PanGucheng/ISE_prj/doc/P9_ADS1115与MCP4725板级诊断工程计划.md

# finger_piano P9 ADS1115 与 MCP4725 板级诊断工程计划

> **Status**: READY_FOR_BOARD_TEST（软件准备 COMPLETE：verify/implement/bitstream 全过、SHA256 已记录；BOARD TEST = WAITING USER，烧录须用户明确授权）  
> **Scope**: 为下一次实物板测准备一个独立、可观测、低风险的 ADC/DAC 诊断 bitstream  
> **Depends on**: P1～P7；建议 P8 完成后再执行  
> **Main finger_piano project**: FROZEN  
> **Main Stage-2 top/UCF**: 不修改  
> **Hardware programming**: 本计划软件准备阶段 FORBIDDEN  
> **Board measurement**: USER + oscilloscope / logic analyzer / multimeter  
> **Purpose**: 把 ADS1115 / MCP4725 板级排故从完整电子琴中拆出来，提供确定输入、确定输出、明确状态脚

---

## 0. 当前背景

正式 Stage-2 已冻结：

```text
P31/P32        ADS1115 I2C
P102/P103      MCP4725 I2C
P110/P111/P113 note_debug
```

P7 已经独立验证 FPGA 编程链与 ISF 写入流程，并准备好 clock-test 与 Stage-2 recovery bitstream。

P9 不直接拿完整：

```text
sensor → DDS → MCP4725
ADS1115 → pressure
```

系统做第一轮外设排故。

而是建立一个最小板级诊断工程，用于回答：

```text
FPGA alive?
ADS1115 ACK?
ADS1115 是否持续产生完整三通道 frame?
MCP4725 ACK?
MCP4725 是否真正更新模拟输出?
是否发生过 I2C sticky error?
```

---

## 1. 独立工程

新增：

```text
projects/finger_piano_periph_test/
├── project.json
├── README.md
├── src/
│   └── periph_test_top.v
├── constraints/
│   └── periph_test.ucf
└── sim/
    └── tb_periph_test_top.v
```

允许直接复用正式工程的已有 RTL source 与行为模型，不复制出第二套 driver 实现。

---

## 2. 器件、时钟、复位

器件固定：

```text
xc3s50an-4-tqg144
```

时钟：

```text
P57 / 12 MHz
```

复位：

```text
P3 / rst_n
```

全工程仍只有：

```text
clk
```

一个时钟域。

---

## 3. 物理引脚冻结

P9 只使用已经确认过的引脚：

| Signal | LOC | 用途 |
|---|---:|---|
| `clk` | P57 | 12 MHz |
| `rst_n` | P3 | reset |
| `adc_i2c_scl` | P31 | ADS1115 SCL |
| `adc_i2c_sda` | P32 | ADS1115 SDA |
| `dac_i2c_scl` | P102 | MCP4725 SCL |
| `dac_i2c_sda` | P103 | MCP4725 SDA |
| `dbg_alive` | P110 | 系统 heartbeat |
| `dbg_adc` | P111 | ADC frame activity |
| `dbg_error` | P113 | sticky error |

全部：

```text
LVCMOS33
VCCO = 3.3 V
```

不新增任何 LOC。

---

## 4. 为什么复用 P110/P111/P113

P9 是独立诊断 bitstream。

因此：

```text
P110/P111/P113
```

在 P9 中可以临时重定义为：

```text
P110 = dbg_alive
P111 = dbg_adc
P113 = dbg_error
```

正式 Stage-2 的 `note_debug` 定义不修改。

---

## 5. 两条 I²C 继续独立

必须保持：

```text
ADS1115 bus:
P31/P32

MCP4725 bus:
P102/P103
```

禁止：

```text
shared SCL/SDA
arbiter
bus mux
```

---

## 6. I²C 电气规则

真实板上：

```text
SCL/SDA → pull-up → 3.3 V
```

P9 UCF 不添加：

```text
PULLUP
```

作为真实板级电阻替代。

所有 I²C 输出仍必须保持：

```text
0 / Z
```

开漏语义。

---

## 7. 顶层职责

`periph_test_top.v` 只负责：

```text
reset
+
ADS1115 controller
+
MCP4725 diagnostic source/controller
+
debug/status aggregation
```

第一版不实例化：

```text
sensor frontend
pressure processor
七音 DDS
display
UART
LM386 control
```

诊断工程越小越好。

---

## 8. dbg_alive

P110 输出 `dbg_alive`。

建议为：

```text
约 1 Hz 或 2 Hz heartbeat
```

由 12 MHz 主时钟同步计数产生 GPIO 翻转。

禁止把 heartbeat 当内部时钟。

其唯一意义是：

```text
FPGA configured
clock running
reset released
top-level alive
```

它不代表 ADC/DAC PASS。

---

## 9. dbg_adc

P111 输出 `dbg_adc`。

推荐语义：

> 每完成一个完整 ADS1115 三通道 frame，翻转一次。

不要直接输出 1 个 12 MHz 周期宽度的 `adc_sample_valid`，因为板上不容易观察。

推荐：

```text
complete ADC frame
      ↓
toggle dbg_adc
```

---

## 10. dbg_error

P113 输出 sticky error：

```text
dbg_error = adc_error OR dac_error OR dac_overrun
```

一旦发生任意错误：

```text
dbg_error = 1
```

保持到下一次 reset。

第一版不做复杂 blink code / Morse code / 多错误编码。

---

## 11. ADS1115 诊断配置冻结

继续使用当前已验证配置：

```text
address = 0x48
ADDR = GND
PGA = ±4.096 V
DR = 860 SPS
single-shot
CH0/CH1/CH2 轮询
OS polling
```

P9 不修改正式 ADS1115 driver 行为。

---

## 12. ADS1115 输入原则

第一轮板测不要求 FSR 完整标定。

可选择：

```text
AIN0 → GND
AIN1 → 已知分压
AIN2 → 另一已知分压
```

或使用真实 FSR 前端。

P9 RTL 不依赖具体输入电压。

P9 只验证：

```text
通信存在
转换存在
完整 frame 持续形成
```

不完成压力校准。

---

## 13. MCP4725 诊断模式

建议实现 compile-time / parameter：

```text
DAC_TEST_MODE
```

不新增 mode pin。

推荐四种模式：

```text
MODE 0 = 0x800 中点 DC
MODE 1 = 0x400 低值 DC
MODE 2 = 0xC00 高值 DC
MODE 3 = 1 kHz / 8 kS/s 周期波形
```

---

## 14. DAC DC 模式

### 0x800

理论：

```text
VOUT ≈ VDD/2
```

若 VDD=3.3V，约 1.65V，仅作为理论参考，实际值必须由用户测量。

### 0x400 / 0xC00

用于确认：

```text
0x400 < 0x800 < 0xC00
```

对应 VOUT 单调增加。

P9 软件不得提前声称实际电压合格。

---

## 15. 1 kHz 诊断波形

推荐：

```text
sample rate = 8 kS/s
period = 8 samples
frequency = 1 kHz
center = 2048
```

第一版优先使用独立 8-sample test waveform generator，不修改正式七音 DDS 表。

示例波形可以围绕 2048：

```text
2048
3315
3840
3315
2048
781
256
781
```

最终常量必须由 Agent 离线公式复核，并由 TB 独立验证。

---

## 16. Sample cadence

保持：

```text
12 MHz / 1500 = 8 kS/s
```

只生成 clock-enable。

禁止生成：

```text
clk_8k
```

作为第二时钟域。

---

## 17. MCP4725 协议冻结

继续：

```text
address = 0x60
Fast Write only
no EEPROM audio writes
```

P9 诊断工程不得为了“方便”写 EEPROM。

---

## 18. Reset 行为

当：

```text
rst_n = 0
```

要求：

```text
heartbeat counter reset
dbg_alive = 0
dbg_adc = 0
dbg_error = 0
ADC controller reset
DAC controller reset
两条 I2C bus release
```

释放后重新开始完整诊断流程。

---

## 19. 仿真模型

复用正式工程已有：

```text
projects/finger_piano/sim/models/ads1115_model.v
projects/finger_piano/sim/models/mcp4725_model.v
```

不要复制第二套行为模型。

---

## 20. 顶层 TB

新增：

```text
projects/finger_piano_periph_test/sim/tb_periph_test_top.v
```

必须验证：

```text
reset
heartbeat
ADS scan
ADC frame toggle
DAC write
sticky error
dual bus independence
```

并打印：

```text
TB_PERIPH_TEST_TOP: PASS
```

---

## 21. TB：heartbeat

检查 `dbg_alive` 按冻结周期翻转。

heartbeat 频率只要求确定、可测，不用于课程频率精度结论。

---

## 22. TB：ADS 正常活动

ADS model 正常响应时：

```text
dbg_adc
```

必须持续翻转。

至少验证多个完整三通道 frame。

---

## 23. TB：ADS NACK 隔离

注入 ADS NACK：

要求：

```text
dbg_error → 1
DAC bus 继续运行
```

说明 ADC 错误不能拖死 DAC。

---

## 24. TB：DAC NACK 隔离

注入 MCP4725 NACK：

要求：

```text
dbg_error → 1
ADS frame activity 继续
```

---

## 25. TB：sticky error

错误发生一次后：

```text
dbg_error = 1
```

即使总线恢复也继续保持 1。

只有：

```text
reset
```

可以清除。

---

## 26. TB：DAC DC 模式

分别测试：

```text
0x400
0x800
0xC00
```

MCP4725 model 捕获 code 必须与预期完全一致。

---

## 27. TB：1 kHz 模式

至少捕获数百个 sample，验证：

```text
8-sample sequence 重复
8 kS/s cadence
no overrun
no mismatch
no EEPROM write
```

---

## 28. 独立项目 warning policy

P9 不使用正式 `finger_piano` 的 166-warning allowlist。

> **P9-E 修正（实际结果口径）**：诊断顶层刻意不消费 ADS1115 转换值
> （§12）且 `DAC_TEST_MODE` 是编译期常量（DC 模式使 DAC 载荷恒定），
> XST 对这些结构的 trim 是**结构性的**，无法在不改动 driver 例化语义
> 的前提下消除。实际结果：**144 条 synthesis warnings，全部逐行人工
> 审核并折入本工程自己的精确 allowlist（逐条 id+pattern+expected）；
> unexpected warnings = 0；latches = 0；XST errors = 0**。任何新
> warning、路径变化或计数漂移仍判 FAIL。正式 `finger_piano` 的
> 166-warning allowlist **未修改**，两个工程的 allowlist 互不相干。

---

## 29. UCF

只允许以下 9 个用户 I/O：

```text
P57
P3
P31
P32
P102
P103
P110
P111
P113
```

以及：

```text
TS_clk = PERIOD 83.33 ns
```

禁止：

```text
PULLUP
OFFSET
自动 LOC
额外 debug pin
```

---

## 30. Verify / Implement / Bitstream

执行：

```powershell
pwsh -File .\ise.ps1 verify -Project finger_piano_periph_test
pwsh -File .\ise.ps1 build -Project finger_piano_periph_test -Stage implement
pwsh -File .\ise.ps1 build -Project finger_piano_periph_test -Stage bitstream
```

要求：

```text
verify PASS
synthesis warnings: 144 audited（工程独立 allowlist）/ 0 unexpected
latches = 0
MAP/PAR PASS
Timing Score = 0
all 9 pins LOCATED
bitstream generated
```

---

## 31. Bitstream 记录

记录：

```text
run id
SHA256
size
device
commit
DAC_TEST_MODE
```

避免板测时混淆镜像。

---

## 32. 软件阶段到此停止

软件准备完成后状态：

```text
P9 SOFTWARE PREPARATION = COMPLETE
PERIPH DIAGNOSTIC BITSTREAM = READY
BOARD TEST = WAITING USER
```

Agent 必须停止。

即使 bitstream 已生成，也禁止自动：

```text
program -Mode Jtag
program -Mode Isf
```

---

## 33. 推荐板测顺序（用户执行）

### Step 1 — 最小接线

只连接：

```text
FPGA
ADS1115
MCP4725
```

暂时不接 LM386 / speaker。

### Step 2 — JTAG volatile program

用户明确授权后写入 P9 bitstream。

先观察：

```text
P110 dbg_alive
```

如果 heartbeat 不存在，优先查 FPGA / clock / reset，不查 I2C。

### Step 3 — 检查 sticky error

若：

```text
P113 = 1
```

说明至少一个外设事务曾失败。

用逻辑分析仪分别检查：

```text
P31/P32
P102/P103
```

### Step 4 — ADS activity

观察：

```text
P111 dbg_adc
```

如果 heartbeat 正常但 P111 不动，优先检查 ADS1115 地址、供电、上拉和 ACK。

### Step 5 — 测 DAC DC

依次测：

```text
0x400
0x800
0xC00
```

确认 VOUT 单调。

### Step 6 — 测 1 kHz

测 MCP4725 VOUT：

```text
中心
幅值
频率
8 kS/s staircase
```

### Step 7 — 再接重构滤波

比较：

```text
滤波前 staircase
滤波后 smoother waveform
```

LM386 不属于本阶段。

---

## 34. 板测记录表

在 `projects/finger_piano_periph_test/README.md` 预留：

| 项目 | 理论/预期 | 实测 | 结果 |
|---|---|---|---|
| P110 heartbeat | 固定慢速翻转 | TODO | TODO |
| P111 ADC toggle | 持续活动 | TODO | TODO |
| P113 error | 正常时 0 | TODO | TODO |
| ADC SCL | 约 333 kHz | TODO | TODO |
| DAC SCL | 约 333 kHz | TODO | TODO |
| DAC 0x400 VOUT | 低于 0x800 | TODO | TODO |
| DAC 0x800 VOUT | 约 VDD/2 | TODO | TODO |
| DAC 0xC00 VOUT | 高于 0x800 | TODO | TODO |
| DAC 1kHz | 1 kHz | TODO | TODO |

所有实测值必须由用户填写。

---

## 35. 板级结论边界

即使逻辑分析仪能正确解码 I²C，也不能自动声称：

```text
I2C rise time PASS
```

上升沿必须用示波器测。

看到 ADS1115 raw code 在变化也只能证明：

```text
通信存在
转换存在
```

不能自动声称：

```text
ADC absolute accuracy PASS
```

除非已知输入电压和参考仪器都被实际测量。

---

## 36. 不填写 pressure calibration

P9 完成后：

```text
projects/finger_piano/pressure_calibration.md
```

仍保持：

```text
NOT_CALIBRATED
```

除非用户实际完成 FSR + 模拟前端采样。

---

## 37. Stage-2 Recovery

P9 板测完成后是否恢复：

```text
finger_piano_stage2_top
```

由用户决定。

Agent 不得自动写回 Stage-2 ISF。

---

## 38. 推荐提交序列

### P9-A — Plan + Project Skeleton

新增：

```text
doc/P9_ADS1115与MCP4725板级诊断工程计划.md
projects/finger_piano_periph_test/
```

### P9-B — Debug/Status Top

实现：

```text
dbg_alive
dbg_adc
dbg_error
```

以及双 I²C controller 接线。

### P9-C — DAC Diagnostic Modes

加入：

```text
0x400
0x800
0xC00
1 kHz waveform
```

### P9-D — Simulation

覆盖：

```text
normal
ADC NACK
DAC NACK
sticky error
reset
DC modes
1 kHz mode
```

### P9-E — Verify / Implement / Bitstream

要求：

```text
verify PASS（warnings: 144 audited / 0 unexpected，见 §28 修正）
fully routed
timing pass
SHA256 recorded
```

### P9-F — Docs Closeout

状态更新为：

```text
READY_FOR_BOARD_TEST
```

并停止。

---

## 39. Agent 停止条件

发生任一项必须停止：

```text
新增未确认 LOC
synthesis warning
second clock domain
I2C bus 被共享
ADC/DAC driver 被重写
EEPROM write path 被启用
仿真回归 FAIL
正式 finger_piano 被功能修改
需要硬件 program
```

---

## 40. 严禁行为

Agent 不得：

```text
修改正式 Stage-2 UCF
修改正式 pin map
修改 finger_piano warning allowlist
猜 FSR 校准数据
猜 ADS1115 实测电压
声称 DAC 模拟输出已通过
声称 LM386 已通过
自动 JTAG program
自动 ISF program
自动写 recovery bitstream
```

---

## 41. 最终软件验收清单

```text
[ ] finger_piano_periph_test 独立工程存在
[ ] 正式 finger_piano 未改
[ ] clk = P57
[ ] rst_n = P3
[ ] ADC = P31/P32
[ ] DAC = P102/P103
[ ] debug = P110/P111/P113

[ ] 双 I2C 独立
[ ] open-drain 0/Z
[ ] 无内部 PULLUP
[ ] 无第二时钟域

[ ] heartbeat 存在
[ ] ADC frame toggle 存在
[ ] sticky error 存在

[ ] DAC 0x400 模式 PASS
[ ] DAC 0x800 模式 PASS
[ ] DAC 0xC00 模式 PASS
[ ] DAC 1kHz 数字波形模式 PASS

[ ] ADC NACK isolation PASS
[ ] DAC NACK isolation PASS
[ ] reset recovery PASS

[ ] synthesis 0 errors
[ ] synthesis warnings 144 audited / 0 unexpected（本工程独立 allowlist；
    正式 finger_piano 166 条未修改）
[ ] synthesis 0 latches
[ ] MAP/PAR PASS
[ ] timing PASS
[ ] 9 pins LOCATED
[ ] bitstream SHA256 recorded

[ ] 未执行 program
[ ] BOARD TEST = WAITING USER
[ ] FSR = NOT_CALIBRATED
[ ] LM386 = NOT_TESTED
[ ] SPEAKER = NOT_TESTED
```

---

## 42. Agent 执行提示

> 按本计划建立独立 `projects/finger_piano_periph_test`，复用现有 ADS1115/MCP4725/I2C RTL 和已有行为模型，不修改正式 `finger_piano`。诊断顶层固定使用 P57/P3、ADS P31/P32、DAC P102/P103、debug P110/P111/P113；debug 定义为 alive / ADC frame toggle / sticky error。加入 DAC 0x400、0x800、0xC00 与固定 1 kHz/8 kS/s 诊断波形模式。要求独立工程 synthesis 0 warning、仿真全 PASS、implement/timing PASS、bitstream SHA256 记录。软件准备完成后立即停止；禁止任何 JTAG/ISF program，等待用户明确授权。
