PanGucheng/ISE_prj/doc/P6最终顶层迁移与系统级数字集成计划.md

---

# finger_piano P6 最终顶层迁移与系统级数字集成计划

> **Status**: P6A COMPLETE + **P6B COMPLETE**（STAGE2 TOP = IMPLEMENTED / SIMULATED / IMPLEMENTED；BOARD = NOT_TESTED）
> **Scope**: stage-2 system integration + system-level ISim + gated top/UCF migration
> **Depends on**: P1 + P2 + P3 + P4 + P5 全部 `SIMULATED / STANDALONE`
> **Top integration**: P6A NO → P6B YES（用户 2026-09-16 逐脚确认后完成）
> **UCF changes**: 已完成（12 脚冻结分配）
> **Hardware programming**: FORBIDDEN，除非用户之后单独明确要求
> **Acceptance**: system-level simulations + full `verify` + final top/UCF review

---

## 0.1 P6B 完成记录（2026-09-16）

```text
P6A SYSTEM CORE      INTEGRATED / SIMULATED
STAGE2 TOP           IMPLEMENTED（src/finger_piano_stage2_top.v,wrapper only）
STAGE2 TOP SIM       PASS（sim/tb_finger_piano_stage2_top.v,29 checks）
UCF                  CONFIRMED / FROZEN
IMPLEMENTATION       PASS（MAP/PAR 0/0,全布线,Timing Score 0）
TIMING               PASS（TS_clk = PERIOD 83.33 ns,0 timing errors,最差 slack 70.968 ns）

BOARD                  NOT_TESTED
FSR CALIBRATION        NOT_CALIBRATED
MCP4725 ANALOG OUTPUT  NOT_TESTED
LM386 / SPEAKER        NOT_TESTED
```

最终引脚（用户 2026-09-16 确认,全部 LVCMOS33,VCCO 全 3.3 V）：

| Signal | LOC | Bank |
|---|---|---|
| clk | P57 | 2 |
| rst_n | P3 | 3 |
| sensor_async[0..2] | P28/P29/P30 | 3 |
| adc_i2c_scl/sda | P31/P32 | 3 |
| dac_i2c_scl/sda | P102/P103 | 1 |
| note_debug[0..2] | P110/P111/P113 | 0 |

证据：全量 `verify-20260916-153554-00e49086` Overall PASS（综合 0 errors /
166 已审阅 trim 告警 / 0 unexpected / 0 latches / 12 IOs；33 仿真全 PASS）；
实现 `20260916-154225-79f5b654`；详细记录见
`projects/finger_piano/README.md` §13 第十四轮。当前 12 脚顶层无压力数据
消费方，ADS1115 压力链被 XST 合法 trim（已审阅白名单），
`pressure_calibration.md` 仍为 `NOT_CALIBRATED`。**未执行任何 `program`。**

---

## 0. 当前前提

P1～P5 已完成独立 RTL 和仿真：

```text
P1:
i2c_master
ads1115_ctrl
mcp4725_ctrl

P2:
sensor_code_frontend
sensor_code_filter
sensor_code_decoder

P3:
dds_sine_generator
sine_lut_12bit

P4:
dds_mcp4725_pipeline

P5:
pressure_frame_capture
pressure_channel_corrector
pressure_processor
```

当前正式顶层仍为 legacy：

```text
key_in[6:0]
  ↓
key_sync
  ↓
key_filter
  ↓
note_encoder
  ↓
tone_generator
  ↓
audio_out
```

这条路径在本计划第一阶段仍然保持不动。

---

# 1. 本阶段最终目标

最终数字结构：

```text
                     ┌──────────────────────────────┐
LM393 ×3             │                              │
   ↓                 │                              │
sensor_async[2:0]    │                              │
   ↓                 │                              │
sensor_code_frontend │                              │
   ↓                 │                              │
note_code[2:0] ──────┼────→ DDS → MCP4725 ctrl ───┼→ DAC I2C
                     │                              │
                     │                              │
ADS1115 I2C ─────────┼→ ads1115_ctrl                │
                     │       ↓                      │
                     │   raw CH0/1/2                │
                     │       ↓                      │
                     │ pressure_processor           │
                     │       ↓                      │
                     │ pressure CH0/1/2             │
                     └──────────────────────────────┘
```

注意：

> P6 只负责把现有模块连接成完整系统。

本阶段仍然**不决定压力如何映射到音量或音高**。

所以压力链：

```text
ADS1115 → pressure_processor
```

先正常工作、输出数据即可。

它不能偷偷影响 DDS amplitude、phase 或 note selection。

---

# 2. 为什么不直接修改 `finger_piano_top.v`

现在仍有两个现实条件没有完成：

```text
1. 3 × LM393 的最终 FPGA LOC 未逐脚确认
2. ADC/DAC 两套 I²C 的 4 个最终 LOC 未逐脚确认
```

因此如果现在直接把正式 top 改成 stage-2：

```text
project top
→ 多出 7 个真实 I/O
→ UCF 尚无确认 LOC
```

就会破坏目前已经验证的 implementation baseline。

所以 P6 分成：

```text
P6A：纯数字系统集成
     不改正式 top / 不改 UCF

P6B：板级顶层迁移
     只有用户确认 7 个接口信号后才能执行
```

P6A 可以立即由 Agent 完成。

P6B 必须等待人工确认。

---

# 3. 第一件事：先做文档 closeout

在写新 RTL 前先做一个很小的文档提交。

修复：

```text
P1 plan Status: PLANNED
→ IMPLEMENTED / SIMULATED / STANDALONE

P5 plan Status: PLANNED
→ IMPLEMENTED / SIMULATED / STANDALONE / NOT_CALIBRATED
```

同时修复：

```text
README 中：
P2/P4/P5 “X 个提交”数量措辞
旧 stage-1 当前时态
旧 P1..P40 可用范围措辞
```

推荐不要修改历史验证结果，只给旧章节增加：

```markdown
> 本节记录 legacy stage-1 baseline。
> 当前 P1~P5 扩展状态见 §12。
```

---

# 4. `CFG_DDS_PHASE_BITS` 收尾

当前：

```verilog
`define CFG_DDS_PHASE_BITS 24
```

但 DDS RTL 本身固定：

```verilog
reg [23:0] phase_acc;
```

P6 前建议消除这个伪参数。

推荐：

> 保持 DDS 24-bit 固定实现，删除或明确废弃 `CFG_DDS_PHASE_BITS`。

不要为了泛化而重构 DDS。

24-bit 已经满足本项目要求。

---

# 5. 新增 system core

建议新增：

```text
projects/finger_piano/src/system/
    finger_piano_system.v
```

这个模块不是 FPGA package top。

它是：

> **stage-2 逻辑系统边界。**

---

# 6. 推荐 `finger_piano_system` 接口

建议：

```verilog
module finger_piano_system #(
    parameter integer SYS_CLK_HZ = `SYS_CLK_HZ,
    parameter integer SENSOR_ACTIVE_HIGH = 1,
    parameter integer SENSOR_FILTER_ENABLE = 1,
    parameter integer ENABLE_ADC = 1,
    parameter integer ENABLE_DAC = 1
) (
    input  wire        clk,
    input  wire        rst_n_sync,

    input  wire [2:0]  sensor_async,

    inout  wire        adc_i2c_scl,
    inout  wire        adc_i2c_sda,

    inout  wire        dac_i2c_scl,
    inout  wire        dac_i2c_sda,

    output wire [2:0]  sensor_code_stable,
    output wire [2:0]  note_code,

    output wire [14:0] pressure_ch0,
    output wire [14:0] pressure_ch1,
    output wire [14:0] pressure_ch2,
    output wire        pressure_valid,

    output wire        adc_error,
    output wire        dac_error,
    output wire        dac_overrun
);
```

不要在这里加入：

```text
physical pin
key_in[6:0]
legacy audio_out
LM386 analog control
display driver
volume control
```

这些不是 system core 的职责。

---

# 7. Reset仍然只在外层产生一次

当前 legacy top 已有：

```text
rst_n
 ↓
reset_sync
 ↓
rst_n_sync
```

stage-2 system core 输入直接使用：

```text
rst_n_sync
```

因此：

> `finger_piano_system.v` 不得再次实例化 `reset_sync`。

未来正式 top：

```text
rst_n
 ↓
reset_sync
 ↓
rst_n_sync
 ├→ sensor frontend
 ├→ ADC
 ├→ DAC
 └→ pressure processor
```

所有模块共用一个同步释放复位。

---

# 8. 音符输入链连接

直接实例化：

```text
sensor_code_frontend
```

结构：

```text
sensor_async[2:0]
     ↓
polarity normalization
     ↓
2FF synchronization
     ↓
whole-vector atomic filter
     ↓
sensor_code_stable
     ↓
decoder
     ↓
note_code
```

禁止重新实现：

```text
key_sync
filter
decoder
```

P6 只能复用 P2。

---

# 9. P6 中不再存在 `key_in[6:0]`

stage-2 system core：

```text
没有 key_in[6:0]
```

真实输入只有：

```text
sensor_async[2:0]
```

也不要在 system core 内做：

```text
7-key ↔ 3-bit compatibility mux
```

legacy compatibility 保留在原：

```text
finger_piano_top
```

而不是污染新架构。

---

# 10. DDS/DAC连接

直接实例化已有：

```text
dds_mcp4725_pipeline
```

输入：

```text
note_code
```

输出：

```text
dac_i2c_scl
dac_i2c_sda
dac_error
dac_overrun
```

即：

```text
sensor frontend
      ↓
note_code
      ↓
dds_mcp4725_pipeline
      ↓
MCP4725 I2C
```

P6 不重新实例化：

```text
dds_sine_generator + mcp4725_ctrl
```

因为 P4 wrapper 已经定义了这个边界。

---

# 11. ADC/压力连接

实例化：

```text
ads1115_ctrl
        ↓
pressure_processor
```

具体：

```text
ads1115_ctrl.adc_ch0_raw
        ↓
pressure_processor.adc_ch0_raw

ads1115_ctrl.adc_ch1_raw
        ↓
pressure_processor.adc_ch1_raw

ads1115_ctrl.adc_ch2_raw
        ↓
pressure_processor.adc_ch2_raw

ads1115_ctrl.adc_sample_valid
        ↓
pressure_processor.adc_sample_valid
```

最后输出：

```text
pressure_ch0
pressure_ch1
pressure_ch2
pressure_valid
```

---

# 12. 压力链与音符链保持解耦

系统级结构必须保持：

```text
LM393
 ↓
note selection
```

和：

```text
ADS1115
 ↓
pressure magnitude
```

互相独立。

不要写：

```verilog
if (pressure_ch0 > ...)
    note_code = ...
```

也不要：

```verilog
dac_code = dac_code * pressure;
```

这些属于后续 P7：

> 压力到音量控制映射计划

不是 P6。

---

# 13. ADS 与 DAC 仍是两条独立 I²C

system core 端口必须是：

```text
adc_i2c_scl
adc_i2c_sda

dac_i2c_scl
dac_i2c_sda
```

不能合成：

```text
i2c_scl
i2c_sda
```

也不能添加：

```text
arbiter
shared bus scheduler
```

P1 的双总线架构继续冻结。

---

# 14. system core 不产生物理 `audio_out`

stage-2 数字音频真正的物理输出已经变成：

```text
MCP4725 VOUT
```

不是 FPGA 方波。

所以：

```text
finger_piano_system
```

不需要：

```text
audio_out
```

输出。

legacy `finger_piano_top.audio_out` 仍然继续存在，直到最终顶层迁移。

---

# 15. 新增系统级行为模型 TB

建议新增：

```text
sim/tb_finger_piano_system.v
```

同时复用：

```text
sim/models/ads1115_model.v
sim/models/mcp4725_model.v
```

完整仿真：

```text
sensor input
     ↓
P2 frontend
     ↓
note_code
     ↓
P4 DDS/DAC pipeline
     ↓
MCP model

同时：

ADS model
     ↓
ADS controller
     ↓
pressure processor
```

这是目前还没有的真正**全系统数字仿真**。

---

# 16. System TB的核心目标

P1～P5 各自 PASS 不代表组合系统必然 PASS。

必须证明：

```text
两个 I2C controller 同时工作
+
sensor frontend 同时工作
+
DDS 8k cadence 同时工作
+
ADC continuous scan 同时工作
+
pressure processing 同时工作
```

在：

```text
12 MHz
```

唯一系统时钟下不会互相干扰。

---

# 17. 必测初始化

Reset 时：

```text
note_code = 0
sensor_code_stable = 000

pressure = 0

DAC pipeline idle/reset
ADC controller reset

两条 I2C bus release
```

释放 reset 后：

```text
ADC 开始独立扫描
DAC 等 DDS sample
```

不得出现 X propagation。

---

# 18. 系统级 Sensor → Note → DAC 测试

至少完整走：

```text
000
001
010
011
100
101
110
111
000
```

要求每次只有在：

```text
whole-vector filter
```

达到稳定门限后：

```text
note_code
```

才改变。

MCP4725 捕获的数字音频随后必须对应：

```text
mute
C4
D4
E4
F4
G4
A4
B4
mute
```

---

# 19. 中间码污染测试

重点刺激：

```text
001
 ↓
011 short
 ↓
101 short
 ↓
111 stable
```

只允许：

```text
C4
↓
B4
```

DAC端不能出现：

```text
E4
G4
```

的持续音频流。

这一测试第一次真正跨越：

```text
sensor filter
→ decoder
→ DDS
→ I2C DAC
```

非常重要。

---

# 20. ADC与DAC同时运行测试

P1 之前的 ADC 和 DAC 是分开测的。

现在必须让：

```text
ADS1115 controller
```

和：

```text
DDS → MCP4725
```

在同一个 TB 中同时连续工作。

验证至少：

```text
ADC bus transaction count > 0
DAC bus transaction count > 0

ADC error = 0
DAC error = 0
DAC overrun = 0
```

证明两条独立总线没有 RTL 级共享状态。

---

# 21. Pressure全链路同时验证

ADS模型设置：

```text
CH0 = 1000
CH1 = 2000
CH2 = 3000
```

zero先使用默认：

```text
0 / 0 / 0
```

应得到：

```text
1000
2000
3000
```

再通过 TB 参数覆盖：

```text
100 / 200 / 300
```

应得到：

```text
900
1800
2700
```

这只是数字校正测试。

不能写：

```text
实物压力值
```

---

# 22. ADC数据变化不能影响当前音符

例如：

```text
sensor_code = 001
```

持续保持。

同时让 ADS：

```text
CH0:
500 → 5000 → 20000
```

要求：

```text
note_code始终 = C4
```

当前 P6 中 DAC 频率也不能改变。

这样可以锁死：

> 压力链和音符选择链没有意外耦合。

---

# 23. 音符变化不能破坏ADC扫描

反过来不断切：

```text
001
111
010
101
...
```

同时检查：

```text
adc_sample_valid
```

继续正常产生。

不允许因为 DDS / DAC 事务影响 ADS FSM。

---

# 24. 双I²C独立性故障测试

在 ADC 总线上注入：

```text
address NACK
```

同时 DAC 保持播放。

要求：

```text
ADC error = 1
```

但：

```text
DAC继续发送
DAC error = 0
DAC overrun = 0
```

反过来 DAC NACK：

```text
DAC error
```

不能影响：

```text
ADC frame
pressure_valid
```

这是真正验证“双物理总线”的关键系统级测试。

---

# 25. Reset系统级恢复

在以下状态下拉 reset：

```text
ADC 正在 I2C transaction
+
DAC 正在 Fast Write
```

要求：

```text
两个 bus 均释放

ADC busy清理
DAC busy清理

sensor stable恢复000
note_code恢复mute
pressure outputs恢复0
```

释放后：

```text
ADC重新开始完整scan
DAC重新开始完整Fast Write
```

不能延续半截事务。

---

# 26. 系统级长时间压力测试

推荐真实参数：

```text
SYS_CLK = 12 MHz
DAC fs = 8 kS/s
DAC I2C ≈333 kHz
ADC DR = 860 SPS
```

连续运行至少：

```text
8192 DAC samples
```

约：

```text
1.024 s audio time
```

期间：

```text
DAC mismatch = 0
DAC overrun = 0
DAC error = 0

ADC valid frames > 0
ADC error = 0

sensor code errors = 0
```

---

# 27. 不要求ADC达到严格固定frame rate

ADS1115：

```text
single-shot
+
三通道轮询
+
OS polling
```

所以 frame cadence不是固定精确周期。

System TB只要求：

```text
持续取得frame
不死锁
顺序正确
数值正确
```

不要像 DDS 那样强制每：

```text
N clocks
```

一个frame。

---

# 28. ENABLE组合测试

建议 system core 参数化：

```text
ENABLE_ADC
ENABLE_DAC
```

至少验证：

| ADC | DAC | 预期 |
| --- | --- | --- |
| 0 | 0 | 两总线静默 |
| 1 | 0 | ADC运行，DAC静默 |
| 0 | 1 | DAC运行，ADC静默 |
| 1 | 1 | 两条总线同时运行 |

这比单纯分别测 P1 更接近最终 integration。

---

# 29. 不增加系统级大FSM

`finger_piano_system.v` 应尽量只是：

```text
wiring + status aggregation
```

不要写：

```text
SYSTEM_IDLE
SYSTEM_ADC
SYSTEM_DAC
SYSTEM_RUN
```

这种总控 FSM。

ADC、DAC、sensor frontend 自己已经有状态机。

顶层不应该再调度它们。

---

# 30. 系统级 error输出

建议只汇总：

```text
adc_error
dac_error
dac_overrun
```

不要现在设计复杂：

```text
global_error_code[7:0]
```

因为：

```text
ADC error domain
DAC error domain
```

语义不同。

以后显示/调试层可独立处理。

---

# 31. `project.json` 第一阶段变更

P6A 时加入：

```text
src/system/finger_piano_system.v
```

和：

```text
sim/tb_finger_piano_system.v
```

以及模型依赖。

但：

```json
"top": "finger_piano_top"
```

仍保持不变。

所以现有正式 implementation 继续是 legacy。

---

# 32. 推荐新增 simulation

建议至少：

```text
system_stage2_basic
system_stage2_dual_i2c
system_stage2_error_isolation
system_stage2_longrun
system_stage2_disabled
```

统一：

```text
TB_FINGER_PIANO_SYSTEM: PASS
```

---

# 33. 第一阶段的综合资源预期

由于：

```text
finger_piano_system
```

仍未被正式 top 引用，

legacy synthesis 应继续：

```text
232 FF
20 I/O
```

左右保持不变。

如果资源突然大幅增加：

> 说明不小心已经把 stage-2 接进 legacy top。

P6A 应立即停止检查。

---

# 34. P6A验收线

P6A 完成时必须同时满足：

```text
legacy top unchanged

stage2 system TB PASS

P1 TB PASS
P2 TB PASS
P3 TB PASS
P4 TB PASS
P5 TB PASS

full verify PASS

legacy synthesis:
0 errors
0 warnings
0 latches
I/O count unchanged
```

完成后状态：

```text
SYSTEM DIGITAL INTEGRATION
= SIMULATED / STANDALONE

FINAL TOP
= NOT MIGRATED
```

---

# 35. P6B启动的唯一人工阻塞

P6B开始前必须由用户确认：

```text
sensor_async[0] → ?
sensor_async[1] → ?
sensor_async[2] → ?

adc_i2c_scl → ?
adc_i2c_sda → ?

dac_i2c_scl → ?
dac_i2c_sda → ?
```

这是：

> **7个逻辑接口信号的最终引脚确认**

不一定代表需要“新增7个物理引脚”。

可以复用 legacy 迁移释放的 GPIO。

---

# 36. 推荐引脚决策记录格式

最终确认后在文档写：

| Signal | LOC | Bank/VCCO | IOSTANDARD | External circuit |
| --- | --- | --- | --- | --- |
| sensor_async[0] | Pxx | verified  | LVCMOS33 | LM393 CH0 |
| sensor_async[1] | Pxx | verified  | LVCMOS33 | LM393 CH1 |
| sensor_async[2] | Pxx | verified  | LVCMOS33 | LM393 CH2 |
| adc_i2c_scl | Pxx | verified  | LVCMOS33 | ADS1115 SCL |
| adc_i2c_sda | Pxx | verified  | LVCMOS33 | ADS1115 SDA |
| dac_i2c_scl | Pxx | verified  | LVCMOS33 | MCP4725 SCL |
| dac_i2c_sda | Pxx | verified  | LVCMOS33 | MCP4725 SDA |

没有：

```text
Bank VCCO
```

确认时不能只凭 package pin 可用就写 LOC。

---

# 37. P6B正式顶层选择

建议不要直接在 legacy `finger_piano_top.v` 上大面积编辑。

更安全的方案是新增：

```text
src/finger_piano_stage2_top.v
```

端口：

```verilog
module finger_piano_stage2_top (
    input  wire       clk,
    input  wire       rst_n,

    input  wire [2:0] sensor_async,

    inout  wire       adc_i2c_scl,
    inout  wire       adc_i2c_sda,

    inout  wire       dac_i2c_scl,
    inout  wire       dac_i2c_sda,

    output wire [2:0] note_debug
);
```

内部：

```text
reset_sync
+
finger_piano_system
```

这样 legacy top 完全保留。

---

# 38. 为什么建议新增 stage2 top

这样仓库同时保留：

```text
finger_piano_top
    = legacy baseline

finger_piano_stage2_top
    = final 3-sensor architecture
```

出问题时可以快速比较。

而不是：

```text
永久覆盖旧 top
```

后再靠 Git history 找。

这对课程答辩也有价值：

> 可以清楚展示基础版本和提高版本。

---

# 39. project top最终切换

只有 P6B 才修改：

```json
"top": "finger_piano_stage2_top"
```

并同步修改 UCF。

切换应该单独一个 commit。

这样任何 regression 都可以清楚定位到：

> final top cutover

而不是混在其它 RTL 提交里。

---

# 40. Legacy端口如何处理

stage2 top 不再需要：

```text
key_in[6:0]
key_debug[6:0]
audio_out
```

其中：

```text
audio_out
```

在 DDS/DAC 模式下也不再承担音频输出。

真实音频由：

```text
MCP4725 VOUT
```

进入 LM386。

所以 final stage2 UCF 应移除这些 legacy NET，除非用户明确想保留调试兼容。

---

# 41. 推荐保留 `note_debug`

建议 stage2 至少保留：

```text
note_debug[2:0]
```

原因是上板初期非常有价值：

```text
LM393
→ FPGA
→ stable code
→ decoder
```

是否正确可以直接观察。

如果 IO紧张，也可以后续删除。

---

# 42. 不建议保留 `key_debug[6:0]`

真实硬件已经不是7键。

如果需要 sensor debug，更合理的是：

```text
sensor_debug[2:0]
```

但是否保留由最终 IO预算决定。

本计划不强制。

---

# 43. Stage2 UCF重写原则

P6B时不要在原 legacy UCF 上零碎追加到最后。

推荐分区重整：

```text
CLOCK
RESET

SENSOR CODE INPUT

ADC I2C

DAC I2C

DEBUG

TIMING
```

删除已经不再是 top port 的：

```text
key_in
key_debug
audio_out
```

约束。

---

# 44. I²C上拉仍然是板级器件

UCF只写：

```text
LOC
IOSTANDARD=LVCMOS33
```

不能用 UCF 假装：

```text
4.7k pullup
```

真实 ADS/DAC 总线需要：

```text
SDA → 4.7k → 3.3V
SCL → 4.7k → 3.3V
```

两条总线分别检查模块自带上拉。

---

# 45. `constraintsReviewed`

P6B改 UCF 后：

> 不得沿用 legacy 的“已确认”结论直接声称新约束已审核。

应先将新 7 个接口逐个确认，然后重新检查：

```text
LOC
IOSTANDARD
VCCO
clock
reset
timing
```

只有完成后：

```text
constraintsReviewed=true
```

才有意义。

---

# 46. P6B新增正式top仿真

新增：

```text
tb_finger_piano_stage2_top.v
```

重点不是重复 system TB，而是验证：

```text
external rst_n
→ reset_sync
→ system

external sensor_async
→ system

top ports
→ I2C model
```

防止 wrapper 接错。

---

# 47. 顶层仿真至少覆盖

```text
reset
mute
C4
B4
mute

ADC frame
DAC output

both I2C active

sensor transition
```

以及：

```text
no X / Z misuse
```

注意：

I²C 线正常高电平来自 TB `pullup`。

---

# 48. 切换后必须重新综合

切换真正 stage2 top 后：

```text
232 FF / 20 IO
```

不再是期望值。

资源增长是正常的。

必须记录新的：

```text
FF
LUT
IO
```

基线。

此时才可以说：

> 新基础设施进入综合网表。

---

# 49. 新I/O数量预期

stage2最小顶层：

```text
clk           1
rst_n         1
sensor        3
ADC I2C       2
DAC I2C       2
note_debug    3 optional
```

若保留 note_debug：

```text
12 I/O
```

若不保留：

```text
9 I/O
```

实际数量以最终 top 为准。

不要把：

```text
20 I/O
```

继续当作 stage2验收标准。

---

# 50. Implement / timing

P6B UCF确认后运行：

```powershell
pwsh -File .\ise.ps1 verify -Project finger_piano
```

随后：

```powershell
pwsh -File .\ise.ps1 build -Project finger_piano -Stage implement
```

人工检查：

```text
MAP
PAR
timing.twr
```

仍然必须：

```text
0 errors
0 warnings
```

---

# 51. I²C时序不能仅靠静态时序报告判断

ISE timing 可以验证 FPGA 内部路径。

它不能证明：

```text
4.7k pullup
+
board capacitance
+
real SDA/SCL rise time
```

符合要求。

因此 stage2 implement PASS 之后状态仍只能是：

```text
DIGITAL IMPLEMENTATION PASS
```

不能：

```text
I2C BOARD PASS
```

---

# 52. 本计划不烧录

即使：

```text
stage2 bitstream
```

已经成功生成，

Agent仍然不能自动执行：

```text
program -Mode Jtag
program -Mode Isf
```

因为真实板级输入/输出已经发生变化。

第一次 stage2 烧录必须由用户明确要求。

---

# 53. P6完成后的状态

完成 P6A：

```text
P1~P5                  SIMULATED
SYSTEM DIGITAL CORE    SIMULATED
FINAL TOP              LEGACY
BOARD                   NOT TESTED
```

完成 P6B：

```text
P1~P5                  INTEGRATED
STAGE2 TOP             IMPLEMENTED
STAGE2 SYSTEM          SIMULATED
UCF                    CONFIRMED
BITSTREAM              BUILDABLE
BOARD                   NOT TESTED
```

只有后续真实上板后才能进一步变成：

```text
BOARD TESTED
```

---

# 54. 推荐提交顺序

### Commit A — documentation closeout

只修：

```text
P1/P5 status
README stale wording
commit/stage wording
38-pin pool wording
CFG_DDS_PHASE_BITS语义
```

不改功能 RTL。

---

### Commit B — system core

新增：

```text
src/system/finger_piano_system.v
```

只做连接。

单独 syntax / simulation。

---

### Commit C — basic system TB

新增：

```text
tb_finger_piano_system.v
```

验证：

```text
sensor → note → DAC
ADS → pressure
```

---

### Commit D — dual-bus/error isolation

加入：

```text
ADC + DAC simultaneous activity
ADC NACK isolation
DAC NACK isolation
mid-transaction reset
```

---

### Commit E — longrun/full verify

真实：

```text
12 MHz
8 kS/s
dual I2C
```

运行长时间系统 TB。

随后：

```text
full verify
```

P6A到此冻结。

---

### Commit F — stage2 top

**仅用户确认7个接口引脚后执行。**

新增：

```text
finger_piano_stage2_top.v
tb_finger_piano_stage2_top.v
```

但尚可暂不切 project top。

---

### Commit G — UCF / top cutover

修改：

```text
project.json top
UCF
```

运行：

```text
verify
implement
```

记录新的资源基线。

---

### Commit H — documentation

更新：

```text
doc/README.md
projects/finger_piano/README.md
P6 plan
```

明确：

```text
INTEGRATED
NOT_BOARD_TESTED
```

---

# 55. P6A最终验收清单

```text
[ ] P1~P5文档状态已收尾
[ ] legacy top仍未修改
[ ] legacy UCF功能约束未修改

[ ] finger_piano_system.v存在
[ ] 仅复用现有P1~P5模块
[ ] 不复制ADC/DAC/DDS/filter逻辑
[ ] 不增加系统总控FSM

[ ] sensor_async → frontend → note_code正确
[ ] note_code → DDS→MCP4725正确
[ ] ADS1115 → pressure_processor正确

[ ] ADC和DAC两条I2C完全独立
[ ] 两条总线同时工作PASS
[ ] ADC错误不影响DAC
[ ] DAC错误不影响ADC

[ ] whole-vector filter中间码不会进入DAC音频
[ ] 压力变化不改变note_code
[ ] note变化不影响ADC扫描

[ ] reset期间两总线释放
[ ] mid-transaction reset可恢复

[ ] system longrun PASS
[ ] dac_overrun=0
[ ] dac_error=0
[ ] adc_error=0
[ ] scoreboard mismatch=0

[ ] full verify PASS
[ ] XST 0 errors
[ ] XST 0 warnings
[ ] XST 0 latches

[ ] legacy synthesized FF/I/O未意外变化
[ ] 未执行program
```

---

# 56. P6B最终验收清单

只有收到用户逐脚确认后才能执行：

```text
[ ] sensor_async[0] LOC confirmed
[ ] sensor_async[1] LOC confirmed
[ ] sensor_async[2] LOC confirmed

[ ] ADC_SCL LOC confirmed
[ ] ADC_SDA LOC confirmed

[ ] DAC_SCL LOC confirmed
[ ] DAC_SDA LOC confirmed

[ ] 所有相关Bank VCCO确认3.3V
[ ] IOSTANDARD确认LVCMOS33

[ ] stage2 top新增
[ ] legacy top仍保留
[ ] project.json top切换
[ ] legacy无效NET从UCF移除
[ ] 新7接口写入UCF

[ ] stage2 top TB PASS
[ ] full verify PASS
[ ] implement PASS
[ ] 0 errors
[ ] 0 warnings
[ ] timing.twr人工复核

[ ] 新资源/I/O基线已记录

[ ] 未自动烧录
[ ] 状态仍为NOT_BOARD_TESTED
```

---
