PanGucheng/ISE_prj/doc/ADS1115与MCP4725可选外设开发计划.md

# finger_piano 可选 ADC/DAC 驱动基础设施

> **Status**: IMPLEMENTED / SIMULATED / STANDALONE（已仿真通过，默认关闭，未接顶层，未上板）
> **Scope**: standalone I²C / ADS1115 / MCP4725 驱动 RTL + ISim（不改顶层，两个外设默认关闭）
> **Depends on**: ISE 工具链（无前置计划）
> **Top integration**: NO
> **UCF changes**: NO
> **Hardware programming**: FORBIDDEN
> **Acceptance**: full `verify`（`.\ise.ps1 verify -Project finger_piano`）

## 本阶段目标

为 `projects/finger_piano` 增加经过 ISim 仿真的 **ADS1115 / MCP4725 可选驱动基础设施**。默认配置两个外设都关闭，**不启用**模拟采集、不改方波音频路径、不猜 I²C 管脚、不实现 DDS。

**当前软件基线（legacy baseline）** 保持不变：

`LM393 → key_in[6:0] → 同步/滤波 → 7 路优先级编码器 → 整数分频方波 → audio_out`

这是为了不破坏已验证课设路径而保留的 **7 键 RTL**。它 **不是** 最终硬件形态。真实板卡是 **3 个 LM393 数字输出组成 3-bit 编码**（见下文「后续架构迁移」）。本阶段不得把 7 键路径改成 3-bit 译码。

验收主入口仍是：

```powershell
pwsh -File .\ise.ps1 verify -Project finger_piano
```

必须：现有 6 个仿真继续 PASS；默认综合 0 error / 0 warning；implement 不被新端口拖垮。

## 明确不做

- 不把 `CFG_ENABLE_ADS1115` / `CFG_ENABLE_MCP4725` 设为 1
- **不把这组宏写成“只改一处即可启用系统”**（见「ENABLE 宏语义」）
- 不改 `tone_generator` / `audio_out`，不引入 `AUDIO_MODE` / DDS / 正弦 LUT
- 不写 MCP4725 EEPROM（禁止 `C2,C1,C0 = 0,1,1`）
- 不用 ADS1115 `ALERT/RDY`，不用 Hs-mode（3.4 MHz）
- 不把压力判断、音符编码塞进 ADC driver
- **不给 `adc_i2c_*` / `dac_i2c_*` 填 UCF LOC**（BOARD TODO）
- 不改工具链、不烧录、不改现有 7 路数字键引脚
- **不把 7 路优先级编码器改成 3-bit 二进制译码**（上板前另一次迁移，本阶段禁止）
- 不把任务书示例的 2 MHz 时钟套到本工程（板上是 **12 MHz / P57**）
- 不把板上默认 I²C 做成刚好 400 kHz；不对默认宏套 `ceil(12e6/333333)=37` 当拍数
- 不在 `i2c_master` 里区分地址 NACK / 数据 NACK；controller 不得省略 `I2C_HZ` 参数、不得只读全局速度宏
- 不用 latest-value-wins 作为 MCP4725 的默认缓冲策略

## 现状（必须保住）

| 项 | 值 |
|---|---|
| 工程 | `projects/finger_piano` |
| 器件 | `xc3s50an-4-tqg144` |
| 顶层 | `finger_piano_top`，端口仅 `clk/rst_n/key_in/audio_out/key_debug/note_debug` |
| 按键 RTL | **legacy baseline**：`key_in[6:0]` + 7 路优先级编码器（1>2>…>7）。**不是最终硬件。** |
| 时钟 | `` `SYS_CLK_HZ = 12000000 ``（`src/finger_piano_cfg.vh` 唯一真值源） |
| 配置 | `constraintsReviewed=true`，UCF 已有真实 LOC，`expectImplementationBlocked=false` |
| 综合策略 | `failOnSynthesisWarnings=true` |
| 仿真 | 6 个 enabled 用例，全部 ASCII `PASS/FAIL` |
| 数据手册实际位置 | `doc/ads1115.pdf`（TI ZHCS311E）、`doc/MCP4725.pdf`（Microchip DS22039C_CN）。任务书写“工程根目录”，仓库里已在 `doc/`；**以这两份为准，不另下网拷、不照抄网上示例。** |

RTL 目前全部在 `src/`，没有 I²C。任务书建议的 `rtl/` 目录与现有 ISE 工程不一致，本阶段沿用 `src/` + `sim/`。

## 后续架构迁移（本阶段不做，上板前必须另做）

当前仓库 RTL 是课设软件基线，**不得让后续实现误以为最终硬件也是 7 个传感器**。

| | 当前软件基线（本阶段必须保持） | 真实硬件（上板前迁移） |
|---|---|---|
| 传感器 | 文档/RTL 按 7 路独立数字键 | **3 个** LM393 比较器数字输出 |
| FPGA 输入 | `key_in[6:0]` | 3-bit 总线 |
| 音符映射 | 7 路优先级编码器，`key_in[0]` 最高优先 | `001b`~`111b` → 唱名 1~7（`000b` = 无键） |
| 模块 | `note_encoder.v` 保持不动 | 另做 **7-key priority encoder → 3-bit binary decoder** 迁移 |

本阶段：不改 `note_encoder.v`、不改 `key_in[6:0]` 端口、不改 UCF 七键 LOC。  
上板前：必须单独一次提交/验证，把输入译码换成 3-bit 二进制，并重跑 `verify` 与顶层 TB。该迁移 **不属于** ADC/DAC 驱动基础设施，也 **不能** 混进 commit A–E。

**IO 重分配（4 个 I²C LOC）**：迁移阶段两个 controller 需要 4 个真实 FPGA 引脚（`ADC_SCL` / `ADC_SDA`、`DAC_SCL` / `DAC_SDA`）。用户 2026-09-15 确认的 **38 脚可用引脚池**、池与现状的差集、候选分配与硬规则见 [`doc/README.md`](./README.md) 的「可用引脚池与 IO 重分配」。**逐脚确认前不得写 UCF LOC**，也不得拿 MAP 自动分配的结果当确认。

## 手册核验结果（实现必须用这些，不得照抄任务书十六进制）

### ADS1115（`doc/ads1115.pdf`）

- 开漏 I²C；SDA/SCL 必须外接上拉；器件不 clock-stretch。
- Fast-mode：`f_SCL ≤ 0.4 MHz`，`t_LOW ≥ 1300 ns`，`t_HIGH ≥ 600 ns`，`t_BUF/t_HD;STA/t_SU;STO ≥ 600 ns`。
- ADDR=GND → `1001000b = 7'h48`（VDD=`7'h49`，SDA=`7'h4A`，SCL=`7'h4B`）。地址必须参数化。
- Pointer：`00` Conversion，`01` Config。字节 MSB first。读转换：写 pointer `00` → Repeated START → 读 2 字节，最后一字节 Master NACK。
- Config（ADS1115 图 8-5）：`OS | MUX[2:0] | PGA[2:0] | MODE | DR[2:0] | COMP_MODE | COMP_POL | COMP_LAT | COMP_QUE[1:0]`。
- 本阶段默认：OS=1，PGA=`001`（±4.096 V），MODE=1（single-shot），DR=`111`（860 SPS），比较器关闭（`COMP_QUE=11`，其余 COMP=0）。
- 单端：AIN0/1/2→GND 的 MUX 为 `100/101/110`。
- **由位域自行拼出（与任务书一致，但是核验结论不是抄写）：**
  - CH0 = `16'hC3E3`
  - CH1 = `16'hD3E3`
  - CH2 = `16'hE3E3`
- 结果为 16-bit two's complement；driver **原样输出**，不把负数钳 0。
- 转换完成用 **读回 Config.OS**（0=进行中，1=就绪）+ timeout；860 SPS 标称约 1.2 ms，DR 容差 ±10%，timeout 必须大于该值，禁止只硬等固定周期。
- 模拟输入绝对值仍不得超过 VDD（3.3 V 供电时不能因为 FSR=±4.096 V 就输入 4.096 V）。

### MCP4725（`doc/MCP4725.pdf`）

- 开漏 I²C；Fast-mode `f_SCL ≤ 400 kHz`，`t_LOW ≥ 1300 ns`，`t_HIGH ≥ 600 ns`，**`t_BUF ≥ 1300 ns`（比 ADS 更严）**。
- 器件码 `1100`；A2/A1 出厂硬连线（未指定则为 00）；A0 由引脚决定。默认假设 A2A1=00、A0=0 → `7'h60`，**必须可配置，禁止写死不可改。**
- **只允许 Fast Write（表 6-2：C2=0, C1=0）**：只改 DAC Register，EEPROM 不变。
- 帧：`START | addr+W | ACK | {2'b00, PD1, PD0, D[11:8]} | ACK | D[7:0] | ACK | STOP`。正常模式 PD1=PD0=0。
- `dac_code=12'hABC` → byte1=`8'h0A`（`00_00_1010`），byte2=`8'hBC`（`1011_1100`）。
- VOUT 在**第三个字节 ACK 下降沿**更新（图 6-1 注 2）。
- `VOUT = VDD * D / 4096`。禁止写 EEPROM（典型 25 ms / 最大 50 ms，且有擦写寿命）。
- Fast Write 每次 = 地址字节 + 两个数据字节。在 400 kHz 或约 333 kHz 下都足以支撑 8 kS/s。
- 本阶段不做 Hs-mode、不做读命令、不做广播。

### I²C 拍数算法（写死，禁止只写“向上取整并钳制”）

任务书 2 MHz 的 LOW=3 / HIGH=2 **不适用**。`T_clk = 83.33 ns`。

若分别对 `t_LOW`、`t_HIGH` 向上取整再相加，12 MHz 会得到 16+8=24 拍 = **500 kHz**，超过 Fast-mode `f_SCL ≤ 400 kHz`。因此必须按下面三步，不得简化。

**强制公式**（`tLOW_MIN` / `tHIGH_MIN` 为秒，`SYS_CLK` / `I2C_HZ` 为 Hz）：

```
LOW    = ceil(tLOW_MIN  * SYS_CLK)
PERIOD = ceil(SYS_CLK   / I2C_HZ)
HIGH   = max( ceil(tHIGH_MIN * SYS_CLK), PERIOD - LOW )
```

ADS Fast-mode：`tLOW_MIN=1300 ns`，`tHIGH_MIN=600 ns`。MCP Fast-mode 相同的 LOW/HIGH 下限，但 `t_BUF ≥ 1300 ns`（比 ADS 的 600 ns 更严），START/STOP/BUF 等待按实例独立参数计算。

**Verilog-2001 32 位 integer 溢出（硬约束）**：

禁止 `SYS_CLK_HZ * 1_300_000_000`，也禁止 `SYS_CLK_HZ * 1300`（`12_000_000 * 1300 = 15.6e9`，已超出 32 位有符号上限 2_147_483_647）。必须先除后取整：

```
// ceil(SYS_CLK_HZ * T_NS / 1_000_000_000) 的安全写法：
//   Q = 1_000_000_000 / T_NS;              // T_NS 为 600 或 1300，Q 拟合
//   CYCLES = (SYS_CLK_HZ + Q - 1) / Q;     // ceil(SYS_CLK_HZ / Q)
localparam integer Q_LOW  = 1000000000 / 1300;   // 769230
localparam integer Q_HIGH = 1000000000 / 600;    // 1666666
localparam integer LOW    = (SYS_CLK_HZ + Q_LOW  - 1) / Q_LOW;
localparam integer PERIOD = (SYS_CLK_HZ + I2C_HZ - 1) / I2C_HZ;
localparam integer HIGH_MIN = (SYS_CLK_HZ + Q_HIGH - 1) / Q_HIGH;
localparam integer HIGH   = (HIGH_MIN > (PERIOD - LOW)) ? HIGH_MIN : (PERIOD - LOW);
```

`ceil(SYS_CLK_HZ / floor(1e9/T_NS))` 相对真实 `ceil(SYS_CLK_HZ*T_NS/1e9)` 略保守，对最短脉宽是安全方向。

强制公式在 12 MHz 下的数字结果（套 `PERIOD = ceil(SYS_CLK_HZ / I2C_HZ)`）：

| `I2C_HZ` | LOW | PERIOD | HIGH | actual `f_SCL` |
|---|---|---|---|---|
| 400000 | 16（1333 ns） | 30 | 14（1167 ns） | 400.000 kHz |
| 333333 | 16 | **37** | 21 | 324.324 kHz |

注意：`12_000_000 / 333333 = 36.000036...`，因此公式给出的是 **PERIOD=37**，不是 36。旧表写成 36 是算术错误，已作废。

### 板上默认：名义 333333 Hz，设计目标 36 拍（方案 A）

16+14 在数字上满足手册 Fast-mode 下限，但 **没有** 给模块上拉、总线电容和 SCL/SDA 上升沿留裕量。ISim 的 `pullup` 只模拟逻辑上拉，**不能** 模拟真实 4.7 kΩ + 电容的上升时间。

`CFG_ADC_I2C_SPEED` / `CFG_DAC_I2C_SPEED` 默认 **333333**，这是 **nominal target**（大约三分之一 MHz），**不是** `actual_f_SCL ≤ I2C_HZ` 的硬上限。

**板上默认以周期拍数 36 为设计目标。** 12 MHz 下 margin policy 的最终结果是 **18+18**：

```
18 + 18 = 36 拍
12_000_000 / 36 = 333333.333 Hz
```

比名义宏 333333 高约 0.333 Hz，仍远低于器件 400 kHz 上限，硬件无危险。

**禁止** 对默认宏套强制公式再拿去当默认拍数：那样会得到 16+21=37，TB 若同时要求 18+18 会失败。

分层规则（写死）：

1. **默认路径**（`SYS_CLK_HZ == 12_000_000` 且 `I2C_HZ == 333333`，即两个 `CFG_*_I2C_SPEED` 默认值）：固定 `PERIOD=36`、`LOW=18`、`HIGH=18`。**不要求** actual ≤ CFG 宏。TB 检查的就是 18+18。
2. **任何其它 `I2C_HZ`**（含可配置的 400000，以及协议 TB 降频覆盖）：套上面的强制公式。此时 `PERIOD = ceil(SYS/I2C)`，故 actual ≤ 所请求的 `I2C_HZ`。
3. **400 kHz（公式 16+14）保留为可配置项**，不是实物默认。

对未来 8 kS/s DAC：Fast Write 约 3 字节。36 拍 / 12 MHz（333.333 kHz）下一次事务约 90 µs 量级，样点周期 125 µs，裕量足够。

## 架构

```
                    ┌─ i2c_master (ADC 实例) ─ adc_i2c_scl/sda ─ ADS1115
ads1115_ctrl ───────┘     独立 FSM / busy / error / timeout / 时序参数

                    ┌─ i2c_master (DAC 实例) ─ dac_i2c_scl/sda ─ MCP4725
mcp4725_ctrl ───────┘     独立 FSM / busy / error / timeout / 时序参数
```

- 同一份 `i2c_master.v`，**两个完全独立实例**。禁止总线仲裁器、禁止共享 transaction scheduler。
- 开漏：`assign sda = sda_drive_low ? 1'b0 : 1'bz;`（SCL 同理）。**不得输出逻辑 1。**
- 全工程仍只有时钟域 `clk`；SCL 是开漏 IO，不是第二时钟。

### ENABLE 宏语义（driver default enable / integration-ready）

**本阶段不改 `finger_piano_top` 端口，不改 UCF，不在顶层实例化外设。** 这是安全策略：四个 I²C GPIO 尚未确认，不能让 ISE 自动分配管脚。

因此 `CFG_ENABLE_ADS1115` / `CFG_ENABLE_MCP4725` 只是 **driver 默认使能 / integration-ready 配置**，供 controller 模块自身的 `ENABLE` 参数和独立 TB 使用。

**把其中任一宏改为 1，并不能真正启用硬件。** 禁止写成“只改这一处宏即可启用系统”。真正启用必须 **同时** 完成下面三项（本阶段全部不做）：

1. `finger_piano_top` 增加 `adc_i2c_scl/sda`、`dac_i2c_scl/sda` 四个 `inout` 端口  
2. 顶层实例化 `ads1115_ctrl` 与 `mcp4725_ctrl`（两个独立 `i2c_master`）  
3. 用户确认后的 **4 个真实 UCF LOC**（禁止猜测、禁止 MAP 自动分配）

本阶段：

- `src/finger_piano_cfg.vh` 增加开关与参数，**默认全 0**。
- driver / master 作为可综合 RTL 列入 `project.json` 的 `sources`（让 XST 编译、尽早暴露 Verilog-2001 问题），但顶层 **不实例化** → 默认网表 I/O 仍为 20，方波路径二进制等价。
- 功能与“feature off 无总线活动”由 **独立 testbench** 证明。

## 文件布局

```
projects/finger_piano/
  src/
    finger_piano_cfg.vh          # 扩展：外设宏，默认全关（integration-ready，不能单独启用硬件）
    finger_piano_top.v           # 本阶段不改端口、不实例化外设
    ...现有模块不变（含 7 键 legacy note_encoder）...
    periph/
      i2c_master.v
      ads1115_ctrl.v
      mcp4725_ctrl.v
  sim/
    tb_i2c_master.v
    tb_ads1115_ctrl.v
    tb_mcp4725_ctrl.v
    models/
      ads1115_model.v
      mcp4725_model.v
  constraints/finger_piano.ucf   # 不增 I²C LOC；可加 BOARD TODO 注释
  project.json                   # sources + 新仿真；旧 6 个不动

doc/ADC_DAC扩展设计.md           # 任务书 §31 的 14 项 + 本文修正点
doc/ads1115.pdf
doc/MCP4725.pdf
```

不用 `rtl/project_config.vh`：本工程已有唯一配置头 `finger_piano_cfg.vh`。再开第二份会破坏“只改一处”。该“一处”只覆盖 **driver 配置**，不覆盖顶层端口 / 实例化 / UCF。

## 配置宏（写入 `finger_piano_cfg.vh`，默认如下）

```verilog
`define CFG_ENABLE_ADS1115    0          // driver default enable；单独改它不能启用硬件
`define CFG_ENABLE_MCP4725    0          // 同上
`define CFG_ADS1115_ADDR      7'h48
`define CFG_MCP4725_ADDR      7'h60
`define CFG_ADC_I2C_SPEED     333333     // nominal target；12 MHz 默认走 18+18=36 拍
`define CFG_DAC_I2C_SPEED     333333     // 不是 actual_f_SCL 的硬上限；400000 为可配置项
`define CFG_DAC_SAMPLE_RATE   8000       // 仅预留，本阶段不实现 DDS
`define CFG_ADS1115_PGA       3'b001     // ±4.096 V
`define CFG_ADS1115_DR        3'b111     // 860 SPS
```

两个 controller 必须各有 `I2C_HZ` 参数（见下），默认分别取这两个宏。**禁止** controller 或 master 偷偷只读全局宏、让 TB 无法独立覆盖速率。

12 MHz + 默认 `I2C_HZ=333333`：拍数 **必须是 18+18**，不得写成公式结果 16+21。其它 `I2C_HZ` 才套强制公式。禁止在多个文件手写魔数而不写上述分层规则。

## 模块规格

### `i2c_master.v`（Verilog-2001）

- 参数：`SYS_CLK_HZ`，`SCL_LOW_CYCLES`，`SCL_HIGH_CYCLES`，以及 START/STOP/BUF 周期、timeout 周期。LOW/HIGH/BUF **由实例化它的 controller 算好再传入**，master 不再自己读 `CFG_*_I2C_SPEED`。
- 命令级接口（valid/ready）：`START / RESTART / WRITE_BYTE / READ_BYTE / STOP`。读字节带 `nack_after`（最后一字节 Master NACK）。
- **Master 不知道当前字节是地址还是数据**（接口只有 `WRITE_BYTE`）。因此底层 **只报告 NACK，不区分 ADDR_NACK / DATA_NACK**。禁止为了错误码把通用 I²C Master 做成协议相关。
- Master `error_code`：`0 none / 1 NACK / 2 timeout / 3 protocol/internal`。NACK 时 abort → STOP（或释放总线）→ `error_code=1`。
- timeout：位周期或 ACK 等待超时 → 释放 SDA/SCL → `error_code=2`。
- `busy`；复位后 `sda_drive_low=0`、`scl_drive_low=0`（总线释放）。
- 单时钟 `posedge clk`，异步复位只用传入的 `rst_n_sync`。
- 不用 `$clog2` / `logic` / `always_ff` / `automatic`；计数器位宽用常量 localparam。

### `ads1115_ctrl.v`

- 实例化 **一个** `i2c_master`。参数：

```verilog
parameter integer ENABLE     = `CFG_ENABLE_ADS1115,
parameter integer I2C_ADDR   = `CFG_ADS1115_ADDR,
parameter integer PGA        = `CFG_ADS1115_PGA,
parameter integer DR         = `CFG_ADS1115_DR,
parameter integer SYS_CLK_HZ = `SYS_CLK_HZ,
parameter integer I2C_HZ     = `CFG_ADC_I2C_SPEED
```

- 由本模块按「默认 18+18 / 其它值走强制公式」算出 LOW/HIGH/BUF，再传给自己的 `i2c_master`。协议 TB 用 `#(.I2C_HZ(...))` 降速；不得让模块内部直接绑死全局宏而盖不住参数。
- 配置字在模块内按手册位域拼接，TB 断言结果为 C3E3/D3E3/E3E3（默认 PGA/DR 时）。
- FSM：`IDLE → CONFIG_CHn → WAIT_OS_CHn → READ_CHn`（n=0,1,2）→ `SAMPLE_DONE` → 循环。
- WAIT：写 Config（pointer `01` + 16-bit）后反复读 Config，直到 OS=1 或 timeout。
- 输出：`adc_ch0/1/2_raw[15:0]`，`adc_sample_valid`（三路一轮完成脉冲），`adc_busy`，`adc_error`，`error_code[2:0]`。
- **Controller 根据自身 FSM 映射错误码**：地址字节 NACK → `1 ADDR_NACK`；数据/pointer 字节 NACK → `2 DATA_NACK`；master timeout → `3`；其它 → `4`。不要让 master 做这个映射。
- `ENABLE=0`：FSM 停在复位/IDLE，不发任何 I²C，`adc_sample_valid=0`，SDA/SCL 保持 Z。
- 不含按键/音符逻辑。不用 ALERT/RDY。

### `mcp4725_ctrl.v`

- 实例化 **另一个** `i2c_master`。参数：

```verilog
parameter integer ENABLE     = `CFG_ENABLE_MCP4725,
parameter integer I2C_ADDR   = `CFG_MCP4725_ADDR,
parameter integer SYS_CLK_HZ = `SYS_CLK_HZ,
parameter integer I2C_HZ     = `CFG_DAC_I2C_SPEED
```

- 同样在本模块内按分层规则计算 LOW/HIGH/BUF 后传入 `i2c_master`。吞吐 TB 必须 `#(.SYS_CLK_HZ(12000000), .I2C_HZ(333333))`，此时拍数应为 18+18，actual ≈ 333333.333 Hz。协议 TB 可覆盖 `I2C_HZ` 降速。
- 接口：`dac_code[11:0]`，`dac_code_valid`，`dac_code_ready`，`dac_busy`，`dac_error`，**`dac_overrun`**。
- 只发 Fast Write。硬约束：命令字节高 2 位恒 `2'b00`；TB 扫描总线禁止出现 EEPROM 命令（`C2C1C0=011` 或 3 字节数据载荷的写 EEPROM 帧）。
- **缓冲策略 = 一项 pending buffer + overrun flag，禁止 latest-value-wins。**  
  latest-value-wins 适合设定电压；DDS 每个 8 kS/s 样点都有意义，静默丢点会造成波形失真。  
  - `dac_code_ready` 在 pending 空闲时为 1。  
  - 接受的样点进入唯一 pending 槽，发完才清。  
  - `valid && !ready` → 置 `dac_overrun`，**不覆盖**已挂起的样点（新样点被拒绝）。  
  - 正常 8 kS/s 必须 **零丢样 / 零 overrun**；只有生产者超过总线吞吐时才报 overrun。
- Controller 同样根据 FSM 把 master 的 NACK 映射为 ADDR_NACK 或 DATA_NACK。
- `ENABLE=0`：不传输、不影响 `audio_out`（本阶段本就不接音频）。

Controller 对外错误码：`0 none / 1 ADDR_NACK / 2 DATA_NACK / 3 timeout / 4 protocol`。外设未接时必须退出，禁止卡死。

## 仿真

新用例加入 `project.json` 的 `simulations`（testbench **不进** 综合 `sources`）。判据为日志子串，退出码 0 不算 PASS。诊断文本全 ASCII。

| name | top | 主要 sources | passPattern |
|---|---|---|---|
| `i2c_master` | `tb_i2c_master` | `sim/tb_i2c_master.v` | `TB_I2C_MASTER: PASS` |
| `ads1115_ctrl` | `tb_ads1115_ctrl` | TB + `sim/models/ads1115_model.v` | `TB_ADS1115_CTRL: PASS` |
| `mcp4725_ctrl` | `tb_mcp4725_ctrl` | TB + `sim/models/mcp4725_model.v` | `TB_MCP4725_CTRL: PASS` |

sim 的 `sources` 只列 TB/模型；RTL 仍由工具从工程 `sources` 拉取（与现有 `tb_finger_piano_top` 相同）。`includeDirs` 保持 `["src"]`。

协议类用例可用 TB 参数降频（如 1 MHz）并按比例改 SCL 周期。**吞吐用例必须按 12 MHz + 目标 I²C 速率跑**，不能降频后宣称 8 kS/s 裕量。ISim 里用 `pullup` 模拟逻辑上拉，并在文档写明它 **不是** 4.7 kΩ 上升沿模型。

### `tb_i2c_master`

START/STOP/Repeated START、写/读字节、ACK/NACK（底层只报 NACK，不报 ADDR/DATA 细分）、开漏（驱动侧只出现 0/Z）、timeout 退出、复位后总线释放。

### `tb_ads1115_ctrl`（任务书 §28）

协议模型返回 AIN0=`16'h1234`、AIN1=`16'h3456`、AIN2=`16'h5678`。自动检查：地址 `7'h48`、三路配置字、pointer `01`/`00`、Repeated START、MSB/LSB、三路寄存器、地址 NACK 与数据 NACK 分别映射、timeout 退出、`ENABLE=0` 时 SCL/SDA 无边沿。

### `tb_mcp4725_ctrl`（任务书 §29 + 吞吐）

1. 依次发送 `000/800/FFF/123/ABC`，检查 Fast Write 拆分、地址、ACK、STOP、busy/ready、NACK 恢复（ADDR vs DATA 由 controller 映射）、**无 EEPROM 命令**、`ENABLE=0` 无总线活动。  
2. **吞吐**：`#(.SYS_CLK_HZ(12000000), .I2C_HZ(333333))`，断言 SCL 为 **18+18（36 拍）**，不要用公式的 37 拍。以 8 kHz 连续送入 **至少 100 个** 样点。必须 `overrun==0`、发出帧数 == 输入样点数（0 drop）。可另做一拍过载刺激，确认 `dac_overrun` 置位且 pending **不被覆盖**。

模型只需协议，不需要模拟电路。

现有 6 个仿真 **零改动**（顶层端口不变，7 键 legacy 路径不变）。

## `project.json` 变更

`sources` 在顶层之前追加（顺序：被引用模块在前）：

1. `src/periph/i2c_master.v`
2. `src/periph/ads1115_ctrl.v`
3. `src/periph/mcp4725_ctrl.v`
4. 现有 6 个文件不变，`finger_piano_top.v` 仍最后

`includeFiles` 仍只同步 `src/finger_piano_cfg.vh`。`ucf` / `constraintsReviewed` / `verification` / `programming` **不改**。

## 提交顺序（不要一次塞进一个 commit）

按任务书 A–E，每步先本地写完再 `sim`/`verify`。**不要**把 3-bit 按键迁移塞进这些 commit。

**A — I²C Core**  
`i2c_master.v` + `tb_i2c_master.v` + project.json 该用例。验收：START/STOP/R/W/ACK/NACK/Restart/open-drain；错误码只有 NACK/timeout/protocol。Master 接收外部传入的 LOW/HIGH，自己不算 `I2C_HZ`。

**B — ADS1115**  
`ads1115_ctrl.v` + model + TB。三路采集 + 错误路径。配置字必须由位域生成并在注释中写明手册页/位。ADDR_NACK / DATA_NACK 在 controller 内映射。参数含 `I2C_HZ`，默认 `` `CFG_ADC_I2C_SPEED ``；LOW/HIGH/BUF 在本模块算出后传给 master。

**C — MCP4725**  
`mcp4725_ctrl.v` + model + TB。仅 Fast Write。pending + overrun，**禁止 latest-value-wins**。参数含 `I2C_HZ`，默认 `` `CFG_DAC_I2C_SPEED ``。吞吐用例：12 MHz + `I2C_HZ=333333` → **18+18**、8 kHz、≥100 样点、0 overrun / 0 drop。

**D — 配置接入（默认关闭 / integration-ready）**  
只扩展 `finger_piano_cfg.vh` + 把 3 个 RTL 列入综合 `sources`。**不改 top 端口、不改 UCF LOC、不实例化。** 跑完整 `verify`：旧 6 个 + 新仿真、综合 0 warning、implement 门禁仍 PASS。对比综合寄存器/I/O：默认应仍约 232 FF / 20 I/O（未实例化则不应膨胀）。文档必须写明 ENABLE=1 仍不能启用硬件。

**E — 文档**  
`doc/ADC_DAC扩展设计.md`（任务书 14 项 + 本文全部修正点）+ `projects/finger_piano/README.md` 增加“可选外设（默认关闭）”短节，指向该文档，并标明 7 键 RTL 为 legacy baseline。UCF 仅注释 BOARD TODO，不写假引脚。

## 文档必须写清的内容

1. 为何两条独立 I²C  
2. ADS1115 接线（AIN0/1/2、ADDR=GND、ALERT NC、4.7k 上拉到 **3.3 V**；模块自带上拉须检查不得接到 5 V）  
3. MCP4725 接线（A0、独立上拉到 3.3 V）  
4. 默认地址与如何改宏  
5. Config 位域与 C3E3/D3E3/E3E3 的推导  
6. ADC 采样 FSM + OS 轮询  
7. DAC Fast Write 帧与 VOUT 更新沿  
8. 为什么禁止 DDS 写 EEPROM（25/50 ms + 寿命）  
9. I²C 拍数强制公式、32 位溢出写法；333333 是 nominal target；12 MHz 默认设计目标 36 拍（18+18，actual 333333.333 Hz，允许略高于宏）；400 kHz 仅可配置。两个 controller 都有 `I2C_HZ` 参数，自己算 LOW/HIGH 再传给 master  
10. ENABLE 宏是 driver default enable / integration-ready；真正启用还要顶层端口 + 实例化 + 4 个真实 UCF LOC  
11. 仿真方法（`ise.ps1 sim/verify`），含 DAC 吞吐用例；`pullup` 不能代表真实上升沿  
12. 实物调试方法（逻辑分析仪分总线观察）  
13. **当前未启用**：ENABLE=0、无顶层端口、无 UCF、无实例化、无 DDS、无 ALERT、无 Hs-mode  
14. 协议依据是 `doc/ads1115.pdf` 与 `doc/MCP4725.pdf`  
15. **7 键 RTL = legacy baseline**；真实硬件是 3 个 LM393 → 3-bit；上板前必须另做 7-key priority encoder → 3-bit binary decoder 迁移  
16. Master 只报 NACK；ADDR/DATA 细分在 controller；DAC 用 pending+overrun 而不是 latest-value-wins

## 验收清单（交付时逐项勾）

- [ ] 默认仍可 `verify` PASS（综合 + 全部 enabled 仿真 + implement 门禁）
- [ ] `CFG_ENABLE_ADS1115=0` 且 `CFG_ENABLE_MCP4725=0`
- [ ] 文档称它们为 driver default enable / integration-ready，并写明真正启用还需顶层端口、实例化、4 个真实 UCF LOC
- [ ] 顶层端口/UCF LOC/`audio_out` 路径与现在一致（7 键 legacy 未改）
- [ ] 文档写明 3 传感器 / 3-bit 编码为后续迁移，本阶段未做
- [ ] 两套 I²C 独立实例，无仲裁器
- [ ] ADS：AIN0/1/2、地址/PGA/DR 可配、single-shot、原始 16-bit
- [ ] MCP：地址可配、12-bit、仅 Fast Write、不写 EEPROM
- [ ] Master 错误码不含 ADDR vs DATA 细分；controller 负责映射
- [ ] DAC pending + overrun；吞吐用例 ≥100 个 8 kHz 样点，0 overrun / 0 drop
- [ ] `CFG_*_I2C_SPEED=333333` 为 nominal target；12 MHz 默认 **18+18=36 拍**（actual 333333.333 Hz，允许略高于宏），TB 不得按公式 37 拍卡死
- [ ] 非默认 `I2C_HZ` 才套强制公式；无 32 位溢出乘法
- [ ] `ads1115_ctrl` / `mcp4725_ctrl` 均有 `I2C_HZ` 参数，算出 LOW/HIGH/BUF 再传给各自的 `i2c_master`；禁止只读全局宏
- [ ] NACK + timeout + 复位释放总线
- [ ] 新 TB 全部 PASS；feature off 无 I²C 边沿
- [ ] 文档完整；UCF 无猜测的 I²C 管脚

## 风险与对策

| 风险 | 对策 |
|---|---|
| 未实例化模块仍被 XST 编译出 warning，触发 `failOnSynthesisWarnings` | 写纯 Verilog-2001；D 阶段看 `synthesis.srp`，有 warning 立刻改 |
| ISim 对 `inout`/`pullup` 行为与 FPGA IOBUF 不完全相同 | TB 同时检查 drive-low 内部信号与总线线网；文档写明 pullup ≠ 4.7 kΩ 上升沿 |
| 分别 ceil(tLOW)+ceil(tHIGH) 得到 500 kHz | 非默认速率用强制 PERIOD 公式 |
| `ceil(12e6/333333)=37` 与默认 18+18 冲突 | 方案 A：333333 只是 nominal；默认锁 PERIOD=36 |
| `SYS_CLK_HZ * 1300` 溢出 32 位 | 先算 `Q = 1e9 / T_NS`，再 `(SYS_CLK_HZ + Q - 1) / Q` |
| latest-value-wins 让未来 DDS 丢样 | pending + overrun；12 MHz 吞吐 TB 卡零丢样 |
| 有人把 ENABLE=1 当成系统已启用 | 顶层本阶段无端口、无实例化；文档把三项硬条件写死 |
| 后续 Agent 把 7 键 RTL 当成最终硬件 | 本文与 ADC_DAC 文档把 legacy baseline / 3-bit 迁移写成独立后续项 |

## 实施时工作顺序

1. 再读一遍 Config / Fast Write 相关页，把位域写成 RTL localparam（不要粘贴任务书十六进制当唯一来源）。  
2. 按 commit A→E 实现；不要夹带 3-bit 按键迁移。  
3. 每完成一个新 TB：`.\ise.ps1 sim -Project finger_piano -Test <name>`。MCP4725 吞吐用例必须用 12 MHz。  
4. D 之后跑一次完整 `.\ise.ps1 verify -Project finger_piano`。  
5. 不跑 `program`，不改 `constraintsReviewed`。
