PanGucheng/ISE_prj/doc/ADS1115压力数据处理与标定基础设施开发计划.md

# finger_piano ADS1115压力数据处理与标定基础设施开发计划

> **Status**: IMPLEMENTED / SIMULATED / STANDALONE / NOT_CALIBRATED（已仿真通过，零点未实测，未接顶层，未上板）
> **Scope**: standalone 压力数据处理 RTL + ISim（无标定、无电压换算、无牛顿压力）
> **Depends on**: P1（ADS1115 driver 与 `adc_chN_raw` / `adc_sample_valid` 接口）
> **Top integration**: NO
> **UCF changes**: NO
> **Hardware programming**: FORBIDDEN
> **Acceptance**: full `verify`（`.\ise.ps1 verify -Project finger_piano`）

## 0. 最高优先级约束

本阶段只处理 ADS1115 已采集完成的三路数字数据，不修改 ADS1115 I²C driver，不参与音符选择，不改变 3-bit LM393 编码，不修改 DDS，不控制 MCP4725，不修改现有 audio_out。真实压力传感器的零点、满量程、轻压/重压阈值目前没有实测依据，因此禁止 Agent 猜测或从网络复制参数。所有校准常量保持默认无校正状态，实际参数必须等用户上板测量后另行填写。

本阶段目标是：

ADS1115 raw data
      ↓
coherent scan frame
      ↓
signed sanitization
      ↓
zero-offset correction
      ↓
three clean pressure channels

而不是：

压力
 ↓
直接改变音高/音量

后者属于后续计划。

## 1. 前置依赖

实施前必须已有：

i2c_master.v
ads1115_ctrl.v
ads1115_model.v
tb_ads1115_ctrl.v

并且 ADS1115 controller 对外接口至少具有：

adc_ch0_raw[15:0]
adc_ch1_raw[15:0]
adc_ch2_raw[15:0]
adc_sample_valid
adc_error

其中：

adc_sample_valid

定义为：

AIN0、AIN1、AIN2 一轮采集全部结束后产生的单周期有效脉冲。

如果当前第一份计划实现的接口名称略有不同，本计划应适配实际实现，但不能复制第二套 ADS1115 驱动。

## 2. 本阶段数据流

建立：

ADS1115
  │
  ├── ch0 raw signed 16 bit
  ├── ch1 raw signed 16 bit
  └── ch2 raw signed 16 bit
          ↓
   pressure_frame_capture
          ↓
   synchronized scan frame
          ↓
   pressure_conditioner
          ↓
┌─────────┼─────────┐
↓         ↓         ↓
P0        P1        P2
15 bit    15 bit    15 bit
corrected corrected corrected

最后输出：

pressure_ch0
pressure_ch1
pressure_ch2
pressure_valid

供以后模块使用。

## 3. 一个重要概念：frame不是“同时采样”

ADS1115只有一个ADC核心，通过内部MUX依次测：

AIN0
AIN1
AIN2

所以：

adc_ch0_raw
adc_ch1_raw
adc_ch2_raw

并不是同一个物理瞬间获得的。

本计划中的：

coherent pressure frame

定义为：

同一轮 CH0→CH1→CH2 扫描结束后形成的一组数据。

不能在文档中写成：

三路同步采样

或：

三个通道同时采样

正确措辞：

三通道轮询扫描帧

人的手指压力变化很慢，因此这种毫秒量级的通道时间差在本项目中可以接受。

## 4. 为什么需要独立数据处理层

不要让以后 DDS 或音量模块直接读取：

adc_ch0_raw

原因是 ADS1115 输出具有硬件层语义：

16-bit two's complement ADC code

而音乐控制层真正应该看到：

non-negative corrected pressure magnitude

中间建立明确边界：

ADC protocol/data format
        ↓
pressure processing
        ↓
musical control

以后即使：

ADC PGA改变；
零点有偏移；
某个传感器静态输出不为0；
ADS1115出现几个负码；

DDS/音量代码都不需要知道。

## 5. 新增文件建议
projects/finger_piano/
├── src/
│   └── pressure/
│       ├── pressure_frame_capture.v
│       ├── pressure_channel_corrector.v
│       └── pressure_processor.v
│
├── sim/
│   ├── tb_pressure_frame_capture.v
│   ├── tb_pressure_channel_corrector.v
│   └── tb_pressure_processor.v
│
├── pressure_calibration.md
└── project.json

本阶段不要修改：

finger_piano_top.v
tone_generator.v
dds_sine_generator.v
ads1115_ctrl.v
mcp4725_ctrl.v
sensor_code_frontend.v
UCF

除非发现第一计划 ADS1115 driver 有真实 bug。

## 6. pressure_frame_capture.v

推荐接口：

module pressure_frame_capture (
    input  wire        clk,
    input  wire        rst_n_sync,

    input  wire [15:0] adc_ch0_raw,
    input  wire [15:0] adc_ch1_raw,
    input  wire [15:0] adc_ch2_raw,
    input  wire        adc_sample_valid,

    output reg  [15:0] frame_ch0_raw,
    output reg  [15:0] frame_ch1_raw,
    output reg  [15:0] frame_ch2_raw,
    output reg         frame_valid
);

行为：

adc_sample_valid = 0
→ frame保持

adc_sample_valid = 1
→ 同一clk沿锁存三个raw
→ frame_valid拉高1个clk
## 7. Frame必须原子更新

禁止：

先更新CH0
下一拍更新CH1
再下一拍更新CH2

必须：

frame_ch0_raw <= adc_ch0_raw;
frame_ch1_raw <= adc_ch1_raw;
frame_ch2_raw <= adc_ch2_raw;

在同一个：

adc_sample_valid

事件中一起更新。

这样后续逻辑不会看到：

new CH0
old CH1
old CH2

这种半更新状态。

## 8. Reset行为

复位：

frame_ch0_raw = 0
frame_ch1_raw = 0
frame_ch2_raw = 0
frame_valid   = 0

释放复位后，在第一轮 ADS1115 frame 到来之前保持0。

不得生成假的：

frame_valid
## 9. ADS1115的负数如何处理

ADS1115转换寄存器是：

16-bit two's complement

当前应用测：

0V以上单端压力信号

因此正常情况下应主要为正值。

但零输入附近可能出现：

0
+1
-1
-2
...

这是ADC offset/noise可能产生的正常现象。

压力没有“负压力”意义。

因此数据处理层冻结：

$$ raw<0 \Rightarrow pressure=0 $$
## 10. pressure_channel_corrector.v

推荐：

module pressure_channel_corrector #(
    parameter [14:0] ZERO_OFFSET = 15'd0
) (
    input  wire [15:0] raw_code,
    output wire [14:0] corrected_code
);

处理顺序：

ADS1115 signed raw
       ↓
负数？
 ┌─────┴─────┐
 yes         no
 ↓           ↓
 0        raw[14:0]
             ↓
        subtract ZERO_OFFSET
             ↓
          saturate at 0

公式：

$$ P= \max(0,\ max(0,raw)-offset) $$
## 11. 为什么输出15 bit

ADS1115单端正输入正常有效正码范围主要是：

0x0000 ～ 0x7FFF

所以压力幅值只需要：

15 bit unsigned

即：

$$ 0\sim32767 $$

这样后续业务层不需要继续携带：

sign bit

含义。

## 12. Zero Offset

真实 FSR + TL084 + RC + ADS1115 系统即使完全释放，也可能不是严格：

0

例如未来实测可能看到：

CH0 idle = ...
CH1 idle = ...
CH2 idle = ...

但现在没有实测。

因此第一版默认：

ZERO_OFFSET = 15'd0

Agent禁止自己填：

50
100
200

之类猜测值。

## 13. 建议配置宏

在：

finger_piano_cfg.vh

未来可以加入：

`define CFG_PRESSURE_CH0_ZERO   15'd0
`define CFG_PRESSURE_CH1_ZERO   15'd0
`define CFG_PRESSURE_CH2_ZERO   15'd0

当前全部：

$$ \boxed{0} $$

并注明：

UNMEASURED DEFAULT

不是：

CALIBRATED
## 14. 不增加“满量程”参数

本阶段暂时不要添加：

CH0_FULL_SCALE
CH1_FULL_SCALE
CH2_FULL_SCALE

因为目前没有实际压力范围测量。

也不要为了“完整”默认写：

32767

然后声称已经归一化。

当前阶段只做：

zero correction

不做：

gain calibration。

## 15. 不做0～4095归一化

不要现在实现：

$$ P_{norm} = \frac{P-P_{min}}{P_{max}-P_{min}} 4095 $$

原因有两个。

第一：

Pmax尚未实测

第二，这会在 FPGA 里引入：

乘法
除法

资源和时序复杂度。

当前 XC3S50AN并不宽裕，没有必要为了尚未确定的需求增加运算。

保留：

15-bit corrected raw magnitude

反而最灵活。

## 16. pressure_processor.v

作为三路包装层：

module pressure_processor #(
    parameter [14:0] CH0_ZERO = 15'd0,
    parameter [14:0] CH1_ZERO = 15'd0,
    parameter [14:0] CH2_ZERO = 15'd0
) (
    input  wire        clk,
    input  wire        rst_n_sync,

    input  wire [15:0] adc_ch0_raw,
    input  wire [15:0] adc_ch1_raw,
    input  wire [15:0] adc_ch2_raw,
    input  wire        adc_sample_valid,

    output wire [14:0] pressure_ch0,
    output wire [14:0] pressure_ch1,
    output wire [14:0] pressure_ch2,
    output wire        pressure_valid
);

内部：

frame_capture
      ↓
3 × channel_corrector
      ↓
pressure outputs
## 17. pressure_valid

必须与：

pressure_ch0
pressure_ch1
pressure_ch2

新值一致。

即：

pressure_valid = 1

时，三个输出必须已经代表刚刚完成的这一轮扫描。

注意 nonblocking assignment 的时序。

Agent不能产生：

valid先高
下一拍数据才更新

这种接口。

TB必须验证。

## 18. 是否需要再注册 corrected data

有两种合法实现：

方案A

frame寄存器更新后，corrector是组合逻辑：

frame regs
   ↓
combinational correction

此时：

pressure_valid = frame_valid

即可。

推荐第一版采用这个。

简单，而且没有额外一拍延迟。

## 19. 不在Processor里读取 sensor_code

本阶段 pressure_processor 不应该有：

sensor_code
note_code

输入。

三路模拟压力和3-bit音符编码是两个独立的信息源：

LM393 path
→ note selection

ADS1115 path
→ pressure magnitude

先保持解耦。

## 20. 为什么暂时不决定“哪个ADC对应当前音符”

例如编码：

011

代表：

Sensor0 + Sensor1

共同组成一个音符码。

此时这个音符的“压力”究竟定义成：

max(P0,P1)

还是：

(P0+P1)/2

还是：

min(P0,P1)

属于音乐控制策略。

不是 ADC 数据层的职责。

本计划禁止提前决定。

## 21. 不做 pressure_level

暂时不要输出：

LIGHT
MEDIUM
HEAVY

或：

0/1/2/3

因为阈值尚未测量。

第一版只输出：

corrected raw magnitude

最合适。

## 22. tb_pressure_channel_corrector.v

必须覆盖：

raw	ZERO_OFFSET	expected
16'h0000	0	0
16'h0001	0	1
16'h7FFF	0	32767
16'hFFFF (-1)	0	0
16'hFF00 (负数)	0	0
100	100	0
99	100	0
101	100	1
1000	100	900

必须明确验证：

underflow saturates to zero

不能发生15位无符号减法绕回：

32767...
## 23. Sign处理不能写错

正确逻辑：

if (raw_code[15])
    positive = 15'd0;
else
    positive = raw_code[14:0];

不要：

取绝对值

例如：

-100

不能变成：

+100 pressure

负ADC码只代表：

零附近负偏移/噪声

所以必须钳0。

## 24. tb_pressure_frame_capture.v

至少验证：

A. reset
all outputs = 0
valid = 0
B. no valid

不断改变ADC输入：

adc_ch0_raw
adc_ch1_raw
adc_ch2_raw

但：

adc_sample_valid = 0

frame必须：

保持旧数据
C. valid pulse

例如输入：

1234
3456
5678

产生1拍valid。

必须一次性看到：

frame0=1234
frame1=3456
frame2=5678
D. 第二帧

全部替换为新值，确认无通道串位。

## 25. tb_pressure_processor.v

端到端输入例如：

第一帧：

CH0 = 16'hFFFF   // -1
CH1 = 16'd1000
CH2 = 16'd2000

参数：

CH0_ZERO = 10
CH1_ZERO = 100
CH2_ZERO = 200

期望：

P0 = 0
P1 = 900
P2 = 1800

并检查：

pressure_valid

只持续一个clk。

## 26. 再做一次channel independence测试

例如：

CH0变
CH1不变
CH2不变

新frame后：

只P0变化

避免 wiring 错误：

CH1 → pressure_ch2

这种问题。

## 27. ADS1115错误时怎么处理

pressure_processor 本身不需要输入：

adc_error

它只消费：

adc_sample_valid

如果 ADS1115 driver 出错：

不产生新的sample_valid

则：

pressure processor保持上一帧

这样职责最简单。

以后系统层可以单独监控：

adc_error
## 28. 是否需要timeout/stale判断

本阶段不需要。

不要加入：

pressure_stale_timeout

这种系统策略。

原因：

ADS1115 driver已经负责协议timeout

压力数据多久算“失效”属于更高层系统策略。

不要重复。

## 29. Calibration文档

新增：

projects/finger_piano/pressure_calibration.md

当前必须明确：

STATUS = NOT_CALIBRATED
## 30. Calibration文档预留表格

建议：

Channel	Released	Light	Normal	Strong	Selected ZERO
CH0	TODO	TODO	TODO	TODO	0 default
CH1	TODO	TODO	TODO	TODO	0 default
CH2	TODO	TODO	TODO	TODO	0 default

所有：

TODO

都是真实TODO。

禁止 Agent 填模拟数字冒充实测。

## 31. 明天的实物标定方法也提前写好

当用户硬件接好以后，每个传感器至少记录：

Released
Light press
Normal press
Strong press

建议每种状态不要只读一次。

记录：

minimum
maximum
average

例如：

Released × 20 frames

得到噪声范围。

## 32. ZERO_OFFSET未来如何选

不要简单取：

released average

更合理的工程方法可以是：

$$ ZERO = released_{max}+margin $$

但具体 margin：

必须根据实际噪声实测再确定。

因此当前文档只记录方法，不填数值。

## 33. 标定数据必须保留原始ADC code

不要明天只写：

轻压 = 20%

应优先保存：

ADS1115 raw code

例如：

CH0 released: ...
CH0 normal: ...

因为以后即使修改压力映射算法，也能重新计算，不必重新测硬件。

## 34. PGA与校准关系

当前 ADS1115 计划使用：

PGA = ±4.096V

如果以后 PGA 改变：

ADC raw code / Volt

比例也会改变。

所以：

校准参数只对对应 PGA 配置有效。

pressure_calibration.md 必须记录：

ADS1115 PGA setting
VDD
analog gain

避免以后改模拟前端后继续沿用旧校准值。

## 35. 当前模拟链也要记录

未来校准表头记录：

Sensor divider:
RSET = 实际值

TL084 gain:
实际电阻值 / gain

RC:
实际R/C

ADS1115 PGA:
001 / ±4.096V

因为任何一个改变：

raw code

都会改变。

## 36. 本阶段不做电压换算

不要在FPGA里实现：

$$ V=\frac{Code}{32768}\times4.096 $$

原因是：

后续控制逻辑根本不需要把ADC code先变成“伏特”。

FPGA完全可以直接使用：

ADC code

做比较/映射。

电压换算只适合：

报告
调试
标定文档
## 37. 本阶段也不做“牛顿压力”

FSR本身是非线性器件。

没有：

压力-电阻校准曲线
机械结构
接触面积

就不能把ADC数字量严谨换算成：

N

所以项目中应称：

pressure magnitude
pressure code
相对按压力度

不要声称：

实际压力 = X N
## 38. 是否添加 pressure_max

第一版建议：

$$ \boxed{\text{不添加}} $$

虽然：

max(P0,P1,P2)

实现很容易，但它已经开始表达：

三个传感器如何合成为一个压力量

属于后续控制策略。

保持数据层纯净更好。

## 39. 项目配置

建议加入：

`define CFG_PRESSURE_PROCESS_ENABLE  0
`define CFG_PRESSURE_CH0_ZERO       15'd0
`define CFG_PRESSURE_CH1_ZERO       15'd0
`define CFG_PRESSURE_CH2_ZERO       15'd0

其中：

ENABLE=0

仍表示：

future integration/default configuration

因为本阶段 processor 尚未实例化到系统顶层。

## 40. ENABLE=0怎么定义

如果给 pressure_processor 本身增加：

ENABLE

建议：

pressure_ch0 = 0
pressure_ch1 = 0
pressure_ch2 = 0
pressure_valid = 0

但其实本模块完全未进入顶层，所以也可以不设 ENABLE。

我更推荐：

不要给纯数据处理模块增加没有必要的 ENABLE。

由上层决定是否实例化。

配置宏可以暂时不增加：

CFG_PRESSURE_PROCESS_ENABLE

避免又产生一个“看起来能启用、实际没有接顶层”的宏。

## 41. 所以当前只需要三个零点宏

推荐最终只加入：

`define CFG_PRESSURE_CH0_ZERO   15'd0
`define CFG_PRESSURE_CH1_ZERO   15'd0
`define CFG_PRESSURE_CH2_ZERO   15'd0

简单明确。

## 42. project.json

把：

pressure_frame_capture.v
pressure_channel_corrector.v
pressure_processor.v

加入可综合 sources。

将三个 TB 加入 simulations：

pressure_frame_capture
pressure_channel_corrector
pressure_processor
## 43. Pass Pattern

统一：

TB_PRESSURE_FRAME_CAPTURE: PASS
TB_PRESSURE_CHANNEL_CORRECTOR: PASS
TB_PRESSURE_PROCESSOR: PASS

失败：

...: FAIL

不能只看 ISim exit code。

## 44. 原有测试全部不修改

必须继续保持所有：

legacy keyboard
3-bit input infrastructure
ADS1115
MCP4725
DDS
DDS→MCP4725 pipeline

已有用例。

不能为了新 pressure processor 修改旧TB。

## 45. 本阶段不接ADS1115 controller顶层

虽然：

pressure_processor

最终就是接：

ads1115_ctrl

本阶段仍不要修改：

finger_piano_top.v

如果需要端到端验证：

在 testbench 中实例化两者。

而不是先加未约束硬件端口。

## 46. 可以增加一个可选集成TB

如果 Agent 今晚进度足够，可以新增：

tb_ads1115_pressure_pipeline.v

连接：

ads1115_model
       ↓
ads1115_ctrl
       ↓
pressure_processor

完整验证：

I2C conversion data
→ raw frame
→ corrected pressure

这是纯仿真，非常有价值。

## 47. ADS→Pressure集成TB示例

ADC模型：

CH0 = 16'hFFFF  // negative
CH1 = 1000
CH2 = 2500

zero：

0
100
200

最终检查：

pressure0 = 0
pressure1 = 900
pressure2 = 2300

这样可以证明：

ADS字节顺序
+
signed code
+
frame capture
+
offset correction

全链路正确。

## 48. 不要在集成TB中模拟FSR电阻

这一层已经是：

数字RTL验证

不要把：

TL084
RC
FSR

模拟行为硬塞进 Verilog testbench。

模拟前端属于：

Multisim / 实物

ADS模型只需要提供预设ADC code。

## 49. 提交顺序

建议严格拆开。

Commit A — Frame Capture

新增：

pressure_frame_capture.v
tb_pressure_frame_capture.v

验证原子frame。

Commit B — Channel Corrector

新增：

pressure_channel_corrector.v
tb_pressure_channel_corrector.v

验证：

signed clamp
zero subtraction
underflow saturation
Commit C — Processor

新增：

pressure_processor.v
tb_pressure_processor.v

三路组合。

Commit D — Optional ADS Pipeline TB

如果前面全部通过：

tb_ads1115_pressure_pipeline.v

验证：

ADS1115 model
→ ADS driver
→ pressure processor
Commit E — Project Integration

修改：

project.json
finger_piano_cfg.vh

只加入：

CH0_ZERO=0
CH1_ZERO=0
CH2_ZERO=0

并加入新RTL/TB。

运行完整：

pwsh -File .\ise.ps1 verify -Project finger_piano
Commit F — Calibration Documentation

新增：

pressure_calibration.md

状态必须：

NOT_CALIBRATED

README更新：

Pressure data processing:
IMPLEMENTED
SIMULATED
ZERO CALIBRATION NOT MEASURED
NOT TOP INTEGRATED
## 50. 最终验收清单

Agent结束时必须满足：

[ ] ADS1115 driver未被重复实现
[ ] ADS1115协议层未与压力逻辑耦合

[ ] pressure frame三个通道原子更新
[ ] frame_valid严格1 clk
[ ] 无valid时frame保持

[ ] ADS负码钳为0
[ ] 不对负码取绝对值
[ ] zero offset减法正确
[ ] raw <= zero时饱和为0
[ ] 无unsigned underflow wrap

[ ] pressure_ch0/1/2均为15-bit unsigned
[ ] 三通道不会串位
[ ] pressure_valid与新数据对齐

[ ] CH0_ZERO默认0
[ ] CH1_ZERO默认0
[ ] CH2_ZERO默认0
[ ] 默认值明确标记UNMEASURED

[ ] 未实现假满量程
[ ] 未实现假压力阈值
[ ] 未实现0~4095归一化
[ ] 未实现牛顿换算
[ ] 未决定max/mean/min压力融合算法
[ ] 未把压力映射进音量/音高

[ ] finger_piano_top未修改
[ ] audio_out未修改
[ ] DDS未修改
[ ] 3-bit音符编码未修改
[ ] UCF未修改
[ ] 未执行program

[ ] 新RTL全部Verilog-2001
[ ] XST 0 errors
[ ] XST 0 warnings

[ ] pressure standalone TB全部PASS
[ ] ADS→pressure pipeline TB如实现则PASS
[ ] 所有旧simulation继续PASS
[ ] 完整verify PASS

[ ] pressure_calibration.md存在
[ ] calibration状态=NOT_CALIBRATED
[ ] 没有伪造实测数据
