PanGucheng/ISE_prj/projects/finger_piano_oled_integration/docs/resource_recovery_after_adc_fix.md

# ADC 修复后的资源回收与后续测试任务

日期：2026-09-22。执行工程：`finger_piano_oled_integration`，器件 `xc3s50an-4-tqg144`。

状态：本轮局部优化已完成定向验证；面积预算仍未达成。未执行全量 verify，未执行硬件写入。原计划的 500 Slice 是历史功能配置，不能作为当前三通道串口版本的资源结论。

## 1. 为什么资源重新紧张

本轮起点为提交 `5447e81`。构建 `20260922-202944-3b5f28a9` 的全部输入文件 SHA-256 与分析开始时源码一致。MAP 为 702/704 Slice、1175 logic LUT、121 route-through LUT、592 Slice FF、2/3 BRAM。

历史构建的变化如下，均取实际 MAP，不能把跨版本差值当成单模块面积：

| 构建编号 | Slice | logic LUT | Slice FF | 说明 |
|---|---:|---:|---:|---|
| `20260922-105740-6421d710` | 500 | 806 | 384 | 早期优化版本，没有当前实时三通道串口输出 |
| `20260922-140658-227522d2` | 607 | 955 | 471 | 约束、配置、顶层、系统连接和 UART 均有变动 |
| `20260922-160404-d57f6287` | 662 | 1042 | 502 | 相对上一行，输入源文件仅 OLED 顶层变化 |
| `20260922-164936-38e35b54` | 662 | 1042 | 502 | ADC 错误码细分与速率配置变动 |
| `20260922-202944-3b5f28a9` | 702 | 1175 | 592 | ADC 修复和实时三通道上报版本 |

500 Slice 版本的 XST 日志明确显示 `GEN_ADC.ch0_q/ch1_q/ch2_q` 等未消费输出被裁剪。现在 UART 真正读取这些数据，因此一部分增量是恢复真实数据通路的成本。当前 ADC 等待计数器仍为 16 位（12 MHz 下阈值 24000），不能把全部增长解释为计数器重新扩大到了 32 位。

另一个因素是 MAP 打包：原命令未指定 `-c`，工具默认值为 100。逻辑减少时 occupied Slices 不一定同步下降。必须分别比较 logic LUT、route-through LUT、FF、Slice 与 BRAM。

## 2. 已实施的改动

### 2.1 DDS 同步 ROM 与预取

- 新增 `src/audio/sine_rom_12bit_sync.v`：256×12 全周期同步 ROM，由 XST 推断为一块 BRAM。
- `tools/gen-dds-sine-rom.py` 直接展开原 `sine_lut_12bit.v` 的整数表和象限运算，绝不重新用浮点正弦生成近似值。`--check` 可检查生成物是否过期。
- 原组合 LUT 保留，供独立测试和冻结参考实现使用；参考实现只加入仿真 sources。
- `SAMPLE_DIV >= 2` 保证正常采样之间至少有一个时钟供 ROM 预取推进后的相位。切音当拍向 ROM 提交地址零，下一拍采样也能拿到中点。
- 外部 `dac_code`、`dac_code_valid` 的节奏、复位和切音语义保持不变。

| 边界 | 预取与外部结果 |
|---|---|
| 复位释放后首次采样 | 采样计数器尚未到期时已读取相位零；复位输出仍为 2048 |
| 正常采样 | 输出已预取的当前相位值，然后推进相位 |
| 切音与采样同拍 | 原切音分支强制中点，valid 节拍不移位 |
| 切音在采样前一拍 | 切音边沿读取零；下一拍输出零相位中点 |
| 切音在采样后一拍 | 当拍输出中点并重启相位，不重启分频器 |
| 静音、下游 busy | 保留固定采样时间轴，静音中点不变 |

同步 ROM 推断依据为 XST 对同步输出 ROM 的支持，参见 [Xilinx UG627](https://docs.amd.com/api/khub/documents/TRSkTbERlQzP8~B_44CW7A/content)。是否实际进入 BRAM 仍以本轮 XST `INFO:Xst:3044/3225` 和 MAP 的 3/3 BRAM 为准。

### 2.2 UART 结构精简

- 普通消息字符位置与 ADC 分段字符位置共用一个 4 位计数器；消息长度也明确为 4 位。
- 每个通道仍在原来的时刻锁存 16 位快照，改为四选一读取半字节，避免每个字符都移位整个 16 位寄存器。
- 保留 READY、OLED OK/NACK、ADC ERR、NOTE、三通道 ADC OK 的文本、优先级、发送握手和现有上报频率。
- 未改 ADC 控制器、I²C master、速率、管脚及约束。

### 2.3 可复现的 MAP 配置

工程配置采用 `optimization=Area`、`optimizationLevel=1`、`mapPackFactor=80`。

工具新增可选配置字段，映射为 `map -c 80`；正式命令集合和 programmer 完全不变。未配置的其他工程保持原命令。值必须是 JSON 整数 0～100，仅支持已核对的 Spartan-3 家族；拒绝字符串、越界值、其他器件家族和命令注入文本。工具隔离自测已 PASS。

这是打包目标，不是保证只占 80%，也不是逻辑资源变少的证据。配置越小不保证结果越好。

## 3. 资源实验与保留结论

| 构建 | 配置/变化 | Slice | logic LUT | total LUT | BRAM |
|---|---|---:|---:|---:|---:|
| `20260922-202944-3b5f28a9` | 本轮起点 | 702 | 1175 | 1296 | 2 |
| `20260922-230737-4f8d1e08` | DDS BRAM 初版，Area/1，默认 MAP | 702 | 1098 | 1219 | 3 |
| `20260922-230929-fd8209d6` | ROM 改同步 case，Area/2 | 702 | 1118 | 1241 | 3 |
| `20260922-231244-ef8c2281` | 同步 case + UART 精简，Area/1 | 702 | 1066 | 1186 | 3 |
| `20260922-231545-52f2a396` | 上一行 + MAP `-c 80`，保留 | **643** | **1066** | **1186** | **3** |
| `20260922-231652-1c7cd0ba` | MAP `-c 0`，不保留 | 704 | 1066 | 1186 | 3 |
| `20260922-232002-cdfcf42a` | 等价 ASCII 补零写法试验，不保留 | 653 | 1085 | 1204 | 3 |
| `20260922-232340-ea4c5012` | 恢复 643 Slice 的准确源码，最终 bitstream | **643** | **1066** | **1186** | **3** |

ROM 初版数组初始化写法虽然仿真通过且推断出 BRAM，却出现 `Xst:1781`，因此改为同步 case，未为该告警加豁免。Area/2 未改善面积。`-c 0` 除面积变差外还出现 `Pack:266` FXMUX 合并冲突，已恢复 `-c 80`。

保留版本：Slice 节省 59，空闲从 2 增至 61；logic LUT 节省 109，total LUT 节省 110；FF 从 592 降至 587。代价是 BRAM 从 2/3 增至 3/3。

已阅读保留实现的 `timing.twr`：`TS_clk=83.33ns`，0 failing endpoints，最差 setup slack **74.438ns**，minimum period 8.892ns。报告仍有未约束 OFFSET IN、OFFSET OUT 和其他路径，不代表完整板级时序通过。

**尚未达到原先音量接入前 ≤560 Slice 的预算。** 本轮结果可作为继续优化的起点，不能声称后续压力音量功能一定放得下。pressure capture 仍没有硬件消费者，完整压力处理成本尚未计入。

## 4. 定向验证和告警审阅

| 项目 | Run ID / 证据 | 结果 |
|---|---|---|
| ROM 全 256 相位 + DDS 每周期等价 | `sim-20260922-230951-0a05ecd2` | PASS；DIV=2/7/125/1500，各 143 个有效样点、24 次切音，含静音、复位和关闭态 |
| UART 每周期、每字节等价 | `sim-20260922-231300-bf1f3624` | PASS；601 字节、9 个完整 ADC 消息、6 类消息全部覆盖；发送中改变原始数据，含中途复位 |
| DDS → MCP4725 | `sim-20260922-230951-e576e01a` | PASS |
| DDS → gain → MCP4725 | `sim-20260922-231830-384f8d90` | PASS；3840 样点、3859 checks、0 errors |
| OLED 系统集成 | `sim-20260922-231830-10f0511d` | PASS；含 UART NOTE 与 ADC ERR 校验 |
| 工具隔离自测 | `tools/.work/resource-packing-tests.log` | PASS；不代表真实硬件测试 |
| 静态检查、ROM 生成一致性 | `Invoke-StaticChecks`、生成器 `--check` | PASS |

完整 verify：**NOT RUN（按用户要求）**。板测：**NOT TESTED**。冻结参考的测试证明本次变换的等价性，不替代对原设计正确性、所有错误恢复路径或模拟电路的验证。

当前 XST 共 90 条告警，逐项归入既有允许类别，Unexpected=0、CountMismatch=0。原配置仍允许 ADC 的 8+66 个 trim，是实时 ADC 接入前的历史数量；现收紧为 `u_i2c/error` 1 个和 `r_busy` 1 个，不再允许原始通道数据被裁剪。没有关闭 `failOnSynthesisWarnings`。压力 capture 49 条、DAC 诊断 18 条及常量位等其余类别保持逐项计数。

保留 MAP 有 28 条 `PhysDesignRules:812`，对应只读 ROM 未使用的数据输入：两块 OLED 各 8 个、新 DDS 12 个。它们不属于 XST allowlist，单独记录；不是零告警实现。

## 5. 交给后续调测 Agent 的任务

1. 阅读本文、当前 project.json 和仓库 AGENTS；先检查本地是否仍与本轮源码一致。不要拿旧 bit 当成新实现。
2. 按下方最终交付记录确认 bit 路径和 SHA-256。需要自行重建时先 `check -Stage bitstream`，再 `build -Stage bitstream`；重新阅读该次 MAP/PAR/TWR，不能拿本文的时序结论套到另一构建。
3. 硬件写入授权单独取得。本轮没有烧录授权，不沿用历史一次性 JTAG 许可。获得授权后只用正式 `program -Mode Jtag -ConfirmHardwareWrite`；不写 ISF。
4. 使用 `tools/capture-adc-uart.ps1 -ListPorts` 确认实际串口，随后用 `-Port <实际端口> -BitFile <本次bit> -Seconds 60 -BaudRate 115200 -Label resource_o3` 保存原始数据和摘要。依次按压三只传感器，确认三个通道分别响应且没有 ADC ERR。UART 提供的 bit 身份仍是操作员声明。
5. 确认 OLED 显示、音符切换和静音；实际测量 DAC 输出的七音频率及幅值。仿真 PASS 不替代这些板级结论。
6. 根据需要安排完整 verify；本轮有意没有执行，不能写成“全量验收通过”。任何失败保留日志并区分原有缺口与本次回归。

## 6. 下一轮优化优先级

1. **UART 固定文本存储与共享发送控制。** 现在仍有多组组合字符 case。先量化，将固定文本放进现有 ROM 的空闲地址/可用读端口是候选；须核实器件原语与端口布局，新增端口模型与并发访问测试。当前已经 3/3 BRAM，不能再单独占第四块。保留当前文本协议，不默认删诊断。
2. **OLED 局部状态机和位发送选择。** 逐项比较二进制/原状态编码和数据路径，不能只按 FF 数量估算收益。每次记录同口径 MAP，并回归 ACK/NACK、启动延迟和显示更新。
3. **接入真实压力音量前重新预算。** 保持源数据有实际消费者；将完整压力链与增益功能一起实现，量化新增资源。不得通过断开 ADC 数据、减少通道或裁剪错误恢复得到虚假的空闲面积。

继续使用 ≤560 Slice（音量前）和争取 ≤600 Slice（真实压力音量后）作为预算目标，当前均不作已达成声明。停止盲目收窄 ADC 超时或以更改 ADC 时序来换资源。

## 7. 最终交付记录

最终构建：**`20260922-232340-ea4c5012`**，执行到 **bitstream**，工具流程 PASS。实际资源与保留的 implement 结果一致；已重新阅读最终 `timing.twr`，已约束路径 0 失败、slack +74.438ns，未约束路径限制不变。

- bit 文件：[design.bit](../artifacts/20260922-232340-ea4c5012/results/design.bit)。
- SHA-256：`18284A5C1090CD7FDA5B9F1EBB7067A7341559EE372BAFE09A95CBFCD2A3EE6A`。
- 最终 [MAP](../artifacts/20260922-232340-ea4c5012/results/mapped.mrp)、[时序](../artifacts/20260922-232340-ea4c5012/results/timing.twr)、[输入清单](../artifacts/20260922-232340-ea4c5012/run.json)。
- 最终准确源码的 UART 等价证据为 `sim-20260922-231300-bf1f3624`；曾对等价补零改写另跑 `sim-20260922-232012-3ec7de16`，也 PASS，但面积较差，因此交付恢复前一写法的版本。
- 构建输入 SHA-256 与交付源码一致；最终 XST 90 条全部审阅，Unexpected=0、CountMismatch=0。审阅记录保存在 `artifacts/resource-recovery-20260922/audit.json`。

## 8. 板级真机实测验证（2026-09-23 闭环）

1. **JTAG 烧录验证**：
   - 经用户授权执行 JTAG 易失烧录（Run ID: `program-20260923-092717-75a56cdc`）。
   - 烧录位流：`artifacts/20260922-232340-ea4c5012/results/design.bit` (SHA-256: `18284A5C...`)。
   - 事务内 preflight 一次自愈重试后成功连接，FPGA 配置完成，`DONEIN=1`，`CRC error=0`，`DCM Locked=1`。
2. **串口实测捕获**：
   - 串口端口：`COM19`（115200 8N1，由于 USB 插拔端口更新）。
   - 采集凭证：[`artifacts/uart-20260923-092737-live_643slice_test-84e2a7f5`](../artifacts/uart-20260923-092737-live_643slice_test-84e2a7f5)。
   - 采集时长：15.0 秒，完整接收 23 帧连续三通道采样数据（约每 600 ms 一帧）。
   - 错误码统计：`ADC ERR=4` 及所有其他错误出现次数为 **0**（错误率 0.0 错误/秒）。
3. **物理采样电压换算**：
   - CH0: `0x568B` ~ `0x5695`（22155 ~ 22165 LSB）→ **2.769 V ~ 2.771 V**
   - CH1: `0x57D0` ~ `0x57DE`（22480 ~ 22494 LSB）→ **2.810 V ~ 2.812 V**
   - CH2: `0x67E7` ~ `0x67F2`（26600 ~ 26610 LSB）→ **3.325 V ~ 3.326 V**
   - 各通道数据微波动符合真实模拟信号特征，证明 643-Slice 优化版本（含 DDS BRAM 迁移与 UART 紧凑状态机）在真机上运行正常，ADC 功能完全闭环。
