PanGucheng/ISE_prj/reference/stm32_hal_ssd1306/stm32_hal_ssd1306.ioc

Mcu.UserName=STM32F103C8Tx
PA13.Signal=SYS_JTMS-SWDIO
PA14.Signal=SYS_JTCK-SWCLK
PB10.Signal=I2C2_SCL
PB11.Signal=I2C2_SDA
PD0-OSC_IN.Signal=RCC_OSC_IN
PD1-OSC_OUT.Signal=RCC_OSC_OUT
