PanGucheng/ISE_prj/reference/stm32_hal_ssd1306/Core/Src/main.c

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
/* Includes ------------------------------------------------------------------*/
#include "main.h"
#include "i2c.h"
#include "gpio.h"

/* USER CODE BEGIN Includes */
#include "oled.h"
/* USER CODE END Includes */


void SystemClock_Config(void);
/**
 * @brief  The application entry point.
 * @retval int
 */
int main(void)
{
  /* MCU Configuration--------------------------------------------------------*/

  /* Reset of all peripherals, Initializes the Flash interface and the Systick. */
  HAL_Init();

  /* Configure the system clock */
  SystemClock_Config();

  /* Initialize all configured peripherals */
  MX_GPIO_Init();
  MX_I2C2_Init();
  /* USER CODE BEGIN 2 */
  HAL_Delay(20); // 单片机启动比OLED上电快,需要延迟等待一下
  OLED_Init();
  /* USER CODE END 2 */

  /* Infinite loop */
  /* USER CODE BEGIN WHILE */
  while (1)
  {
    for (uint8_t i = 0; i < 256; i++)
    {
      OLED_NewFrame();
      OLED_DrawImage((128 - (bilibiliImg.w)) / 2, 0, &bilibiliImg, OLED_COLOR_NORMAL);
      OLED_PrintString(128 - i, 64 - 16, "波特律动hello", &font16x16, OLED_COLOR_NORMAL);
      OLED_ShowFrame();
      // HAL_Delay(100);
    }
    /* USER CODE END WHILE */

    /* USER CODE BEGIN 3 */
  }
  /* USER CODE END 3 */
}

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
