PanGucheng/ISE_prj/projects/xc3s50an_smoke/src/counter_top.v

// Toolchain smoke test only. No board-specific pin mapping.
module counter_top (
    input wire clk,
    output reg [7:0] count = 8'h00
);
    always @(posedge clk) begin
        count <= count + 8'd1;
    end
endmodule
