PanGucheng/ISE_prj/projects/finger_piano_oled_integration/src/oled_fixed_rom.v

//=============================================================================
// oled_fixed_rom.v
// SSD1306 静态配置与标题点阵 Block RAM 存储器 (2048 字节 x 8-bit = 1 x RAMB16_S9)
//
// 寻址划分：
//   0x000 .. 0x01A: 27 字节 STM32 参考初始化序列
//   0x020 .. 0x02E: 音符页寻址命令 (P0: 0x020, P1: 0x024, P2: 0x028, P3: 0x02C)
//   0x030 .. 0x036: 标题页寻址命令 (P0: 0x030, P1: 0x034)
//   0x038         : 开启显示命令 (0xAF)
//   0x100 .. 0x17F: 标题栏 Page 0 点阵 (128 字节)
//   0x180 .. 0x1FF: 标题栏 Page 1 点阵 (128 字节)
//
// 硬件映射：显式例化 Xilinx Spartan-3AN 内部第 2 个 RAMB16_S9 原语，
//           使用 INIT_00 .. INIT_3F 初始化，彻底消除所有命令与标题生成的分布式 LUT。
//=============================================================================

module oled_fixed_rom (
    input  wire        clk,
    input  wire [10:0] addr,
    output wire [7:0]  dout
);

    RAMB16_S9 #(
        .INIT_00(256'h0000000000148D40DB12DAF1D980D500D3A43FA8A6A1DF81401000C8B00220AE),
        .INIT_01(256'h00000000000000AF001000B1001000B0001200B5001200B4001200B3001200B2),
        .INIT_02(256'h001000B7001000B6001000B5001000B4001000B3001000B2001000B1001000B0),
        .INIT_03(256'h0000000000000000000000000000000000000000000000000000000000000000),
        .INIT_04(256'h0000000000000000000000000000000000000000000000000000000000000000),
        .INIT_05(256'h0000000000000000000000000000000000000000000000000000000000000000),
        .INIT_06(256'h0000000000000000000000000000000000000000000000000000000000000000),
        .INIT_07(256'h0000000000000000000000000000000000000000000000000000000000000000),
        .INIT_08(256'h00000808F8080800001008E88888F80800000000000000000000000000000000),
        .INIT_09(256'h007088888888F808001008E88888F80800003808080830C008F80800C030F808),
        .INIT_0A(256'h000000E038C0000000000808F808080000F008080808F8080000000000000000),
        .INIT_0B(256'h0000000000000000000000000000000000E01008080810E008F80800C030F808),
        .INIT_0C(256'h000020203F2020000000000300203F2000000000000000000000000000000000),
        .INIT_0D(256'h20300C0300203F200018202320203F2000021E2220201807003F180700203F20),
        .INIT_0E(256'h2038270202233C20000020203F2020000000010101213F200000000000000000),
        .INIT_0F(256'h00000000000000000000000000000000000F10202020100F003F180700203F20),
        .INIT_10(256'h0000000000000000000000000000000000000000000000000000000000000000),
        .INIT_11(256'h0000000000000000000000000000000000000000000000000000000000000000),
        .INIT_12(256'h0000000000000000000000000000000000000000000000000000000000000000),
        .INIT_13(256'h0000000000000000000000000000000000000000000000000000000000000000),
        .INIT_14(256'h0000000000000000000000000000000000000000000000000000000000000000),
        .INIT_15(256'h0000000000000000000000000000000000000000000000000000000000000000),
        .INIT_16(256'h0000000000000000000000000000000000000000000000000000000000000000),
        .INIT_17(256'h0000000000000000000000000000000000000000000000000000000000000000),
        .INIT_18(256'h0000000000000000000000000000000000000000000000000000000000000000),
        .INIT_19(256'h0000000000000000000000000000000000000000000000000000000000000000),
        .INIT_1A(256'h0000000000000000000000000000000000000000000000000000000000000000),
        .INIT_1B(256'h0000000000000000000000000000000000000000000000000000000000000000),
        .INIT_1C(256'h0000000000000000000000000000000000000000000000000000000000000000),
        .INIT_1D(256'h0000000000000000000000000000000000000000000000000000000000000000),
        .INIT_1E(256'h0000000000000000000000000000000000000000000000000000000000000000),
        .INIT_1F(256'h0000000000000000000000000000000000000000000000000000000000000000),
        .INIT_20(256'h0000000000000000000000000000000000000000000000000000000000000000),
        .INIT_21(256'h0000000000000000000000000000000000000000000000000000000000000000),
        .INIT_22(256'h0000000000000000000000000000000000000000000000000000000000000000),
        .INIT_23(256'h0000000000000000000000000000000000000000000000000000000000000000),
        .INIT_24(256'h0000000000000000000000000000000000000000000000000000000000000000),
        .INIT_25(256'h0000000000000000000000000000000000000000000000000000000000000000),
        .INIT_26(256'h0000000000000000000000000000000000000000000000000000000000000000),
        .INIT_27(256'h0000000000000000000000000000000000000000000000000000000000000000),
        .INIT_28(256'h0000000000000000000000000000000000000000000000000000000000000000),
        .INIT_29(256'h0000000000000000000000000000000000000000000000000000000000000000),
        .INIT_2A(256'h0000000000000000000000000000000000000000000000000000000000000000),
        .INIT_2B(256'h0000000000000000000000000000000000000000000000000000000000000000),
        .INIT_2C(256'h0000000000000000000000000000000000000000000000000000000000000000),
        .INIT_2D(256'h0000000000000000000000000000000000000000000000000000000000000000),
        .INIT_2E(256'h0000000000000000000000000000000000000000000000000000000000000000),
        .INIT_2F(256'h0000000000000000000000000000000000000000000000000000000000000000),
        .INIT_30(256'h0000000000000000000000000000000000000000000000000000000000000000),
        .INIT_31(256'h0000000000000000000000000000000000000000000000000000000000000000),
        .INIT_32(256'h0000000000000000000000000000000000000000000000000000000000000000),
        .INIT_33(256'h0000000000000000000000000000000000000000000000000000000000000000),
        .INIT_34(256'h0000000000000000000000000000000000000000000000000000000000000000),
        .INIT_35(256'h0000000000000000000000000000000000000000000000000000000000000000),
        .INIT_36(256'h0000000000000000000000000000000000000000000000000000000000000000),
        .INIT_37(256'h0000000000000000000000000000000000000000000000000000000000000000),
        .INIT_38(256'h0000000000000000000000000000000000000000000000000000000000000000),
        .INIT_39(256'h0000000000000000000000000000000000000000000000000000000000000000),
        .INIT_3A(256'h0000000000000000000000000000000000000000000000000000000000000000),
        .INIT_3B(256'h0000000000000000000000000000000000000000000000000000000000000000),
        .INIT_3C(256'h0000000000000000000000000000000000000000000000000000000000000000),
        .INIT_3D(256'h0000000000000000000000000000000000000000000000000000000000000000),
        .INIT_3E(256'h0000000000000000000000000000000000000000000000000000000000000000),
        .INIT_3F(256'h0000000000000000000000000000000000000000000000000000000000000000)
    ) u_ramb16_s9 (
        .DO   (dout),
        .DOP  (),
        .ADDR (addr),
        .CLK  (clk),
        .DI   (8'h00),
        .DIP  (1'b0),
        .EN   (1'b1),
        .SSR  (1'b0),
        .WE   (1'b0)
    );

endmodule
