PanGucheng/ISE_prj/projects/finger_piano_oled_integration/src/oled_bitmap_rom.v

//=============================================================================
// oled_bitmap_rom.v
// 8 音符预渲染点阵 Block RAM 存储器 (2048 字节 x 8-bit = 1 x RAMB16_S9)
//
// 寻址规则：
//   addr[10:0] = {note_code[2:0], page_idx[1:0], col_idx[5:0]}
//     - note_code[2:0]: 3 位，对应 8 种音符状态 (000=MUTE, 001=C4 ... 111=B4)
//     - page_idx[1:0]:  2 位，对应动态区 4 个 Page (Page 2, 3, 4, 5)
//     - col_idx[5:0]:   6 位，对应每页 64 列点阵数据
//
// 硬件映射：显式例化 Xilinx Spartan-3AN 内部 1 个 RAMB16_S9 原语，
//           使用 INIT_00 .. INIT_3F 初始化 2048 字节点阵数据，零 Slice 占用。
//=============================================================================

module oled_bitmap_rom (
    input  wire        clk,
    input  wire [10:0] addr,
    output wire [7:0]  dout
);

    RAMB16_S9 #(
        .INIT_00(256'h08F808000008F8080008F8F800F8F80800000000000000000000000000000000),
        .INIT_01(256'h00000000000000000000000000000000001008E88888F80800180808F8080818),
        .INIT_02(256'h001F202020201F0000203F003F003F2000000000000000000000000000000000),
        .INIT_03(256'h000000000000000000000000000000000018202320203F20000000203F200000),
        .INIT_04(256'h0000000000000000000000000000000000000000000000000000000000000000),
        .INIT_05(256'h008080808080800008F808000008F80800000000000000000000000000000000),
        .INIT_06(256'h0101010101010100000000000030300001010101010101000101010101010100),
        .INIT_07(256'h003021222C302100203F210101213F2000000000000000000101010101010100),
        .INIT_08(256'h000080808080000000E010080808F808000000000000000000000000F8101000),
        .INIT_09(256'h0000F81020C0000000380808080830C000000000000000000000000000000000),
        .INIT_0A(256'h001F202020201F00000F102020203F200000000000000000000020203F202000),
        .INIT_0B(256'h00243F2424040700000810202020180700000000000000000000000000000000),
        .INIT_0C(256'h000000000000000000000000F8101000000018888810E0000070880808087000),
        .INIT_0D(256'h008080808080800008F808000008F8080070880808087000000018888810E000),
        .INIT_0E(256'h0000000000303000000020203F202000000E112020110F000030212224283000),
        .INIT_0F(256'h003021222C302100203F210101213F200030212224283000000E112020110F00),
        .INIT_10(256'h0000808080800000007088888888F80800000000000000000070880808087000),
        .INIT_11(256'h0000F81020C0000000E010080808F80800000000000000000000000000000000),
        .INIT_12(256'h0013222222221F0020300C0300203F2000000000000000000030212224283000),
        .INIT_13(256'h00243F2424040700000F102020203F2000000000000000000000000000000000),
        .INIT_14(256'h0000000000000000003048888808300000E010080810E0000070880808087000),
        .INIT_15(256'h008080808080800008F808000008F808000838C808083800000018888810E000),
        .INIT_16(256'h0000000000303000000E112020201800000F1122223100000030212224283000),
        .INIT_17(256'h003021222C302100203F210101213F20000000003F000000000E112020110F00),
        .INIT_18(256'h00000000989880000008F8F800F8F80800000000000000000030488888083000),
        .INIT_19(256'h0000F81020C00000001008E88888F80800000000000000000000000000000000),
        .INIT_1A(256'h000020203F20200000203F003F003F200000000000000000000E112020201800),
        .INIT_1B(256'h00243F24240407000018202320203F2000000000000000000000000000000000),
        .INIT_1C(256'h000000000000000000E010080810E00000708808080870000030488888083000),
        .INIT_1D(256'h008080808080800008F808000008F8080030488888083000000018888810E000),
        .INIT_1E(256'h0000000000303000000F1122223100000030212224283000000E112020201800),
        .INIT_1F(256'h003021222C302100203F210101213F20000E112020201800000E112020110F00),
        .INIT_20(256'h0000808080800000001008E88888F80800000000000000000000F81020C00000),
        .INIT_21(256'h0000F81020C00000001008E88888F80800000000000000000000000000000000),
        .INIT_22(256'h203F2222222419000000000300203F20000000000000000000243F2424040700),
        .INIT_23(256'h00243F24240407000000000300203F2000000000000000000000000000000000),
        .INIT_24(256'h000000000000000000E010080810E0000000F81020C000000030488888083000),
        .INIT_25(256'h008080808080800008F808000008F80800304888880830000070880808087000),
        .INIT_26(256'h0000000000303000000F11222231000000243F2424040700000E112020201800),
        .INIT_27(256'h003021222C302100203F210101213F20000E1120202018000030212224283000),
        .INIT_28(256'h000080808080000000380808088870000000000000000000000808888808F800),
        .INIT_29(256'h0000F81020C0000000003808080830C0000000000000000000000000F8080800),
        .INIT_2A(256'h001F202020201F00001C2221212038000000000000000000000E112020211900),
        .INIT_2B(256'h00243F242404070000021E22202018070000000000000000000020203F202000),
        .INIT_2C(256'h000000000000000000000000F810100000E010080810E0000030488888083000),
        .INIT_2D(256'h008080808080800008F808000008F80800E010080810E00000E010080810E000),
        .INIT_2E(256'h0000000000303000000020203F202000000F112222310000000E112020201800),
        .INIT_2F(256'h003021222C302100203F210101213F20000F112222310000000F112222310000),
        .INIT_30(256'h0000808080800000000000000008F8080000000000000000000018888810E000),
        .INIT_31(256'h0000F81020C00000000000E038C0000000000000000000000000000000000000),
        .INIT_32(256'h203F2222222419000030202020203F200000000000000000000E112020110F00),
        .INIT_33(256'h00243F24240407002038270202233C2000000000000000000000000000000000),
        .INIT_34(256'h000000000000000000E010080810E0000000F81020C000000000F81020C00000),
        .INIT_35(256'h008080808080800008F808000008F80800E010080810E00000E010080810E000),
        .INIT_36(256'h0000000000303000000F102020100F0000243F242404070000243F2424040700),
        .INIT_37(256'h003021222C302100203F210101213F20000F102020100F00000F102020100F00),
        .INIT_38(256'h000000009898800000380808088870000000000000000000000838C808083800),
        .INIT_39(256'h0000F81020C00000000070888888F80800000000000000000000000000000000),
        .INIT_3A(256'h000020203F202000001C2221212038000000000000000000000000003F000000),
        .INIT_3B(256'h00243F2424040700000E112020203F2000000000000000000000000000000000),
        .INIT_3C(256'h0000000000000000003048888808300000E010080810E0000000F81020C00000),
        .INIT_3D(256'h008080808080800008F808000008F80800708808088870000070880808887000),
        .INIT_3E(256'h0000000000303000000E112020201800000F11222231000000243F2424040700),
        .INIT_3F(256'h003021222C302100203F210101213F20001C222121221C00001C222121221C00)
    ) u_ramb16_s9 (
        .DO   (dout),
        .DOP  (),
        .ADDR (addr),
        .CLK  (clk),
        .DI   (8'h00),
        .DIP  (1'b0),
        .EN   (1'b1),
        .SSR  (1'b0),
        .WE   (1'b0)
    );

endmodule
