PanGucheng/ISE_prj/projects/finger_piano_oled_integration/src/oled_title_rom.v

//=============================================================================
// oled_title_rom.v
// "FINGER PIANO" 标题栏静态点阵 ROM (Page 0 & Page 1, 128 列居中)
// 仅在上电初始化时读取一次，占用极小分布式 ROM
//=============================================================================

module oled_title_rom (
    input  wire [7:0] addr,  // addr[7] = page (0: Page 0, 1: Page 1), addr[6:0] = col (0..127)
    output reg  [7:0] dout
);

    always @(*) begin
        case (addr)
            8'h00: dout = 8'h00;
            8'h01: dout = 8'h00;
            8'h02: dout = 8'h00;
            8'h03: dout = 8'h00;
            8'h04: dout = 8'h00;
            8'h05: dout = 8'h00;
            8'h06: dout = 8'h00;
            8'h07: dout = 8'h00;
            8'h08: dout = 8'h00;
            8'h09: dout = 8'h00;
            8'h0A: dout = 8'h00;
            8'h0B: dout = 8'h00;
            8'h0C: dout = 8'h00;
            8'h0D: dout = 8'h00;
            8'h0E: dout = 8'h00;
            8'h0F: dout = 8'h00;
            8'h10: dout = 8'h08;
            8'h11: dout = 8'hF8;
            8'h12: dout = 8'h88;
            8'h13: dout = 8'h88;
            8'h14: dout = 8'hE8;
            8'h15: dout = 8'h08;
            8'h16: dout = 8'h10;
            8'h17: dout = 8'h00;
            8'h18: dout = 8'h00;
            8'h19: dout = 8'h08;
            8'h1A: dout = 8'h08;
            8'h1B: dout = 8'hF8;
            8'h1C: dout = 8'h08;
            8'h1D: dout = 8'h08;
            8'h1E: dout = 8'h00;
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
            8'h9E: dout = 8'h00;
            8'h9F: dout = 8'h00;
            8'hA0: dout = 8'h20;
            8'hA1: dout = 8'h3F;
            8'hA2: dout = 8'h20;
            8'hA3: dout = 8'h00;
            8'hA4: dout = 8'h07;
            8'hA5: dout = 8'h18;
            8'hA6: dout = 8'h3F;
            8'hA7: dout = 8'h00;
            8'hA8: dout = 8'h07;
            8'hA9: dout = 8'h18;
            8'hAA: dout = 8'h20;
            8'hAB: dout = 8'h20;
            8'hAC: dout = 8'h22;
            8'hAD: dout = 8'h1E;
            8'hAE: dout = 8'h02;
            8'hAF: dout = 8'h00;
            8'hB0: dout = 8'h20;
            8'hB1: dout = 8'h3F;
            8'hB2: dout = 8'h20;
            8'hB3: dout = 8'h20;
            8'hB4: dout = 8'h23;
            8'hB5: dout = 8'h20;
            8'hB6: dout = 8'h18;
            8'hB7: dout = 8'h00;
            8'hB8: dout = 8'h20;
            8'hB9: dout = 8'h3F;
            8'hBA: dout = 8'h20;
            8'hBB: dout = 8'h00;
            8'hBC: dout = 8'h03;
            8'hBD: dout = 8'h0C;
            8'hBE: dout = 8'h30;
            8'hBF: dout = 8'h20;
            8'hC0: dout = 8'h00;
            8'hC1: dout = 8'h00;
            8'hC2: dout = 8'h00;
            8'hC3: dout = 8'h00;
            8'hC4: dout = 8'h00;
            8'hC5: dout = 8'h00;
            8'hC6: dout = 8'h00;
            8'hC7: dout = 8'h00;
            8'hC8: dout = 8'h20;
            8'hC9: dout = 8'h3F;
            8'hCA: dout = 8'h21;
            8'hCB: dout = 8'h01;
            8'hCC: dout = 8'h01;
            8'hCD: dout = 8'h01;
            8'hCE: dout = 8'h00;
            8'hCF: dout = 8'h00;
            8'hD0: dout = 8'h00;
            8'hD1: dout = 8'h20;
            8'hD2: dout = 8'h20;
            8'hD3: dout = 8'h3F;
            8'hD4: dout = 8'h20;
            8'hD5: dout = 8'h20;
            8'hD6: dout = 8'h00;
            8'hD7: dout = 8'h00;
            8'hD8: dout = 8'h20;
            8'hD9: dout = 8'h3C;
            8'hDA: dout = 8'h23;
            8'hDB: dout = 8'h02;
            8'hDC: dout = 8'h02;
            8'hDD: dout = 8'h27;
            8'hDE: dout = 8'h38;
            8'hDF: dout = 8'h20;
            8'hE0: dout = 8'h20;
            8'hE1: dout = 8'h3F;
            8'hE2: dout = 8'h20;
            8'hE3: dout = 8'h00;
            8'hE4: dout = 8'h07;
            8'hE5: dout = 8'h18;
            8'hE6: dout = 8'h3F;
            8'hE7: dout = 8'h00;
            8'hE8: dout = 8'h0F;
            8'hE9: dout = 8'h10;
            8'hEA: dout = 8'h20;
            8'hEB: dout = 8'h20;
            8'hEC: dout = 8'h20;
            8'hED: dout = 8'h10;
            8'hEE: dout = 8'h0F;
            8'hEF: dout = 8'h00;
            8'hF0: dout = 8'h00;
            8'hF1: dout = 8'h00;
            8'hF2: dout = 8'h00;
            8'hF3: dout = 8'h00;
            8'hF4: dout = 8'h00;
            8'hF5: dout = 8'h00;
            8'hF6: dout = 8'h00;
            8'hF7: dout = 8'h00;
            8'hF8: dout = 8'h00;
            8'hF9: dout = 8'h00;
            8'hFA: dout = 8'h00;
            8'hFB: dout = 8'h00;
            8'hFC: dout = 8'h00;
            8'hFD: dout = 8'h00;
            8'hFE: dout = 8'h00;
            8'hFF: dout = 8'h00;
            default: dout = 8'h00;
        endcase
    end

endmodule
