PanGucheng/ISE_prj/(commit log)

2026-09-14 初始化：ISE 14.7 本机构建工具链、模板与 XC3S50AN smoke 工程
2026-09-14 新增手指钢琴课设工程：7 键单音电子琴 RTL、testbench、UCF 模板、文档与实施计划
2026-09-14 修正手指钢琴工程文档计算并补充滤波旁路验证
2026-09-14 新增 sim/verify/report 工具入口：固化 ISim fuse+tclbatch 流程、静态检查与报告解析
2026-09-14 收紧 report 缺文件判定并新增 failOnSynthesisWarnings 策略，补测试与文档措辞
2026-09-14 新增 JTAG probe/program 烧录工具（Jtag 临时配置 / Isf 内部 Flash），并把 finger_piano 时钟更新为已确认的 2 MHz
2026-09-14 probe 增加 readIdcode 读取并核对 JTAG IDCODE，补充真机识别记录（XC3S50AN 0x02610093）
2026-09-14 tools: parse real bitgen .bit headers in the program preflight
    ISE 14.7 bitgen writes a compact header (<letter><len_hi><len_lo><data..0x00>, a=design, b=part, c=date, d=time) rather than the 'Target Device :' text header the tool only knew about. A real finger_piano design.bit therefore reported NOT_PARSED, silently dropping the bitstream-vs-JTAG device cross-check.
    Get-BitFileFacts now parses both shapes; Test-BitPartMatchesDevice compares part+package and only tolerates a missing 'xc' prefix (no invented package-equivalence rule, and a speed grade absent from the header is reported as absent instead of guessed). The preview now prints the header format and the real match verdict.
    Self-t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
2026-09-14 finger_piano: 12 MHz on P57, user-confirmed pin constraints, implement and bitstream
    Board facts confirmed by the user: P57 carries a 12 MHz oscillator, P1-P40 are usable, I/O is 3.3 V. SYS_CLK_HZ goes 2 MHz -> 12 MHz; the frequency table, cfg comments and README numbers are recomputed (N = 22936/20429/18204/17182/15306/13636/12148, max error 0.0103%), and the sim case is renamed tone_generator_12m with TB_SYS_CLK_HZ=12000000.
    The UCF now contains real constraints (clk P57, rst_n P3, keys P4/P5/P6/P7/P8/P10/P11, audio_out P12, debug P13-P21 and P24/P25/P27, all LVCMOS33, TNM_NET clk_group + PERIOD 83.33 ns) and constraintsReviewed is true because the user confirmed clock, pins and voltage -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
2026-09-14 program: make the JTAG/ISF mode semantics match the device, and never report a false PASS
    Measured on the real board (ISE 14.7 + XC3S50AN): in the Boundary Scan flow,
    assignFile + program writes the device internal In-System Flash - the transcript
    downloads spartan3a/data/xc3s50an_spi.cor, prints "Programming Flash" and
    sector/page addresses, then "Programmed successfully" and a DONE-pin check. So
    -Mode Jtag was silently performing a NON-VOLATILE write while claiming
    "VOLATILE - a power cycle loses the configuration".
    Verified there is no batch path to a transient SRAM-only configuration on this
    device: "program -p 1 -v -sram" is rejected (Switch "-sram" is not allowed),
    "-onlyFpga" switche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
2026-09-14 program: -onlyFpga is the volatile FPGA path; drop the separate verify step
    Measured on the real board (ISE 14.7 + XC3S50AN, Digilent JTAG-HS2):
    assignFile + program -> writes the internal ISF (SPI access core,
    "Programming Flash", sector/page addresses)
    assignFile + program -onlyFpga -> configures the FPGA fabric only
    ("Programming device" -> "Completed
    downloading bit file to device"), with no
    SPI core and no flash lines at all
    program -onlyFpga -v -> ERROR:Bitstream:2 ... design.msk does not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
2026-09-14 probe-diag: layered cable diagnostics, and stop over-claiming a missing USB device
    Measured evidence that forced the wording change: the FTDI device
    (USB\VID_0403&PID_6014\210241672559) is present with Status=OK in the guest
    immediately before AND after an iMPACT run that reports "Digilent Plugin: no JTAG
    device was found". A present, healthy USB device and an unusable cable coexist, so
    "USB/JTAG cable is not visible inside fpga-vm" was an over-claim. Cable status is
    now layered (DIGILENT_ENUM_FAILED / DIGILENT_OPEN_FAILED / CABLE_UNAVAILABLE) and
    the summary states explicitly that the Windows PnP state is a separate diagnostic.
    New `probe-diag` command: read-only hardware-wise (setMode/set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
2026-09-14 program: pin Digilent cable and collapse preflight-to-program idle gap
    The formal probe/program path no longer auto-detects the cable. programming.json
    gains cableType/cableSerial/cableFrequencyHz/position, and every generated script
    now uses
    setCable -target "digilent_plugin DEVICE=SN:210241672559 FREQUENCY=10000000"
    The frequency comes from 52 real successful transcripts on this machine (all
    10000000 Hz) and is never defaulted: a missing value is an error for the formal
    path, and probe-diag prints NO_MEASURED_CABLE_FREQUENCY instead of guessing.
    -p auto survives only inside probe-diag, which is diagnostic.
    One hardware transaction replaces the old two-step flow. The local side now onl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
2026-09-15 program: add a diagnostic -CableMode Auto override for the ISF write investigation
    A/B experiment support only. `-CableMode Auto` forces `setCable -p auto` for one run
    while the project keeps its pinned serial; run.json records
    cableModeOverride = "auto (diagnostic override - NOT the enforced path)" and the
    summary prints "Cable override : AUTO - diagnostic A/B only" so such a run can never
    be mistaken for the formal path.
    Used to test whether the pinned Digilent target was responsible for the ISF verify
    failures. Result: with -p auto the write still reports "Programming completed
    successfully" and then "Verify failed on page 0" with the same 65 s elapsed time, so
    the cable-selection hypoth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
2026-09-15 tests: fix the mock state for the -CableMode Auto override assertions
    The previous commit was pushed while the suite was red: the new override test ran
    while $script:ProgProgram was still 'otherserial' from the cable-mismatch case, so
    the run failed with CABLE MISMATCH instead of exercising the override. The mock is
    now reset to a healthy transcript before that block. Full suite green again.
2026-09-15 program: make the ISF erase phase explicit and gate on it (program -p N -e -v)
    Measured failure mode that motivates this: `assignFile` + `program -p N -v` on the
    internal ISF prints "Programming Flash...done." and "Programming completed
    successfully" and then "Verifying device...Verify failed on page 0" with
    "Configuration data download to FPGA was not successful. DONE did not go high".
    The write self-reported success while the content was wrong (confirmed by an
    independent read-only `verify -p 1 -spi`, and by the FPGA booting with CRC
    error=1/INIT_B=0/DONE=0). Reproduced three times with byte-identical transcripts.
    -Mode Isf therefore emits `program -p N -e -v` and the verdict now has a ha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
2026-09-15 docs: record the successful ISF write and its root cause
    Run program-20260915-083244-bf54acda (Mode Isf, pinned cable, current design.bit):
    with the explicit `program -p 1 -e -v` sequence the transcript shows, in order,
    "Erasing device..." / "Erasure completed successfully." / "Programming Flash...done."
    / "Programming completed successfully." / "Verifying device...done." / "Verification
    completed successfully." / "Programmed successfully." / "Checking done pin....done."
    with no "DONE did not go high", in 7 s instead of 65 s.
    run.json: result PASS, programmingCompleted PASS, programmingVerified VERIFIED,
    preflightState COMPLETE, cableSerialSeen 210241672559 (no mismatch), programAttempts 2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
2026-09-15 docs: freeze and consolidate the verified ISE toolchain
    Toolchain Freeze v1. Documentation only: no RTL, pin, ISF, power-policy or backend
    changes, and no new programming mode.
    - README front page now leads with the five commands a course project needs
    (verify / build bitstream / probe / program -Mode Jtag / program -Mode Isf) and
    states that iMPACT batch scripts, fuse, SSH staging, Digilent target syntax and
    the ISF erase order are the tool's business, not the user's.
    - The frozen command set is listed explicitly, with the note that `program` has
    exactly two modes and no third will be added.
    - Spartan-3AN semantics recorded as verified: Jtag = assignFile + `program -p N
    -onlyFpga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
2026-09-15 tools: add an ISE GUI project generator and an encoding bridge
    The frozen ise.ps1 command set is unchanged (still twelve commands). These are two
    standalone helpers under tools/ for looking at the design in the ISE 14.7 GUI, plus
    the unit-tested helpers they share.
    - tools/make-gui-project.ps1 stages a HUMAN-VIEW copy on the VM and creates the
    .xise through ISE's own Tcl API (xtclsh + project new/xfile add), so ISE opens it
    normally: device xc3s50an / tqg144 / -4, family "Spartan3A and Spartan3AN",
    Verilog include dir src, top-level finger_piano_top, testbenches added in the
    Simulation view. It reads the repository only and prints the verified project
    properties after generating.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
2026-09-15 docs: revise optional ADC/DAC plan for 3-key migration, I2C timing, and DAC overrun
2026-09-15 docs: add stage-2 peripheral and audio-chain plans
    新增 4 份分阶段开发计划：3-bit LM393 编码输入基础设施、ADS1115 压力数据处理与标定、DDS 正弦音频发生器、DDS 到 MCP4725 数字音频链路集成。
    更新 ADS1115/MCP4725 可选外设计划：I2C 拍数改为分层规则（12 MHz + 默认 I2C_HZ 固定 18+18=36 拍，其它速率走强制公式），controller 必须暴露 I2C_HZ 参数，作废 333333 对应 36 拍的算术错误。
    第一阶段《手指钢琴ISE工程实施计划》原样移入 doc/archive/（blob 未变，git 识别为 rename）。
2026-09-15 docs: fix stale references after archiving the stage-1 plan
    README：第一阶段计划路径改为 doc/archive/...，补上第二阶段 4 份计划与可选外设计划在 doc/ 的入口；把「尚未真正烧录、未上板」更正为「-Mode Jtag / -Mode Isf 均已真机跑通，但板卡功能仍未验证（NOT_TESTED）」。
    README：09-14 的真实硬件观察小节标注日期与 HISTORICAL，并明确不再使用「下载线对虚拟机不可见」的表述，改用 DIGILENT_ENUM_FAILED / DIGILENT_OPEN_FAILED / CABLE_UNAVAILABLE 分层。
    projects/finger_piano/README.md：§12 板卡验证状态更正、扩展点补计划入口、§13 交付计数引用归档路径。
2026-09-15 docs: add the ADS1115 and MCP4725 datasheets cited by the stage-2 plans
    计划文档按路径引用 doc/ads1115.pdf（TI ZHCS311E）与 doc/MCP4725.pdf（Microchip DS22039C_CN），并入仓库后引用自洽，后续阶段无需另行下载或照抄网上示例。
2026-09-15 docs: mark the archived stage-1 plan as historical
    只在标题下加一行 HISTORICAL 横幅：注明这是第一阶段原样存档、烧录状态已被 2026-09-15 的真机写入（-Mode Jtag 两次 PASS、-Mode Isf 一次通过）取代、板卡功能仍未验证，并指向当前权威文档。正文不做任何修改。
2026-09-15 docs: add the doc index for the finger_piano stage-2 roadmap
    新增 doc/README.md：目录导航（指向 ISE工具链最终状态 与 projects/finger_piano/README.md）、三条数据链架构、P1~P5 计划总览与依赖顺序、全工程共同约束（legacy baseline、不猜引脚、默认不启用、单时钟域、Verilog-2001、仿真判据、每阶段回归、开发 Agent 不写板）、状态术语、顶层集成前的硬件阻塞项、数据手册权威性与文档维护规则。
2026-09-15 docs: render the doc index with real headings and tables, and fix two content nits
    §2~§18 补 ## 标题（17 个），2.1~2.3 / 10.1~10.8 / 12.1~12.4 补 ### 标题（15 个），与原 ## 1. 一致。
    4 处 Tab 分隔表格（§3 计划总览、§6 编码表、§7 DDS 冻结值、§11 状态术语）改为标准 Markdown 表格，单元格内容逐字未改。
    §14 命令清单由 9 条补全为冻结的 12 条（新增 new / fetch / probe-diag / board-check）。
    §12.1 端口名由 sensor_code_in[2:0] 改为 3-bit 计划中的 sensor_async[2:0]，并注明其输出为 sensor_code_stable[2:0] 与 note_code[2:0]。
2026-09-15 docs: add a project constitution for finger_piano and surface it from the entry points
    新增 projects/finger_piano/AGENTS.md（约 180 行项目宪法）：必读顺序、信息优先级、真实硬件目标（3 FSR + 3 LM393 三比特编码，不是 7 键）、legacy baseline 边界、P1~P5 顺序与依赖、工具规则、硬约束、板级安全、ADC/DAC 与压力数据原则、状态口径、开发节奏。
    根 README.md 增加「finger_piano 当前开发入口」段，指向 doc/README.md 与项目 AGENTS.md；项目 README.md 首段后加架构状态 banner，明确前部描述的是 7-key legacy baseline，真实硬件是 3 传感器。
    根 AGENTS.md：implement 门禁改为「只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
2026-09-15 docs: add status and source-priority sections, plan links, and uniform plan metadata headers
    doc/README.md：新增 §0「当前实施状态与事实来源优先级」（P1~P5 状态表 + 六级事实来源链 + 「计划文档可以比源码更先进」的说明）；§3 计划总览表与 §5~§9 的「入口」全部改为真实文件链接；§3 标题后补空行以便渲染表格。
    五份计划文档统一头部：标题规范为 # 开头，标题下插入统一 metadata（Status / Scope / Depends on / Top integration / UCF changes / Hardware programming / Acceptance）。
    P2~P5 正文的「N. 标题」统一改成「## N. 标题」，只加前缀、正文一字未改（P1 原本已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
2026-09-15 docs: require committing and pushing after each completed stage
    项目 AGENTS.md 新增「每完成一个阶段：自行提交并推送」：判定通过（simulation PASS，或整份计划收尾时完整 verify 全绿）后不逐次征询，直接 commit + push origin main；一个阶段一个 commit；推送前确认无 artifacts / tools/.work / 构建产物；推送后同步更新工程 README 与 doc/README.md 的当前实施状态表；硬件写入仍是例外，必须用户明确要求并带 -ConfirmHardwareWrite。
    根 AGENTS.md「凭据与操作范围」补一条同义规则（覆盖源码/测试/文档），并指向项目侧细则。开发节奏示意同步改为「独立 commit +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
2026-09-15 docs: record the confirmed 38-pin pool and the IO re-allocation plan
    doc/README.md §12 新增 12.1「可用引脚池与 IO 重分配」：照录用户 2026-09-15 确认的 38 个可用引脚（逐字核对，顺序与集合一致）；列出当前 UCF 占用；标明池中不含 P8/P11/P16/P18/P24（未被确认可改接）、P1/P2 保留 JTAG、GND/电源/仅输入引脚不得作普通 IO；给出迁移后的新增引脚需求（3 路传感器 + 4 路 I²C）与候选分配 P28/P29/P30、P31/P32、P76/P77（明确标注候选、待逐脚确认）；原 12.1~12.4 顺延为 12.2~12.5，并补上旧 12.2 标题前缺失的空行。
    3-bit 计划新增 §31.1「IO 重分配（与迁移同一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
2026-09-15 p1a: add command-level i2c master core with testbench
    P1 plan commit A (doc/ADS1115与MCP4725可选外设开发计划.md):
    - src/periph/i2c_master.v: Verilog-2001 command-level I2C master
    (START/RESTART/WRITE/READ/STOP), open-drain 0/Z only, sticky
    error_code (0 none / 1 NACK / 2 timeout / 3 protocol), auto-STOP
    on write NACK, per-command timeout watchdog, all SCL timing passed
    in as cycle counts by the instantiating controller (master never
    reads CFG_*_I2C_SPEED). Master reports NACK only - ADDR/DATA
    subdivision is the controller's job.
    - sim/tb_i2c_master.v: protocol slave model + 11 test groups
    (reset release, protocol errors, START/RESTART/STOP conditions,
    write+ACK, writ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
    [i2c_master.v, tb_i2c_master.v]
2026-09-15 p1b: add ADS1115 three-channel poll controller with protocol model
    P1 plan commit B (doc/ADS1115与MCP4725可选外设开发计划.md):
    - src/periph/ads1115_ctrl.v: standalone ADS1115 controller. Per-frame
    FSM scans CH0/CH1/CH2: write Config (pointer 01) -> poll Config.OS
    with >=2 ms-equivalent wait timeout -> read Conversion (pointer 00,
    MSB first, master NACK on last byte). Config words are built from
    datasheet bit fields (doc/ads1115.pdf 8-5): {OS=1, MUX, PGA, MODE=1,
    DR, COMP_QUE=11} -> C3E3/D3E3/E3E3 by default. Controller maps
    master NACK into ADDR_NACK(1)/DATA_NACK(2), master timeout -> 3,
    conversion-wait timeout -> 4. Timing params computed here per the
    frozen layered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
2026-09-15 p1c: add MCP4725 fast-write controller with pending+overrun and throughput test
    P1 plan commit C (doc/ADS1115与MCP4725可选外设开发计划.md):
    - src/periph/mcp4725_ctrl.v: standalone MCP4725 controller, Fast Write
    only (first data byte high nibble hardwired to 4'b0000 = C2C1C0=000 +
    PD1PD0=00, so an EEPROM command is structurally impossible; t_BUF
    uses the MCP datasheet's stricter 1300 ns). One pending slot +
    sticky overrun flag - latest-value-wins is forbidden; samples are
    accepted when ready (pending empty), held until the transaction
    finishes, rejected with overrun while busy. Error mapping like the
    ADC side: addr NACK -> 1, data NACK -> 2, master timeout -> 3,
    other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
    [mcp4725_ctrl.v, mcp4725_model.v, tb_mcp4725_ctrl.v]
2026-09-15 p1d: fix XST parse of generate-scope localparams; full verify green
    P1 plan commit D: the three periph RTL files were already listed in
    project.json sources (A/B/C) and finger_piano_cfg.vh already carries
    the peripheral macros (all disabled). This commit makes the sources
    XST-clean: XST 14.7 rejects localparam inside a generate block
    (ERROR:HDLCompilers:26 expecting 'end' found 'localparam'), so all
    constant localparams in ads1115_ctrl/mcp4725_ctrl move to module
    scope (they are ENABLE-independent); regs/always/instance stay in
    the generate branches (same pattern as key_filter.v).
    Top untouched: no ports, no instances, no UCF changes, ENABLE
    macros still 0 - the peripherals remain driver-de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
    [ads1115_ctrl.v, mcp4725_ctrl.v]
2026-09-15 p1e: document the ADC/DAC peripheral infrastructure and update status
    P1 plan commit E:
    - doc/ADC_DAC扩展设计.md: full design doc covering the plan's 16
    required items - dual I2C rationale, wiring plans (ADS1115
    ADDR=GND/0x48, MCP4725 A0/0x60, 4.7k pullups to 3.3V), config
    macros, C3E3/D3E3/E3E3 derivation from datasheet bit fields, ADC
    FSM + OS polling, DAC fast-write frame and VOUT update edge,
    EEPROM prohibition (25/50 ms + wear), the mandated I2C cycle
    formula with the 32-bit-safe form and the frozen 12 MHz default
    18+18=36 cycles (333333 is nominal, 400k optional only), ENABLE
    macro semantics (integration-ready; real enable needs top ports +
    instantiation + 4 confi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
2026-09-15 p2a: add 3-bit sensor code decoder with full 8-code testbench
    P2 plan commit A (doc/3bit传感器编码输入基础设施开发计划.md):
    - src/input/sensor_code_decoder.v: combinational decoder from the
    stable 3-bit sensor code to note_code using an explicit case as
    the frozen encoding table semantic boundary (000=mute,
    001..111=note 1..7; identity mapping kept explicit on purpose).
    All 8 states are defined by design - no illegal-code logic per
    plan section 28.
    - sim/tb_sensor_code_decoder.v: sweeps all 8 codes and checks the
    table entry by entry.
    - project.json: decoder added to synthesis sources (referenced
    modules before their users); new sensor_code_decoder simulation.
    E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
2026-09-15 p2b: add atomic whole-vector 3-bit code filter with leak monitor
    P2 plan commit B (doc/3bit传感器编码输入基础设施开发计划.md):
    - src/input/sensor_code_filter.v: the key new module - atomic
    whole-vector stable filter (single candidate register + single
    counter + stable register, one update for all three bits). Never
    per-bit filtering: multi-bit transitions like 001->111 may pass
    through 011/101 and per-bit debounce would commit those as wrong
    notes. STABLE_CYCLES = max(1,(SYS_CLK_HZ/1000)*STABLE_MS) matches
    the key_filter debounce definition; ENABLE=0 generate bypass is a
    pure assign. Update semantics locked by TB: unchanged at N-1
    consecutive observations, upda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
    [sensor_code_filter.v, tb_sensor_code_filter.v]
2026-09-15 p2c: add sensor code frontend reusing key_sync WIDTH=3
    P2 plan commit C (doc/3bit传感器编码输入基础设施开发计划.md):
    - src/input/sensor_code_frontend.v: complete future-top-ready chain:
    polarity normalize (single inversion point, ACTIVE_HIGH param,
    default 1 = press-high per the analog convention) -> existing
    key_sync #(.WIDTH(3)) two-flop synchronizer (reused, not copied;
    ASYNC_REG inherited) -> sensor_code_filter atomic vector filter ->
    sensor_code_decoder. Order is fixed sync-first-filter-second; one
    clk domain; sensor input never used as a clock.
    - sim/tb_sensor_code_frontend.v: shortened params (N=10), covers
    000->mute, 001->C4, 011->E4, 111->B4, 111->000 re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
    [sensor_code_frontend.v, tb_sensor_code_frontend.v]
2026-09-15 p2e: document the 3-bit input infrastructure and update status
    P2 plan commit E:
    - doc/3bit传感器编码输入基础设施开发计划.md: status PLANNED ->
    IMPLEMENTED / STANDALONE with the commit list (776659d / c454e22 /
    1821585), the full-verify evidence and the file inventory; the
    section-31 top migration still waits for the user to confirm the
    three LM393 pins.
    - doc/README.md: P2 row PLANNED -> SIMULATED (IMPLEMENTED /
    STANDALONE, not integrated, no board test).
    - projects/finger_piano/README.md: new 12.2 section (IMPLEMENTED /
    STANDALONE, NOT_INTEGRATED, BOARD PINS TODO) and round-9
    verification record.
    Evidence: verify-20260916-015815-edd2f5fa Overall PASS - synthes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
2026-09-15 p3a: freeze the DDS frequency math table
    P3 plan commit A (doc/DDS正弦音频发生器开发计划.md): new
    projects/finger_piano/dds_frequency_table.md, separate from the
    legacy square-wave frequency_table.md. Freezes: course-nominal
    7-note frequencies (two-decimal), SAMPLE_RATE_HZ=8000 (reuses
    CFG_DAC_SAMPLE_RATE), PHASE_BITS=24, increment formula
    round(f*2^24/8000), the seven increments in decimal/hex
    (548657=085F31 ... 1035741=0FCDDD, hand-rechecked), theoretical
    DDS frequencies and errors (all << 0.001%), 12 MHz/8 kHz exact
    divide (SAMPLE_DIV=1500), quarter-wave LUT definition
    (M[k]=round(1792*sin(k*pi/128)), key points 2048/3840/2048/256,
    range 256..3840, mute=2048), and the warnings: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
2026-09-15 p3b: add quarter-wave 12-bit sine LUT with 256-phase testbench
    P3 plan commit B (doc/DDS正弦音频发生器开发计划.md):
    - src/audio/sine_lut_12bit.v: quarter-wave LUT, 65x11-bit magnitude
    M[k]=round(1792*sin(k*pi/128)) frozen as a constant case (values
    generated offline; no real/$sin/runtime generation in RTL).
    phase_addr[7:6] quadrant + [5:0] index combine to the unsigned
    offset sine DAC = 2048 +- M with range 256..3840; key points
    0->2048, 64->3840, 128->2048, 192->256. Two-level combinational
    case with full enumeration + default (no latch); BRAM inference
    deliberately not forced (plan section 46: 0-warning priority).
    - sim/tb_sine_lut_12bit.v: sweeps all 256 phases -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
2026-09-15 p3c: add DDS sine generator core with cadence/transition tests
    P3 plan commit C (doc/DDS正弦音频发生器开发计划.md):
    - src/audio/dds_sine_generator.v: note_code -> frozen phase increment
    table (section-20 case, see dds_frequency_table.md) -> 24-bit phase
    accumulator advancing only on a 1-clk sample_tick -> sine_lut_12bit
    -> registered dac_code with a strictly periodic 1-clk
    dac_code_valid. SAMPLE_DIV = SYS_CLK_HZ/SAMPLE_RATE_HZ (12 MHz/8 kHz
    = 1500 exact). Note switch resets phase to zero and forces the
    mid-code 0x800 as the next sample (predictable restart like
    tone_generator) WITHOUT touching the sample divider - the 8 kHz
    cadence is invariant across note changes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
    [dds_sine_generator.v, tb_dds_sine_generator.v]
2026-09-15 p3d: add seven-note frequency and phase-increment verification to the DDS testbench
    P3 plan commit D: extends tb_dds_sine_generator with the T5 section
    (fast 1 MHz sim only, section 30):
    - all seven notes C4..B4 measured end to end: 8192 valid samples per
    note, rising zero crossings (dac_code < 2048 -> >= 2048) counted,
    f_meas = crossings/N*8000, |err| < 1% required - measured errors
    are all <= 0.4 percent (C4 260.742 vs 261.62 ... B4 493.164 vs
    493.88), which also exercises the 24-bit phase wrap ~268 times per
    note with no X and no cadence disturbance;
    - independent phase-increment math check per note: real recompute of
    round(f_nom*2^24/8000) compared against the DUT's live phas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
    [tb_dds_sine_generator.v]
2026-09-15 p3e: move SAMPLE_DIV localparam out of generate; full verify green
    P3 plan commit E: the integration was already distributed across
    commits B/C (sources + the four new sims in project.json). XST
    again rejected the one localparam inside dds_sine_generator's
    generate block (same HDLCompilers:26 pattern fixed for the P1
    controllers), so SAMPLE_DIV moves to module scope; it depends only
    on the SYS_CLK_HZ/SAMPLE_RATE_HZ parameters.
    Top untouched: tone_generator/audio_out/finger_piano_top/UCF all
    zero-change; peripherals and DDS remain standalone and disabled.
    Evidence: verify-20260916-023327-306facb2 Overall PASS, stage
    IMPLEMENT_ALLOWED - synthesis 0 errors / 0 warnings / 0 latches,
    232 FF / 2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
    [dds_sine_generator.v]
2026-09-15 p3f: document the DDS sine generator and update status
    P3 plan commit F: DDS plan status header PLANNED -> IMPLEMENTED /
    STANDALONE with the commit list and verify evidence; doc/README.md
    P3 row PLANNED -> SIMULATED (not integrated, no board test);
    projects/finger_piano/README.md new 12.3 DDS section plus round-10
    verification record. Status marks: IMPLEMENTED / SIMULATED /
    NOT_INTEGRATED / NOT_BOARD_TESTED - explicitly NOT claiming DDS
    hardware PASS since MCP4725 is not connected yet (P4).
    Evidence: verify-20260916-023327-306facb2 Overall PASS (0 errors /
    0 warnings synthesis, 232 FF / 20 IOs, 17/17 simulations). P3
    complete; P4 (DDS -> MCP4725 pipeline) is next. No top/UCF changes;
    no har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
2026-09-15 p4a: add DDS->MCP4725 pipeline wrapper (structural only)
    P4 plan commit A (doc/DDS到MCP4725数字音频链路集成计划.md):
    src/audio/dds_mcp4725_pipeline.v - pure structural integration layer
    wiring the existing dds_sine_generator to the existing mcp4725_ctrl
    on its own I2C bus. No second sample counter, no resampling, no
    FIFO, no volume multiplier, and no ready feedback into the DDS
    (fixed 8 kS/s time axis frozen; MCP4725 pending/overrun reports
    backpressure instead). I2C timing stays in mcp4725_ctrl/i2c_master;
    the pipeline only passes SYS_CLK_HZ / DAC_I2C_HZ / MCP4725_ADDR
    down. Debug outputs: dds_code_debug / dds_valid_debug /
    dac_ready_debug (for the end-to-end scoreboard). ENABLE=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
    [dds_mcp4725_pipeline.v]
2026-09-15 p4b: add end-to-end DDS->MCP4725 scoreboard testbench (basic mode)
    P4 plan commit B (doc/DDS到MCP4725数字音频链路集成计划.md):
    sim/tb_dds_mcp4725_pipeline.v - one TB, four parameterized sims.
    Basic mode (12 MHz real clock, TB_SYS_CLK_HZ generic): reset/idle
    bus checks, 128 mute samples all 0x800, seven notes x 128 samples
    each with a per-sample scoreboard (DDS valid pushes expected code;
    MCP4725 model write completion pops and compares in strict order -
    catches misalignment, stale repeats, drops, byte-split errors),
    note-switch restart sample == 0x800, transition sequence
    C4->A4->B4->mute. Global monitors: dac_ready==1 at every dds_valid
    (section 20), per-sample max latency < samp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
    [tb_dds_mcp4725_pipeline.v]
2026-09-15 p4c/d: fix throughput counters, zero-crossing estimator, error-mode stats
    P4 plan commits C+D verification fixes for tb_dds_mcp4725_pipeline:
    - expected/captured/push-time arrays enlarged 4096 -> 8192 (the
    12m sequence is 7168 samples; the old 4096-deep array wrapped and
    produced false scoreboard mismatches after sample 4096);
    - captured-stream frequency spot checks now use a first-to-last
    crossing-span estimator f=(n-1)/(span)*fs instead of raw crossing
    count (count quantization of +-1 over a 2048-sample window is
    +-1.5 percent, which alone exceeds the 1 percent budget); measured
    C4 -0.02% / A4 +0.01% / B4 +0.04%;
    - mode-2 error statistics (err_pulses/dropped/sb_mismatch) are no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
    [tb_dds_mcp4725_pipeline.v]
2026-09-15 p4f: document the DDS->MCP4725 pipeline and update status
    P4 plan commit F: pipeline plan status PLANNED -> IMPLEMENTED /
    STANDALONE with commit list and verify evidence; doc/README.md P4
    row PLANNED -> SIMULATED (end-to-end digital chain passed, not top
    integrated); projects/finger_piano/README.md new 12.4 pipeline
    section and round-11 verification record. Status: end-to-end
    DIGITAL audio stream PASS - SIMULATED / NOT_TOP_INTEGRATED /
    NOT_BOARD_TESTED; analog sine output, reconstruction filter and
    LM386 are explicitly NOT claimed verified (plan sections 39/40).
    Evidence: verify-20260916-030251-5159ebcd Overall PASS (synthesis
    0 errors / 0 warnings / 0 latches, 232 FF / 20 IOs, 21/21
    simula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
2026-09-15 p5a: add atomic pressure frame capture with testbench
    P5 plan commit A (doc/ADS1115压力数据处理与标定基础设施开发计划.md):
    src/pressure/pressure_frame_capture.v - latches the three ADS1115
    raw channels into a coherent scan frame on one clk edge when
    adc_sample_valid fires (atomic update, never new-CH0/old-CH1/old-CH2
    half-states); frame_valid is exactly 1 clk wide and aligned with the
    new frame; reset clears everything and no fake frame_valid is
    generated. Wording frozen per plan section 3: this is a three-channel
    polled scan frame, NOT simultaneous sampling.
    sim/tb_pressure_frame_capture.v: 17 checks - reset state, hold
    without valid, atomic latch, 1-clk valid width, secon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
    [pressure_frame_capture.v, tb_pressure_frame_capture.v]
2026-09-15 p5b: add pressure channel corrector with signed-clamp testbench
    P5 plan commit B: src/pressure/pressure_channel_corrector.v -
    combinational per-channel conditioning with the frozen order:
    negative ADC codes clamp to 0 (never absolute value - a -100 code
    is zero-neighborhood noise, not +100 pressure), then ZERO_OFFSET
    subtraction, then underflow saturation to 0 (no unsigned wrap).
    Output is 15-bit unsigned magnitude (single-ended positive codes
    are 0x0000..0x7FFF). ZERO_OFFSET defaults to 0 = UNMEASURED DEFAULT,
    never agent-invented. project.json: corrector added to sources;
    pressure_channel_corrector simulation.
    Evidence: 'TB_PRESSURE_CHANNEL_CORRECTOR: PASS (checks=20,
    errors=0)' covering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
    [pressure_channel_corrector.v, tb_pressure_channel_corrector.v]
2026-09-15 p5c: add three-channel pressure processor with zero macros
    P5 plan commit C: src/pressure/pressure_processor.v - structural
    wrapper: pressure_frame_capture -> 3x pressure_channel_corrector
    (plan section 18 scheme A, combinational correction on the frame
    registers so pressure_valid == frame_valid and data/valid are
    same-edge aligned). Deliberately EXCLUDED per plan: sensor_code/
    note_code inputs (LM393 note path and ADS1115 pressure path stay
    decoupled), pressure_level thresholds, max/mean/min fusion,
    volume/pitch mapping, voltage/newton conversion, 0..4095
    normalization, stale-timeout, adc_error input (driver errors simply
    produce no new frame), and an ENABLE parameter (pure data module -
    in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
    [pressure_processor.v, tb_pressure_processor.v]
2026-09-15 p5d: add ADS1115-to-pressure full-chain integration testbench
    P5 plan commit D (sections 46/47): sim/tb_ads1115_pressure_pipeline.v
    chains the existing ads1115_model -> ads1115_ctrl ->
    pressure_processor (pure simulation, no analog FSR/TL084/RC
    modeling per section 48). The model supplies CH0=0xFFFF (negative
    neighborhood code), CH1=1000, CH2=2500; zeros 0/100/200. After
    3 complete scan frames the corrected pressures are exactly
    0/900/2300 and adc_error stays 0 - proving I2C byte order, signed
    code handling, atomic frame capture and zero-offset correction
    across the whole chain. project.json: ads1115_pressure_pipeline
    simulation (TB + model sources).
    Evidence: 'TB_ADS1115_PRESSURE_PIPELINE: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
    [tb_ads1115_pressure_pipeline.v]
2026-09-15 p5f: add pressure calibration document and update status
    P5 plan commit F:
    - projects/finger_piano/pressure_calibration.md: STATUS =
    NOT_CALIBRATED. Analog-front-end record (FSR/RSET/TL084/RC/PGA
    001 +-4.096V/860SPS), per-channel Released/Light/Normal/Strong
    tables with min/max/avg raw-code fields - all real TODOs, never
    agent-invented numbers; ZERO selection method documented
    (ZERO = released_max + margin, margin from measured noise);
    explicit not-doing list: full-scale gain calibration, 0..4095
    normalization, voltage conversion, newton conversion, threshold
    levels, fusion strategy.
    - projects/finger_piano/README.md: new 12.5 pressure section
    (IMPLEMENTED / SIMULATED / ZER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
2026-09-16 p6a: close out P1/P5 plan statuses and stale baseline wording
    - Mark P1 and P5 plan documents as IMPLEMENTED / SIMULATED / STANDALONE
    - Fix wrong commit counts for P2/P4/P5 in the project README
    - Annotate the legacy stage-1 status section and the superseded
    P1..P40 pin-pool wording in the project README section 7
    - Sync doc/README.md: P6 added to status table, plan overview and
    execution order; pin-pool sync note now points at P6B only
    - Remove the unconsumed CFG_DDS_PHASE_BITS pseudo-parameter (P6 sec 4):
    the 24-bit accumulator is a frozen RTL implementation detail
    - Add the P6 plan document itself
2026-09-16 p6b: add stage-2 finger_piano_system core (structural wiring only)
    Pure connection layer over the verified P1-P5 modules:
    - sensor_code_frontend -> sensor_code_stable / note_code
    - note_code -> dds_mcp4725_pipeline -> dac I2C + error/overrun
    - ads1115_ctrl -> pressure_processor (raw wires joined inside)
    - ENABLE_ADC / ENABLE_DAC gate the two I2C chains independently;
    no system-level FSM, no reset_sync re-instantiation, no
    pressure-to-note coupling, two separate I2C buses kept
    Added to project.json sources; top stays legacy finger_piano_top.
    Synthesis check: 0 errors / 0 warnings, 232 FF / 20 IOBs unchanged
    (system module compiled then trimmed, P6 sec 33 satisfied).
    [finger_piano_system.v]
2026-09-16 p6c: add system-level testbench with basic sensor->note->DAC and ADS->pressure checks
    tb_finger_piano_system (TB_MODE-selectable) runs the full stage-2
    system core against both I2C behavioral models at the real 12 MHz
    beat and 10 ms filter threshold:
    - reset state: outputs 0, both buses released high (P6 sec 17)
    - ADS scan frames -> pressure 1000/2000/3000 with zero=0 (sec 21)
    - full 000..111..000 sensor walk: stable/note switching gated by
    the whole-vector filter, MCP-captured audio verified sample-by-
    sample against an independent Taylor-series LUT model with the
    same 8-bit phase quantization (sec 18)
    Waveform expectation uses LUT[phase[23:16]] semantics - comparing
    against the exa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
    [tb_finger_piano_system.v]
2026-09-16 p6d: add dual-bus decoupling, error isolation, mid-tx reset and enable-combo system tests
    Five new TB modes over the same system testbench:
    - system_stage2_dual_i2c (MODE 1): CH0 source injected through the
    ADS model (500/5000/20000) while note stays C4 and the captured
    DAC stream still matches the C4 waveform sample-by-sample;
    rapid note switches never stall the ADC frame flow (P6 20/22/23)
    - system_stage2_error_isolation (MODE 2): ADC address-NACK storm
    leaves DAC writing untouched and vice versa; reset while BOTH
    masters are mid-transaction releases both buses, clears all
    state, and both chains restart with clean full frames (P6 24/25)
    - system_stage2_disabled/adc_only/dac_on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
    [tb_finger_piano_system.v]
2026-09-16 p6e: add longrun system simulation, close out P6A, record final status
    - system_stage2_longrun (MODE 3): real 860 SPS conversion timing,
    C4 held while ADC scans independently - 8224 captured DAC samples
    matched sample-by-sample against the independent LUT model
    (start k=15), 8319 DAC frames + 223 ADC frames, 0 errors
    (P6 sec 26)
    - Full verify verify-20260916-093257-7d8be13c: Overall PASS,
    synthesis 0 errors / 0 warnings / 0 latches, 232 FF / 20 IOs
    (legacy baseline unchanged), 32/32 simulations PASS
    - Documentation: P6 plan status, doc/README.md status table,
    project README section 12.6 and round-13 record
    P6A frozen per P6 sec 34: SYSTEM DIGITAL CORE = SIMULATED /
    STANDALONE,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
    [tb_finger_piano_system.v]
2026-09-16 p6b: add final top and UCF migration plan (frozen pins)
    USER CONFIRMED pin map: clk=P57 rst_n=P3 sensor=P28/P29/P30 adc_i2c=P31/P32 dac_i2c=P102/P103 note_debug=P110/P111/P113. VCCO=3.3V LVCMOS33. Hardware programming and board test explicitly excluded.
2026-09-16 p6ba: add stage-2 physical top wrapper (top still legacy)
    New src/finger_piano_stage2_top.v is a wrapper only: reset_sync -> finger_piano_system, note_code -> note_debug. No subsystem reimplementation, no legacy key/audio ports, two independent I2C buses kept. Added to project.json sources; project top stays finger_piano_top. Synth run 20260916-152021-ce582c49: 0 errors / 0 warnings / 0 latches, 232 FF / 20 IOs (stage2 top compiled but not elaborated).
    [finger_piano_stage2_top.v]
2026-09-16 p6bb: add stage-2 top testbench and simulation entry
    sim/tb_finger_piano_stage2_top.v verifies only the physical wrapper: reset_sync gating, top-level inout I2C wiring to ads1115_model/mcp4725_model, note_code->note_debug, sensor 000/001/011/111/000 -> note_debug 0/1/3/7/0 with real 10 ms filter threshold, MCP4725 Fast Writes for note 1/7/mute, internal pressure frames 1000/2000/3000, zero adc_error/dac_error/dac_overrun, no EEPROM command. sim-20260916-152125-85857e36: 29 checks / 0 errors, TB_FINGER_PIANO_STAGE2_TOP: PASS.
    [tb_finger_piano_stage2_top.v]
2026-09-16 p6bc: rewrite UCF for frozen stage-2 pin map
    Active UCF now only constrains the 12 stage-2 top ports: clk=P57, rst_n=P3, sensor_async[0..2]=P28/P29/P30, adc_i2c_scl/sda=P31/P32, dac_i2c_scl/sda=P102/P103, note_debug[0..2]=P110/P111/P113, all LVCMOS33, VCCO=3.3V (user confirmed). Legacy key_in/key_debug/audio_out and old note_debug nets removed (their map stays in README/Git history). No PULLUP, no TNM_NET on I2C, P76/P77 not used. Project top cutover follows in the next commit. check -Stage implement PASS.
2026-09-16 verify: classify audited XST trim warnings via a reviewed allowlist
    synthesisWarningAllowlist in verification lets a project declare the exact low-level XST trim messages that were audited as benign (id + regex over the warning text + expected count). verify classifies the raw synthesis.srp, itself unchanged: matched warnings are allowed, every unmatched warning/class/path or a changed per-entry count still fails. failOnSynthesisWarnings stays true and there is no project-name special case. Only the gate changed; XIL_XST_HIDEMESSAGES and fake KEEP/DONT_TOUCH consumers are deliberately not used. test-tools.ps1 covers allowed, unexpected and count-drift paths.
2026-09-16 p6bd: switch project top to finger_piano_stage2_top
    project.json top = finger_piano_stage2_top; the 12-pin UCF from p6bc now applies to it. Synth run 20260916-153555-b4d6b31b: 0 errors / 0 latches / 12 IOs / 417 FF / 1101 LUTs / 578 slices / 1 GCLK, warnings 166 all matched by the reviewed allowlist (unexpected 0). Full verify verify-20260916-153554-00e49086 Overall PASS (33 simulations incl. stage2_top, implement gate open). No hardware write.
2026-09-16 p6be: record stage-2 top migration and full verification
    verify-20260916-153554-00e49086 Overall PASS, Stage IMPLEMENT_ALLOWED: 0 errors / 166 audited warnings (0 unexpected) / 0 latches / 12 IOs; all 33 simulations PASS including legacy, P1-P6A and stage2_top. Documents the frozen 12-pin map, the rewritten UCF, the stage2 top TB, and why the unconsumed P5/debug hierarchy is intentionally synthesis-trimmed (allowlist, failOnSynthesisWarnings still true). BOARD = NOT_TESTED; no program run.
2026-09-16 p6bf: record stage-2 implementation and timing review
    build -Stage implement run 20260916-154225-79f5b654: MAP 0/0, PAR 0/0, all signals routed, Timing Score 0, exit codes 0. routed_pad.txt shows all 12 frozen IOs LOCATED with the confirmed banks/LVCMOS33 and no auto-assigned IO. timing.twr read by hand: TS_clk = PERIOD clk_group 83.33 ns, 0 timing errors (0 setup/0 hold/0 CSL), minimum period 12.362 ns, worst setup slack 70.968 ns, all constraints met. UCF still has no OFFSET constraints, so board-level IO timing is not certified; no bitstream/program step run.
2026-09-16 p6bg: close out P6B documentation (stage-2 top, P5 trim note, NOT_BOARD_TESTED)
    project README: stage-2 top is now the formal top (header/status/ports/UCF pin table/constraintsReviewed checklist), legacy 7-key map kept as history, P2-P4 marked INTEGRATED, P5 marked RTL-integrated/system-simulated/intentionally synthesis-trimmed with no hardware consumer. doc/README P6 row and roadmap = P6 COMPLETE. P6 plan header = P6A COMPLETE + P6B COMPLETE with the frozen pin table and run ids. Root/project AGENTS document the reviewed synthesisWarningAllowlist and forbid KEEP/DONT_TOUCH/fake consumers/global hiding. BOARD = NOT_TESTED, FSR = NOT_CALIBRATED, no program run.
2026-09-16 p7: add FPGA bring-up and clock divider board verification plan
    Independent diagnostic project (finger_piano_clock_test) with frozen outputs ref_2mhz=P110 / ref_100khz=P111 / ref_1khz=P113, inputs clk=P57/rst_n=P3. Main stage-2 top/UCF/allowlist must not be touched; xc3s50an_smoke must not be repurposed. Agent stops at READY_FOR_BOARD_TEST; no JTAG/ISF program without explicit user authorization.
2026-09-16 p7a: clean up stale P6 documentation and comments (no functional RTL change)
    P6B plan status = P6B COMPLETE. doc/README: 10.5 states 0 errors / 0 *unexpected* warnings / 0 latches with the reviewed synthesisWarningAllowlist as the only documented exception; section 12 replaced the old 38-pin pool/P76-P77/P78-P79-P90 candidates with the frozen 12-pin stage-2 map and confirmed LM393/I2C LOCs. project AGENTS.md records P6 COMPLETE + final pin map. finger_piano_system.v header comment updated (comment only). project README marks the legacy tree/relations as historical and syncs P1/P2 status to INTEGRATED. verify-20260916-160521-7c6feb5b Overall PASS, 166 allowed / 0 unexpected.
    [finger_piano_system.v]
2026-09-16 p7b: add independent finger_piano_clock_test project (RTL + UCF + config)
    Diagnostic project only; main finger_piano top/UCF/allowlist and xc3s50an_smoke untouched. clock_test_top divides the single P57 12 MHz clock: ref_2mhz=P110 (toggle every 3 clk), ref_100khz=P111 (every 60), ref_1khz=P113 (every 6000), all LVCMOS33, rst_n=P3, min-width counters. Synth run 20260916-161221-1f5c79db: 0 errors / 0 warnings / 0 latches, 24 FF / 49 LUT / 5 IOs / 1 GCLK. No allowlist used.
    [clock_test_top.v]
2026-09-16 p7c: add clock-test simulation entry and testbench
    tb_clock_test_top measures clk-cycle spacing at 12 MHz: reset forces counters and all three outputs to 0; half periods exactly 3/60/6000 clk and full periods 6/120/12000 clk (rising-to-rising); a mid-run reset pulls outputs to 0 and release restarts from a full half period. sim-20260916-161250-2e2f93ca: 23 checks / 0 errors, TB_CLOCK_TEST_TOP: PASS.
    [tb_clock_test_top.v]
2026-09-16 p7d: record clock-test verify/implement/bitstream results and recovery bitstream
    verify-20260916-161314-e4afa190 Overall PASS (0 warnings, no allowlist, clock_test_top PASS). implement 20260916-161330-82a13ebe MAP/PAR 0/0, fully routed, Timing Score 0; 5 pins LOCATED (P57/P3/P110/P111/P113); timing.twr: TS_clk 83.33 ns, 0 timing errors, min period 7.670 ns, worst slack 75.660 ns. bitstream 20260916-161405-0050b850 design.bit 54738 bytes SHA256 9E1DBC034C1B05CD2BF1ED623FCB826783FD6081CF166DEACA8C78DB47DC40D4. Recovery artifact: finger_piano stage-2 bitstream 20260916-161434-96853257 SHA256 65A18EE6F191CC72DF9B9793B2308423AF530F3E8CCC37DFF55A8B07BD3518BA (@bd85e3a). doc/README status table and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
2026-09-16 p7e: pin clock-test cable config and record authorized JTAG/ISF hardware results
    Add the proven Digilent cable block (SN 210241672559, 10000000 Hz, position 1) so the formal path pins the cable instead of -p auto. User authorized 'test and ISF': probe-20260916-161920-d2cb6b83 PASS (xc3s50an 0x02610093); JTAG volatile program-20260916-161933-4e479624 programmingCompleted PASS / CONFIG_STATUS_OK (DONEIN=1, CRC error=0, M[2:0]=011); ISF program-20260916-161953-65d8c7ac Erase->Program->Verify all succeeded, programmingVerified VERIFIED, no Verify failed / no DONE error. Cold boot, P110/P111/P113 frequency, reset and 5 power cycles remain NOT_TESTED (user measurement only); userDesignFunctional =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
2026-09-16 gui-project: make include files reachable in the ISE simulation view
    ISE 14.7 does not read 'Verilog Include Directories' for the Simulation view (it is a Synthesis Options / XST -vlgincdir setting; the hierarchy parser and ISim/fuse only search the project directory). make-gui-project.ps1 now also copies each includeFiles entry to the GUI project root, and the generated Tcl stores the include dir as an absolute path. Verified on the VM by running fuse from the gui-project dir with no -i (RC=0, module compiles). Added a unit assertion. Regenerated the finger_piano and finger_piano_clock_test GUI copies.
2026-09-16 p8a: add 12-bit center-2048 digital audio gain (shift/add, no multiplier)
    Pure combinational gain around the DAC midpoint:
    sample_out = 2048 + floor-shifted delta * level / 8, level 0..7
    with delta = sample_in - 2048 sign-extended explicitly. All right
    shifts are arithmetic; level table per P8 sec 6 (delta/8, /4,
    /4+/8, /2, /2+/8, /2+/4, delta-/8). No saturation branch on
    purpose: with 12-bit inputs the result is mathematically inside
    [0,4095] (unit TB exhaustively proves it), and an unreachable
    saturator would only create new trim warnings against the frozen
    166-entry allowlist (P8 sec 19).
    Synthesis check with the file in sources: 0 errors, warning count
    166 = frozen allowlist baseline (m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
    [audio_gain_12bit.v]
2026-09-16 p8b: add exhaustive audio_gain unit testbench and wire into project
    tb_audio_gain_12bit verifies all 4096 x 8 input/level combinations
    against an independent integer reference with the same floor
    (arithmetic-shift) truncation rule, plus: center/mute semantics,
    positive and negative half-wave known-point tables, +-1 LSB floor
    symmetry, and monotonic gain magnitude across levels (P8 sec 9/10).
    audio_gain_12bit: 43126 checks / 0 errors, PASS.
    [tb_audio_gain_12bit.v]
2026-09-16 p8c: add DDS->gain->MCP4725 standalone pipeline with end-to-end testbench
    dds_gain_mcp4725_pipeline wires the existing 8 kS/s DDS into
    audio_gain_12bit and the existing MCP4725 controller - no second
    sample counter, no FIFO, no ready feedback, volume is a plain
    2-bit... 3-bit input (P8 sec 12/17: never pressure-driven). The
    verified P4 pipeline stays untouched as the baseline.
    tb_dds_gain_mcp4725_pipeline runs the real 12 MHz beat through
    mute(A) C4 x level 1/4/7, A4 x 2/6, B4 x 7, mute(B) - 3840 samples:
    - scoreboard compares every captured DAC code against an
    independent floor-shift gain model applied to the DDS code and
    volume latched at push time: 0 mismatch
    - mute semantics A (note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
2026-09-16 p8d: tighten audio_gain bit widths to keep synthesis warning-free; record resource numbers
    Unit regression after the width rework: 43126 checks / 0 errors.
    Full finger_piano verify (verify-20260917-000404-6eb8350a): Overall
    PASS, 35/35 simulations, 0 errors, 166 warnings = exactly the frozen
    allowlist (unexpected = 0), 417 FF / 12 IOs unchanged.
    Standalone resource synthesis of audio_gain_12bit (temporary
    project, top ports to prevent trimming, run
    20260917-000243-066eda17): 0 errors / 0 warnings, 43 slices,
    80 LUT4, 0 FF (pure combinational), 0 multipliers - shift/add
    requirement met (P8 sec 20). Intermediate wires narrowed so no
    constant-zero bits remain for XST to trim (Xst:646 hygiene);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
    [ads1115_ctrl.v, ads1115_model.v, audio_gain_12bit.v, dac_diag_source.v, i2c_master.v, mcp4725_ctrl.v, mcp4725_model.v]
2026-09-16 p8e: close out P8 documentation (status, plan, README, doc index)
    P8 final state: AUDIO GAIN RTL = IMPLEMENTED, unit + pipeline sims
    PASS, DDS->GAIN->MCP PIPELINE = SIMULATED / STANDALONE (not wired
    into stage-2 on purpose), PRESSURE->VOLUME = NOT_IMPLEMENTED,
    FSR = NOT_CALIBRATED, BOARD AUDIO VOLUME / LM386 / SPEAKER =
    NOT_TESTED. No program was executed.
2026-09-16 p9a-d: add periph_test board-diagnostic project with debug top, DAC modes and 7 simulations
    Independent project finger_piano_periph_test (P9 plan):
    - periph_test_top: reset + ADS1115 controller + MCP4725 diagnostic
    source/controller + 3 status pins only - no sensor/pressure/DDS
    logic (P9 sec 7)
    - dbg_alive P110 ~1 Hz heartbeat (parameterized half-cycle,
    6000000 on hardware), dbg_adc P111 toggles per complete ADS
    three-channel frame, dbg_error P113 sticky
    OR(adc_error, dac_error, overrun), reset-clears-only
    - dac_diag_source TEST_MODE 0/1/2 = DC 0x800/0x400/0xC00, mode 3 =
    1 kHz/8 kS/s 8-sample wave (round(1792*sin) reviewed constants
    3316/780 replacing the plan's approximate 33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
    [periph_test_top.v, tb_periph_test_top.v]
2026-09-16 p9e-f: implement/bitstream periph_test, record SHA256, close out P9 documentation
    - verify-20260917-004113-3c4a791f Overall PASS: 7/7 simulations,
    0 errors; the 144 synthesis warnings are structural benign trims
    (ADS conversion values intentionally never consumed per P9 sec
    12; TEST_MODE is a compile-time constant so DC-mode DAC payload
    is constant by design) - each of the 144 lines was reviewed and
    folded into this project's own exact-match allowlist with a
    full-audit note; any new warning or count drift still fails
    verify. The formal finger_piano 166-entry allowlist is untouched.
    - implement 20260917-004237-e5b4c5b2: MAP/PAR 0 errors / 0
    warnings, 317 FF / 455 slices, all 9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
2026-09-17 docs+p8-test: correct gain math wording and add ideal-reference check; state P9 warning reality
    P8 (no functional RTL change):
    - audio_gain_12bit header comment and P8 plan sections 4/10 now
    describe the shift/add table as a quantized approximation of the
    ideal floor(delta*level/8) gain with <= 1 LSB error, not the
    exact ideal value
    - tb_audio_gain_12bit adds a truly independent ideal reference
    floor(delta*level/8) (strict floor toward -inf) and checks every
    one of the 4096x8 combinations for |RTL - ideal| <= 1 LSB on top
    of the existing bitwise shift/add reference
    - updated unit test: 80052 checks / 0 errors, PASS
    P9 (documentation only - no RTL, UCF or allowlist changes, no
    re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
    [audio_gain_12bit.v, tb_audio_gain_12bit.v]
2026-09-17 p9f: add ifdef DAC mode-3 build switch and record authorized ISF/JTAG writes
    periph_test_top.v now selects DAC_TEST_MODE=3 only when P9_DAC_MODE3 is defined (default stays 0, matching the audited mode-0 synthesis-warning allowlist); project.json defines stays empty. Baseline verify-20260917-152255-62bd2ff6 Overall PASS (144 allowed / 0 unexpected, 7/7 sims). Mode-3 bitstream 20260917-152127-13a3ee2f built with -define P9_DAC_MODE3 (121 warnings, not verify-gated).
    Authorized hardware writes 2026-09-17: ISF mode 0 (program-20260917-150508-cb48ed1d, erase/program/verify all success, VERIFIED) and volatile Jtag mode 3 (program-20260917-152236-2c99ad5e, CONFIG_STATUS_OK, M[2:0]=011, DONEIN=1, C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
2026-09-17 p9f: record volatile mode-0 restore on periph_test fabric
    program-20260917-153713-a2dbc37a switched the volatile fabric from DAC_TEST_MODE=3 back to mode 0 (CONFIG_STATUS_OK, M[2:0]=011, DONEIN=1, CRC=0). ISF was already mode 0; no ISF write. Board measurements remain TODO.
2026-09-17 od_test: add standalone P31/P32 open-drain IO diagnostic project
    New independent project projects/finger_piano_od_test (device xc3s50an-4-tqg144, clk=P57 12 MHz, no reset pin). p31_test drives ~1 kHz and p32_test ~2 kHz, strictly 0/Z (assign x = en ? 1'b0 : 1'bz), high level from board pull-ups only; UCF constrains only P57/P31/P32 LVCMOS33 with no PULLUP. No changes to finger_piano, P9, formal UCF or any warning allowlist.
    Results: verify-20260917-160206-ec6c1c5b Overall PASS (synthesis 0 errors / 0 warnings / 0 latches, no allowlist; sim PASS: p31 999.992 Hz, p32 1999.984 Hz, duty 0.5, 0 non-0/Z violations). bitstream 20260917-160223-4ac8eeec: MAP/PAR 0/0, 3 bonded IOBs all LOCATED (P57 I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
    [od_test_top.v, tb_od_test_top.v]
2026-09-17 od_test: record authorized volatile JTAG configuration
    program-20260917-160448-8a55fdf0 configured the od_test bitstream into the FPGA fabric (CONFIG_STATUS_OK, M[2:0]=011, DONEIN=1, CRC=0, no Flash/SPI lines). Volatile only; internal ISF still holds the P9 mode-0 image. userDesignFunctional remains NOT_TESTED.
2026-09-17 od_test: replace static-Z idea with runtime 1s complementary open-drain phases
    periph_test_top design replaced: p31_test/p32_test are top-level inout with real open-drain RTL (drive_low ? 1'b0 : 1'bz). A runtime phase register toggles every PHASE_HALF_CYC=12,000,000 clk (1 s at 12 MHz): phase0 p31=Z/p32=LOW, phase1 p31=LOW/p32=Z. Both OBUFTs are driven by runtime signals, so XST cannot constant-fold them (no KEEP/DONT_TOUCH). Added rst_n=P3; UCF now constrains P57/P3/P31/P32 LVCMOS33 with no PULLUP/PULLDOWN.
    verify-20260917-162242-83a5f2d2 Overall PASS: synthesis 0 errors/0 warnings/0 latches; od_test_fast PASS and od_test_real_1s PASS (measured z_width=low_width=12,000,000 clk, 0 non-0/Z v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
    [od_test_top.v, tb_od_test_top.v]
2026-09-17 od_test: record authorized volatile JTAG configuration of 1s complementary design
    program-20260917-162532-7fe23477 configured bitstream 20260917-162326-70a97bfb into the FPGA fabric (CONFIG_STATUS_OK, M[2:0]=011, DONEIN=1, CRC=0, no Flash/SPI lines). Volatile only; internal ISF still holds the P9 mode-0 image. userDesignFunctional remains NOT_TESTED.
2026-09-17 od_test: switch to push-pull 1 kHz on P31/P32/P110 (same phase)
    od_test_top now drives p31_test/p32_test/p110_test as push-pull outputs from one 12 MHz counter (HALF=6000 clk, 50% duty, all three in phase). UCF adds P110 and keeps P57/P3; no PULLUP/PULLDOWN. Replaces the 1s complementary open-drain design (kept in git history).
    verify-20260917-163533-b5de1bae Overall PASS: synthesis 0 errors/0 warnings/0 latches; od_test_fast PASS (12000.000 Hz) and od_test_tone_1k PASS (1000.000 Hz, high=low=6000 clk, 0 level/phase violations). bitstream 20260917-163556-c0d5de09: MAP/PAR 0/0, 5 bonded IOBs all LOCATED (P31/P32/P110 OUTPUT), timing 0 errors/All constraints met, DRC 0/0, design.bit 54738 B S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
    [od_test_top.v, tb_od_test_top.v]
2026-09-17 od_test: record authorized volatile JTAG configuration of push-pull 1 kHz build
    program-20260917-163655-ed791d87 configured bitstream 20260917-163556-c0d5de09 into the FPGA fabric (CONFIG_STATUS_OK, M[2:0]=011, DONEIN=1, CRC=0, no Flash/SPI lines). Volatile only; internal ISF still holds the P9 mode-0 image. userDesignFunctional remains NOT_TESTED.
2026-09-17 periph_test: record authorized ISF re-write of mode-0 diagnostic image
    program-20260917-163937-54107e0d re-programmed the internal ISF with the P9 mode-0 image (20260917-004330-18966658, SHA256 9654a942...764ae09a): erase/program/verify all succeeded, programmingVerified=VERIFIED. After the od_test volatile sessions the fabric no longer matches the ISF, so this restores the persistent P9 diagnostic boot image. Board measurements remain TODO.
2026-09-17 periph_test: override ADS1115 bus to 100 kHz (P9 only, MCP4725 unchanged)
    Only periph_test_top.v changed: localparam P9_ADC_I2C_HZ=100000 passed as .I2C_HZ to the reused ads1115_ctrl instance. The reused driver copy, finger_piano_cfg.vh (CFG_ADC_I2C_SPEED/CFG_DAC_I2C_SPEED remain 333333) and the formal finger_piano Stage-2 config are untouched. At 12 MHz this yields SCL_LOW=16/SCL_HIGH=104 (120 clk period = 100.0 kHz, tLOW=1.333us, tHIGH=8.667us). MCP4725 bus stays 333333 Hz.
    verify-20260917-170347-72d5aef5 Overall PASS: synthesis 0 errors / 144 warnings (all 144 allowlisted, 0 unexpected, allowlist unchanged) / 0 latches; all 7 simulations PASS. bitstream 20260917-170512-33e884e2: MAP/PAR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
    [periph_test_top.v]
2026-09-17 periph_test: record authorized volatile JTAG configuration of ADS 100 kHz mode-0 build
    program-20260917-170737-86a70094 configured bitstream 20260917-170512-33e884e2 (ADS bus 100 kHz, DAC bus unchanged) into the FPGA fabric: CONFIG_STATUS_OK, M[2:0]=011, DONEIN=1, CRC=0, no SPI/Flash lines. The internal ISF still holds the older ADS 333333 Hz mode-0 image, so a power cycle returns to that.
2026-09-21 tone_dac_demo: generate verified bitstream and complete software stages
2026-09-21 tone_dac_demo: record Stage G ISF programming results and pinout guide
2026-09-21 periph_test: implement ADC UART diagnostic version with verified bitstream
2026-09-21 periph_test: record ISF programming results for ADC UART diagnostic version
2026-09-21 periph_test: add FireWater protocol output for CH0 voltage and verify
2026-09-21 feat(oled_test): complete Stage OLED-1 minimal I2C communication test on P104/P105
2026-09-21 feat(oled_test): complete Stage OLED-2 with 1x RAMB16 pre-rendered bitmaps, title ROM, anti-tearing, and NACK handling
2026-09-21 feat(oled): complete Stage OLED-2 with RAMB16_S9 zero-warning and 8-state coverage
2026-09-21 fix(oled): fix power-on delay, anti-tearing frame update, 8-page clear and streamline logic
    [finger_piano_stage2_oled_top.v, oled_fixed_rom.v, oled_i2c_write.v, oled_ssd1306_ctrl.v, oled_test_top.v, tb_oled_test_top.v]
2026-09-21 docs: add OLED integration resource optimization plan
    Document O0-O6 stages, baseline MAP evidence, regression gates, counter sizing, DDS BRAM tradeoffs, and pressure-volume resource budget. Validation: 20 local links, baseline input SHA-256 checks, UTF-8 and Markdown structure, and git diff checks passed. Documentation only; no new RTL simulation, implementation run, or hardware write.
2026-09-21 feat(oled_integration): narrow i2c_master counter widths (O2a, Slices: 686 -> 532)
2026-09-21 feat(oled_integration): narrow dds_sine_generator sample_cnt (O2c, Slices: 513 -> 508)
2026-09-21 feat(oled_integration): narrow sensor_code_filter stable_count (O2d, Slices: 508 -> 500)
2026-09-22 fix(oled_integration): resolve review feedback on NACK test, regression coverage, MAP warning and O5 status
    - [P1] Fix NACK isolation in tb_finger_piano_stage2_oled_top: inject during active transaction ACK slot, verify oled_error=1, init_done=0, bus release, and continuous unaffected ADC/DAC operation
    - [P2] Add OLED hardware power-on delay test (tb_oled_hw_delay.v, SIM_FAST_INIT=0, >=20 ms saturation)
    - [P2] Add counter bit-width boundary matrix tests for i2c_master, ads1115_ctrl, sensor_code_filter, and dds_sine_generator
    - [P2] Add sample-by-sample DAC waveform scoring and 3-channel ADC frame checks to integration testbench
    - [P2] Correct MAP warning in resource_optimization_plan.md to P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
    [tb_ads1115_ctrl.v, tb_dds_sine_generator.v, tb_finger_piano_stage2_oled_top.v, tb_i2c_master.v, tb_oled_hw_delay.v, tb_sensor_code_filter.v]
2026-09-22 feat(oled_integration): sync ADC 100kHz rate and P110 UART error reporting
    [finger_piano_stage2_oled_top.v, finger_piano_stage2_top.v, finger_piano_system.v, tb_finger_piano_stage2_oled_top.v, tb_finger_piano_system.v, tb_uart_tx.v, uart_tx.v]
2026-09-22 feat(finger_piano_oled_integration): integrate UART diagnostic reporter (115200 8N1 on P110) with verified boot, oled, adc, and note status
2026-09-22 diag(adc): distinguish OS timeout from protocol errors and add UART capture
    Diagnostic preparation only; hardware root cause remains unconfirmed.
    ADC unit sim-20260922-163943-5dfc2888 PASS, including protocol error 5,
    OS timeout 4 and recovery. UART offline parser tests PASS.
    Synth 20260922-164020-6043106b completed. Full verify
    verify-20260922-164020-1fd45796 stopped at user request, not a full PASS.
    No new implement, bitstream or board UART test. Handoff documents next steps.
    [ads1115_ctrl.v, tb_ads1115_ctrl.v]
2026-09-22 fix(oled_integration): resolve ADC ERR=4 bug and implement live 3-channel ADC UART reporting
    [ads1115_ctrl.v, finger_piano_stage2_oled_top.v, finger_piano_stage2_top.v, finger_piano_system.v, uart_tx.v]
2026-09-22 docs(oled_integration): add ADC ERR=4 resolution report and update project README
2026-09-22 perf(oled): reclaim logic with DDS BRAM and compact UART reporting
2026-09-23 docs(oled): record 643-slice bitstream live hardware validation and ADC zero-error results
2026-09-23 fix(oled): standardize SSD1306 init sequence and verify 43 tests pass
    [oled_fixed_rom.v, ssd1306_model.v, tb_oled_test_top.v]
2026-09-23 feat(finger_piano): implement inverted pressure calculation and trigger notes from ADC channels
    [finger_piano_stage2_oled_top.v, finger_piano_stage2_top.v, finger_piano_system.v, pressure_channel_corrector.v, pressure_processor.v, tb_finger_piano_stage2_oled_top.v, tb_finger_piano_stage2_top.v, tb_finger_piano_system.v]
2026-09-23 feat(oled): simplify uart output format and adjust pressure threshold for oled refresh
2026-09-23 feat(oled): print real-time voltages and isolate floating sensor pins
2026-09-23 feat(threshold): adapt ch2 pressure threshold to 2400 (2.20v) for 2.0v-2.4v range
2026-09-23 feat(music): add power-on twinkle twinkle little star intro player with auto-handover
2026-09-23 fix(intro): remove false user_touched cut-in to guarantee 11s little star playback
    [finger_piano_stage2_oled_top.v]
2026-09-23 feat(finger_piano): loop See You Again 14-bar melody and excise UART to free slices
