PanGucheng/ISE_prj/(notices)

Notices in the files:
reference/stm32_hal_ssd1306/Core/Src/main.c:
Copyright (c) 2023 STMicroelectronics.
All rights reserved.
This software is licensed under terms that can be found in the LICENSE file
